LenaMatota/MechatronicsProject478/LaTex docs and packages/stellenbosch-2/stellenbosch-2/doc/templates/template-stb-report-eng/chaps-front/chap-symbols.tex

\chapter{List of symbols}
% Use stb-nomenclature + siunitx

\begin{Nomencl}[1cm]
\NomGroup{Abreviations}%-----------------------------------------------
    \item[3D] Three-dimensional
    \item[AI] Artificial Intelligence
    \item[AWG] American wire gauge
    \item[Back-EMF] Back electromotive force
    \item[CAD] Computer-Aided Design
    \item[D-H] Denavit-Hartenberg
    \item[DIP] Design Independent Parameter
    \item[DOF] Degrees-of-freedom
    \item[EC] Evaluation criteria
    \item[ECSA] Engineering Council of South Africa
    \item[EEPROM] Electrically erasable programmable read-only memory
    \item[EMF] Electromotive force
    \item[FBD] Freebody diagram
    \item[FEA] Finite element analysis
    \item[FR] Functional requirement
    \item[GPIO] General pin input/output
    \item[GPS] Global positioning system
    \item[HMI] Human machine interface
    \item[ISR] Interrupt service routine
    \item[MMF] Magnetomotive force
    \item[MOSFET] Metal-oxide-semiconductor field-effect transistor
    \item[NSoI] Narrower system of interest
    \item[PCMA] Portable coordinate measuring arm
    \item[PPR] Pulse per revolution
    \item[PSD] Position sensitive detector
    \item[SCADA] Supervisory control and data acquisition
    \item[SPAT] Single-point articulation test
    \item[SWG] Standard wire gauge
    \item[RHR] Right-hand rule
    \item[TPM] Technical performance measure
    \item[WSoI] Wider system of interest
\end{Nomencl}
