LenaMatota/MechatronicsProject478/LaTex docs and packages/stellenbosch-2/stellenbosch-2/doc/templates/template-stb-report-eng/chaps-front/chap-summary.tex

\chapter{Executive summary}
\noindent
\begin{longtable}{|p{\dimexpr \linewidth-1\tabcolsep-1\arrayrulewidth}|}
	
\hline%------------------------------------------------------------
\sumheading  Title of Project \\
\hline%------------------------------------------------------------
 Joint Design for a Portable Coordinate Measuring Arm (PCMA) \\[1ex]

\hline%------------------------------------------------------------
\sumheading  Objectives \\
\hline%------------------------------------------------------------
 To derive technical performance measures (TPMs) from an error-propagation model, and use them to design, build, and test a position-holding joint that produces a constant, reliable holding torque.\\[1ex]

\hline%------------------------------------------------------------
\sumheading  What is current practice and what are its limitations? \\
\hline%------------------------------------------------------------
 Current joints rely on counterbalancing and lack holding torque, meaning the operator must physically support the arm's weight during operation.\\[1ex]

\hline%------------------------------------------------------------
\sumheading  What is new in this project? \\
\hline%------------------------------------------------------------
 The introduction of a position-holding mechanism specifically engineered using mathematically derived TPMs.\\[1ex]

\hline%------------------------------------------------------------
\sumheading  If the project is successful, how will it make a difference? \\
\hline%------------------------------------------------------------
 It will directly maintain or improve the physical measurement accuracy of the arm. Additionally, it will yield a modified kinematic model to serve as a generalized framework for future accuracy analysis.\\[1ex]

\hline%------------------------------------------------------------
\sumheading  What are the risks to the project being a success? Why is it expected to be successful? \\
\hline%------------------------------------------------------------
 Risks: University workshop manufacturing capabilities may fall short of required tolerances, and the holding mechanism could introduce unwanted friction.
 Expectation of Success: The design requirements are heavily grounded in an established, proven error model.\\[1ex]

\hline%------------------------------------------------------------
\sumheading  What contributions have/will other students made/make? \\
\hline%------------------------------------------------------------
 The project builds directly upon an initial error-propagation model developed by Stellenbosch alumna Leon Hall.\\[1ex]

\hline%------------------------------------------------------------
\sumheading  Which aspects of the project will carry on after completion and why? \\
\hline%------------------------------------------------------------
 The modified error-propagation model. It will be able to accept custom arm dimensions and compute the uncertainty distribution within a given work volume, forming the mathematical foundation for future PCMA development.\\[1ex]

\hline%------------------------------------------------------------
\sumheading  What arrangements have been/will be made to expedite continuation? \\
\hline%------------------------------------------------------------
 Extensive, standardized documentation will be left behind to ensure future researchers can build directly onto this work without repeating groundwork.\\[1ex]

\hline%------------------------------------------------------------
\end{longtable}
