LenaMatota/MechatronicsProject478/Concept design report/Week 9 - Progress Meeting.pptx

Term 4 Week 3 – Progress Meeting

General Update
- Solenoid Yoke redesign
- Experimental setup should be ready be by tomorrow
  - Will confirm for safety verification via email
- Continuing with documentation
