LenaMatota/MechatronicsProject478/General Safety Induction/safety signs.docx

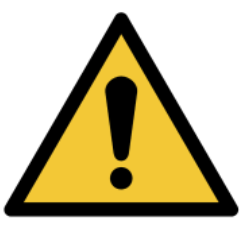
[picture p23: figure]

GENERAL WARNING

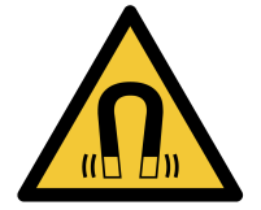
[picture p24: figure]

STRONG MAGNETIC FIELD

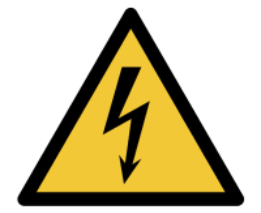
[picture p25: figure]

ELECTRICAL HAZARD

PLEASE DO NOT TOUCH AND KEEP YOUR DISTANCE

IN CASE OF AN EMERGENCY PLEASE CONTACT LENA MATOTA

CELL. NO: 071 569 2349

EMAIL: 24989142@sun.ac.za
