LenaMatota/MechatronicsProject478/SAIMechE Final Year Exhibition _ Poster Template.pdf

# Design, Build, and Test a PCMA Joint

Lena Matota, Kristiaan Schreve, Prof. Department of Mechanical and Mechatronics Engineering, Stellenbosch University

Lena Matota
Department of Mechanical and Mechatronics Engineering, Stellenbosch University
Email: 24989142@sun.ac.za
Website: https://www.linkedin.com/in/lena-matota Phone: +27 71 569 2349

## Contact Information

1. L. Engineering, “The advantages of using a portable cmm arm in metrology,” Leussink Engineering, 2024.
2. S. Ibaraki and R. Saito, “Novel kinematic model of articulated arm coordinate measuringmachinewithangularpositionmeasuremnterrors ofrotaryaxes,”CIRP Annals, vol. 72, no. 1, pp. 449–452, 2023.
3. B. Alvarez, E. Cuesta, P. Luque, D. Mantaras, and D. Muina, “Dynamic deformations in coordinate measuring arms using virtual simulation,” Internation Journal of Simulation Modelling, vol. 14, no. 4, pp. 609–620, 2015.
4. E. Cuesta, D. A. Mantaras, P. Luque, B. J. Alvarez, and D. Muina, “A calibration method of portable coordinate measuring arms by using artifacts,”MAPAN‑Journal of Metrology Society of India, vol. 34, no. 1, pp. 1–11, 2019.
5. L. Hall and K. Schreve, “Error distribution of an articulated arm measurement system,” (Stellenbosch, South Africa), July 2010.
6. H. Meagher, “Measurement tool spotlight‑ portable measuring arms.” OASIS Alignment Service, LLC, February 2016.
7. “Articulated arm coordinate measuring machine calibration by laser tracker multilateration,” The Scienti ic World Journal, vol. 2014, no. 1, p. 681853, 2014.
8. W. Callister and D. Rethwisch, Material Science and Engineering. Hoboken, NJ: Wiley, 8th ed., 2011.
9. FaroArmQuantumXSeries Series User Manual, March 2024.

## References

Portable Coordinate Measuring Arms (PCMAs) are a handheld, metrology instrument used to provide adaptable 3D measurement capabilities for in-line and on-site metrology. However, current joints lack position-holding abilities, due to manual operation. This introduces dynamic positional instability and dynamic structural deformation during measurement.

This project derives technical performance measures (TPMs) from a generalised error-propagation model to design, build, and test an electromagnetic brake integrated with a PCMA joint that maintains measurement accuracy.

## Abstract

## Introduction

- Kinematic Modelling: Generated a six-DOF D-H model based on the Faro QuantumX arm to map spatial coordinate transformations (see Figure 1).
- Error Analysis: Modified and generalised an error-propagation model, first modelled by Stellenbosch Alumnus, Leon Hall, in MATLAB to create uncertainty distributions across a sampled workspace (ranging from 56 to 74 microns).
- Concept Selection: Generated the concepts shown in Figure 3 below. Through evaluation, the PCMA joint with an electromagnetic brake (Figure 3c) was chosen for its superior load capacity and positional stability.

Design Refinement: The electromagnetic brake design was refined into an assembly utilising an optical encoder (GTS06-OC-RA1000B-2M), RS PRO 2-row ball bearings, an IRF640N MOSFET low-side switch controlled by an STM32 Nucleo microcontroller, and an XL7015 step-down buck converter.

## Methods and System Design

- Prototype Implementation Scope: Due to project timelines, material availability and workshop capability, manufacturing and testing focused on constructing key components of the joint design, namely, the electromagnet.
- Fabrication Constraints: Working within workshop capabilities required balancing theoretically requirements against practical manufacturing tolerances, successfully validating core mechanical and electrical operation while highlighting areas for future scale-up.

## Discussion and Prototype Evaluation

Background
- PCMAs operate via multi-axis arm segments equipped with high-resolution angular encoders to capture 3D coordinates.
- Manual operation of the PCMAs causes positional instability and structural deformations because the joints cannot fix their positions independently.

Aim
Design, build and test and PCMA joint with position-holding capabilities without jeopardising its accuracy and ease of movement.

Objectives
Generalise the Denavit-Hartenberg (D-H) model, design and test key joint components, and integrate test results into the model to assess feasibility.

Figure 1. D-H model of Faro QuantumX arm.

REPLACE THIS BOX WITH THE
MAIN SPONSOR’S
ORGANIZATION’S
HIGH RESOLUTION LOGO

I would like to express my gratitude to my supervisor, Prof. K. Schreve, for his guidance, expert insight, and continuous support throughout this project. Special thanks is extended to the technical staff of the Department of Mechanical and Mechatronics Engineering, as well as the Department of Electrical and Electronics Engineering for their assistance with prototype fabrication and component sourcing. Lastly, I grateful to my family and peers for their constant encouragement and support throughout my studies at Stellenbosch University.

## Acknowledgements

- Ongoing Performance Verification: Conclude full experimental validation of the prototype’s holding force capacity under operational cycles as seen in the setup depicted by Figure 5.

## Future Directions

REPLACE THIS BOX WITH
YOUR ORGANIZATION’S
HIGH RESOLUTION LOGO

Figure 2. Error-Propagation Model

Figure 3. Generated Concepts

Figure 3a. PCMA Joint with Locking Dial

Figure 3b. PCMA Joint with Counterbalance Spring

Figure 3c. PCMA Joint with Electromagnetic Brake

Figure 4a. PCMA Joint with Electromagnetic Brake Assembly

Figure 4b. Wiring Diagram of electronics implementation
Figure 4. Refined PCMA design

Figure 5. Testing Setup
