LenaMatota/MechatronicsProject478/LaTex docs and packages/stellenbosch-2/stellenbosch-2/doc/templates/template-stb-report-eng/template-stb-report-eng.tex

% !TeX encoding = UTF-8
% !TeX program  = xelatex

\documentclass[12pt,a4paper,openany]{book} 
\usepackage[typeblock=golden]{stb-titlepage}        

%==== Math setup =====================================================
\usepackage{amsmath}%............................. Advanced math (before fonts)
%\usepackage{amssymb}%............................ AMS Symbol fonts

%==== Font setup =====================================================
\usepackage{iftex}
\ifxetex
    \usepackage[math-style=TeX,
                bold-style=TeX,
               ]{unicode-math}
    \setmainfont{Cambria}%........................ Unicode fonts  (Win)                
    \setsansfont[Scale=MatchLowercase]{Calibri}
    \setmonofont[Scale=MatchLowercase]{Consolas}
    \setmathfont{Cambria Math}
    \defaultfontfeatures{Ligatures=TeX}
    \let\bm\symbfit
\else
    \usepackage[utf8]{inputenc}%.................. Unicode file format
    \usepackage{textcomp}%........................ Additional text symbols
    \usepackage[T1]{fontenc}%..................... Type 1 outline fonts
    \usepackage{bm}%.............................. Bold math fonts
\fi
\normalfont
\usepackage[expansion=false, protrusion=true]{microtype}
\usepackage{float}
\usepackage{enumitem}
\usepackage[table]{xcolor}

%==== Units and numbers ==============================================
\usepackage{siunitx}%............................. Unit, number and angle output
    \sisetup{detect-all = true, detect-family = true}
    \sisetup{output-decimal-marker = {.} ,
             group-separator = {\,},
             number-unit-product = {\,},
             inter-unit-product = \mathord{\cdot},
             exponent-product = \mathord{\times},
             separate-uncertainty = true}
         
%==== Ref's, Bib's and Nomencl =======================================
\usepackage{stb-nomencl}%......................... List of symbols 
\renewcommand*{\UnitLabel}[1]{~[\,\unit{#1}\,]}
\usepackage{stb-bib}%............................. Bibliography (natbib internally)
\usepackage{pdfpages}
\usepackage{multirow}
\setcitestyle{numbers} % <--- THIS IS THE MISSING LINE
\bibliographystyle{ieeetr}
\renewcommand\bibfont{\small}
\renewcommand\bibsection{\chapter{\bibname}}

%==== Tables + Graphics + Color =====================================
\usepackage{array}%............................... Extended table defs 
    \setlength{\extrarowheight}{2pt}
\usepackage{longtable}%........................... Tables can break over pages
\usepackage{tabularx}
\usepackage{xltabular}
\usepackage{graphicx}%............................ Included graphics
\graphicspath{{chaps-main/}{chaps-append/}} % <--- ADD THIS LINE
\usepackage[font=small]{caption}%................. Customize captions  
\usepackage[table]{xcolor}%....................... Color setup + colortbl 
\usepackage{subcaption}
\usepackage{booktabs}
\usepackage{threeparttable}
\usepackage[bottom]{footmisc}
\usepackage{pdflscape}
    
%==== Extra defs for template ========================================
\makeatletter
%---- TOC entries and case
    \renewcommand\contentsname{Table of contents}
    \renewcommand\listfigurename{List of figures}
    \renewcommand\listtablename{List of tables}
    \renewcommand\bibname{List of references}
    
    \renewcommand\tableofcontents{\chapter*{\contentsname}\@starttoc{toc}}
    \renewcommand\listoffigures{\chapter{\listfigurename}\@starttoc{lof}}
    \renewcommand\listoftables{\chapter{\listtablename}\@starttoc{lot}}

%---- Plagiarism signatures
    \newcommand\tstrut[1][4ex]{\rule{0pt}{#1}}
    \newcommand\tdots[1][5cm]{\makebox[#1]{\dotfill}}

%---- Summary head line
    \newcommand\sumheading{%
        \rowcolor[gray]{.9}%
        \centering\arraybackslash%
        \bfseries\normalsize}

%==== User Defs ======================================================
%
% Please insert user defined commands here
% and NOT in the document itself!
%
%
\makeatother

%==== Title Page =====================================================
\title{\textbf{Joint Design for a Portable Coordinate Measuring Arm (PCMA)}\\[2ex]
       \large Mechatronic Project 478\\Final Report\\[2ex]}                   
\author{\Large Author: Lena Matota\\ 
        \large 24989142 \\[5ex]
        \Large Supervisor: Prof. K Schreve}                
\address{Department of Mechanical and Mechatronic Engineering\\
        Stellenbosch University \\
        Private Bag X1, Matieland 7602, South Africa.}
\date{2026/10/23}                             
\Copyright{2023}{Stellenbosch University.\\ All rights reserved.}

%==== Main Document ==================================================
\setcounter{secnumdepth}{3}
\setcounter{tocdepth}{2}
\raggedbottom
\begin{document}   

\frontmatter%---------------------------------------------------------                    
\maketitle 

\include{chaps-front/chap-plagiarism}
\include{chaps-front/chap-AI-use-2024}
\include{chaps-front/chap-summary}
\include{chaps-front/chap-ECSA}
\include{chaps-front/chap-acknowledge}

% Use \chapter*{} before TOC
\tableofcontents
% Use \chapter{} after TOC

\listoffigures
\listoftables
\include{chaps-front/chap-symbols}

\let\cleardoublepage\clearpage
\mainmatter%----------------------------------------------------------
\numberwithin{figure}{chapter}
\numberwithin{table}{chapter}

\include{chaps-main/chap-intro}
\include{chaps-main/chap-literature}
\include{chaps-main/chap-requirement_analysis}
\include{chaps-main/chap-concept_development}
\include{chaps-main/chap-design_analysis}
\include{chaps-main/chap-design_evaluation_and_testing}
\include{chaps-main/chap-eol}
\include{chaps-main/chap-conclusion}

\appendix%------------------------------------------------------------
\include{chaps-append/chap-bom}              
\include{chaps-append/chap-design_calc}     
\include{chaps-append/chap-drawing_pack}     
\include{chaps-append/chap-project_schedule} 

\backmatter%----------------------------------------------------------
\bibliography{bib/bib-sample}
 
\end{document}
