LenaMatota/MechatronicsProject478/LaTex docs and packages/stellenbosch-2/stellenbosch-2/doc/templates/template-stb-report-eng/chaps-front/chap-plagiarism.tex

\chapter*{Plagiarism Declaration}
%\section*{Plagiarism Declaration}

\begin{enumerate}
	\item Plagiarism is the use of ideas, material and other intellectual property of another's work and to present it as my own.
	
	\item I agree that plagiarism is a punishable offence because it constitutes theft.
	
	\item I also understand that direct translations are plagiarism.
	
	\item Accordingly all quotations and contributions from any source whatsoever (including the internet) have been cited fully. I understand that the reproduction of text without quotation marks (even when the source is cited) is plagiarism.
	
	\item I declare that the work contained in this assignment, except where otherwise stated, is my original work and that I have not previously (in its entirety or in part) submitted it for grading in this module/assignment or another module/assignment.
\end{enumerate}
\noindent
\begin{tabularx}{\textwidth}{|X|p{4cm}|}
	\hline
	&                       \\[4ex]
	Student number          & Signature \\
	\hline
	&                       \\[4ex]
	Initials and surname    & Date      \\
	\hline
\end{tabularx}
