LenaMatota/MechatronicsProject478/LaTex docs and packages/stellenbosch-2/stellenbosch-2/doc/templates/template-stb-report-eng/chaps-front/chap-AI-use-2024.tex

\chapter*{AI Use Declaration}

{\setlength\labelwidth{1em}%
 \setlength\labelsep{5pt}%
 \setlength\itemindent{0pt}%
 \setlength\leftmargini{\labelwidth}%
 \setlength\topsep{0pt}%
 \setlength\partopsep{0pt}%
\begin{enumerate}
    \setlength\itemsep{\smallskipamount}%
    \setlength\parskip{0pt}%
    \small
    
    \item I am convinced and can support my claim that my assessment product is an indication of my own learning, knowledge, skills, and understanding.
    
    \item Where I have used AI tools for enhancing my own creation of ideas and words, I acknowledge that I have to declare it.
    
    \item Where I have used AI tools for generating new ideas, words, code, image-prompts for other AI Image-generating tools, or structure and even presentations (or other AI tools that can be used as assistants to the knowledge building and representing process), I have declared and documented the use of such tools and I am prepared to talk about the process I used and what it contributed to my learning and insights.
    
    \item I am aware that the lecturer can ask me to demonstrate my learning, for example through explaining the choices I made in terms of approach, content used, literature selected, conclusions drawn, etc. through an additional assessment like an oral (for example).
    
    \item I understand that if I am not able to agree to the above points, there is a chance that my academic behaviour will be deemed unethical and might lead to a disciplinary case being brought against me on the grounds of cheating or plagiarism and that the standard procedures for such behaviour will be followed.
    
    \item As per the Disciplinary Code of SU (par. 10.2.1 and 10.2.2), I understand that I take responsibility for the integrity of my work, which includes the obligation to ask for clarification from an academic member of staff if I am unsure of anything, and that I strictly adhered to all instructions received in the course of the academic assessment by relevant and authorized staff (whether the instruction is in oral or written format).
    
    \item I understand that when I am not able to document and declare my use of AI tools, this behaviour will be deemed as cheating in examinations and assessments (Disciplinary Code 1.1 c.) as I referred to “unauthorized notes, books, electronic devices or other reference material”.
\end{enumerate}}
\vspace{10mm}

\noindent
\begin{tabular}{@{}lllll@{}}
\tstrut Signature: &\tdots&	           &            \\
\tstrut Name:      &\tdots& Student no:&\tdots[3cm] \\
\tstrut Date:      &\tdots&            &            \\
\end{tabular}
