LenaMatota/MechatronicsProject478/Executive Summary.docx

# Executive Summary

Title of Project

Objectives

What is current practice and what are its limitations?

What is new in this project?

If the project is successful, how will it make a difference?

What are the risks to the project being a success? Why is it expected to be successful?

What contributions have/will other students made/make?

Which aspects of the project will carry on after completion and why?

What arrangements have been/will be made to expedite continuation?
