LenaMatota/MechatronicsProject478/Week 3/Week 3 - Progress Review.pptx

Week 3 Progress Meeting – L Matota, 24989142

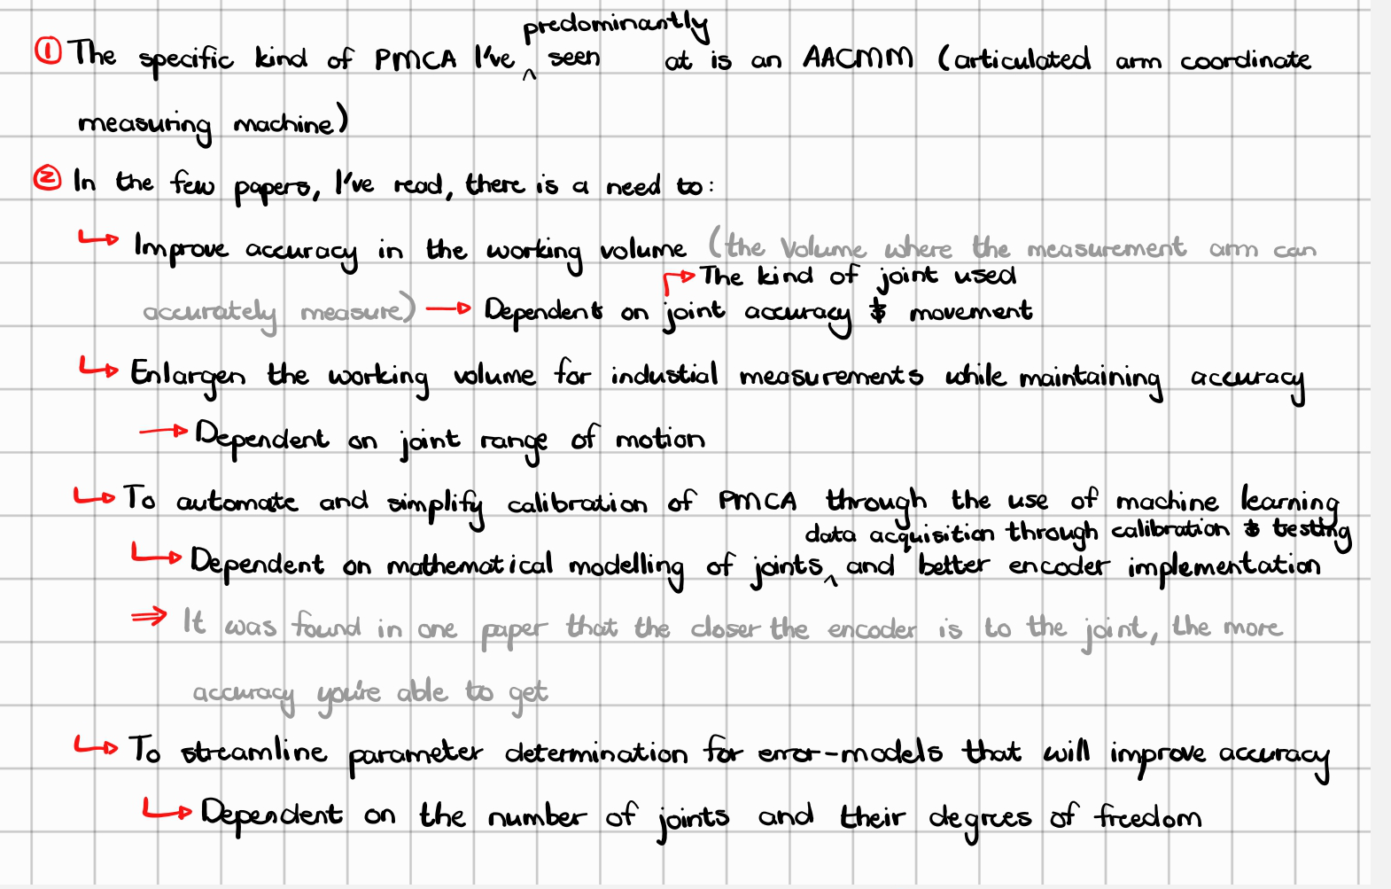
[picture p43: figure]
