LenaMatota/MechatronicsProject478/Concept design report/AI -generated concept designs w-o heading.png

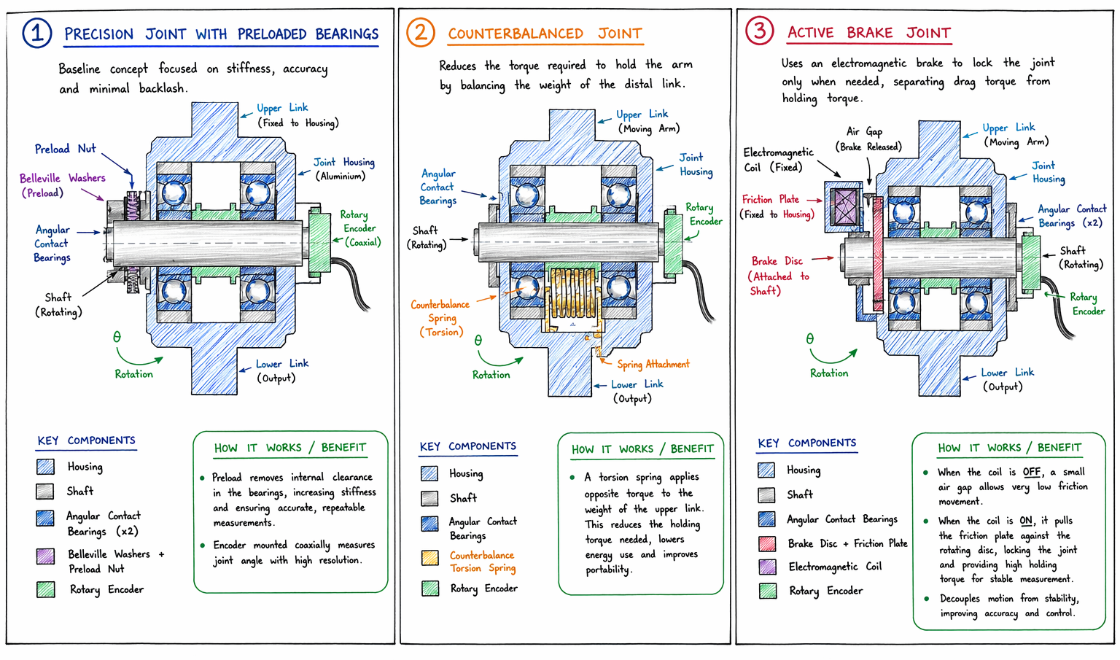
Concept design report/AI -generated concept designs w-o heading.png
