LenaMatota/MechatronicsProject478/Concept design report/AI -generated concept designs.png

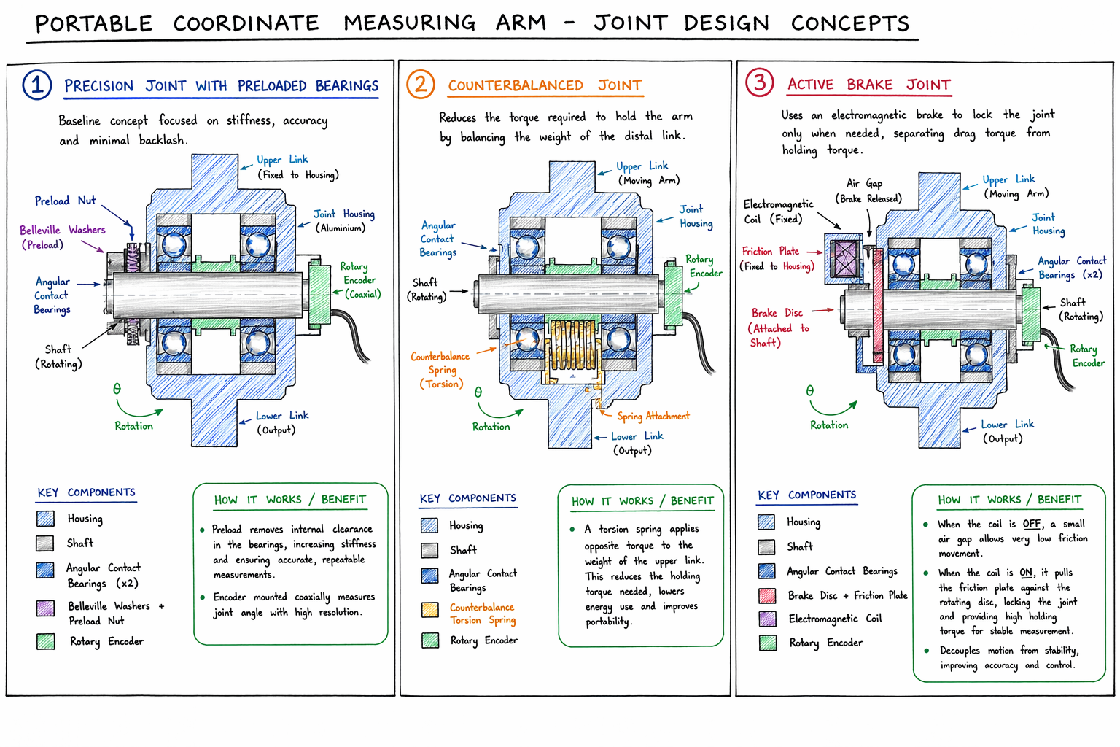
Concept design report/AI -generated concept designs.png
