LenaMatota/MechatronicsProject478/Concept design report/Concept 1.png

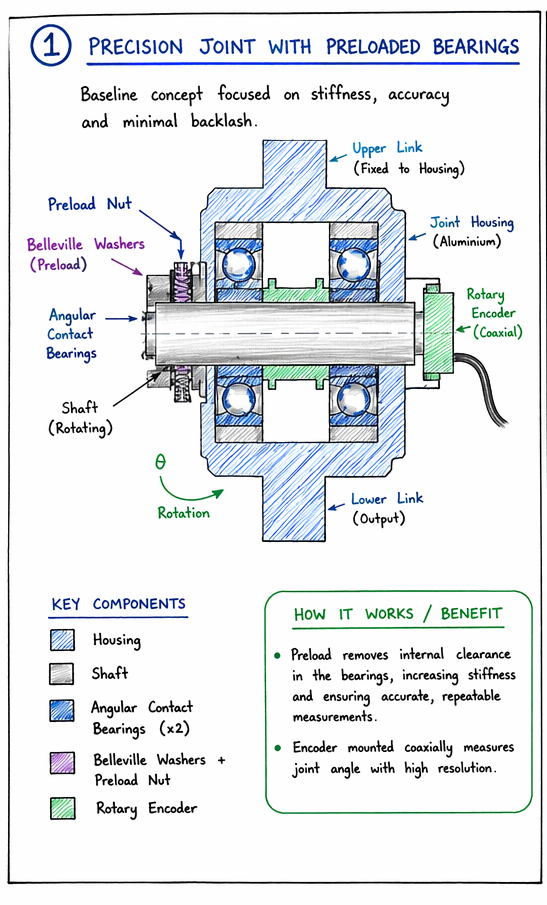
Concept design report/Concept 1.png
