LenaMatota/MechatronicsProject478/Concept design report/Concept 2.png

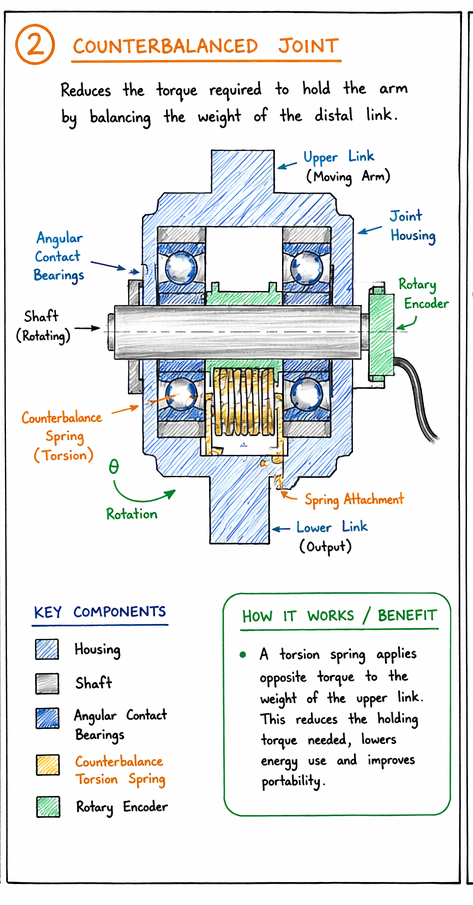
Concept design report/Concept 2.png
