LenaMatota/MechatronicsProject478/Concept design report/Concept 3.png

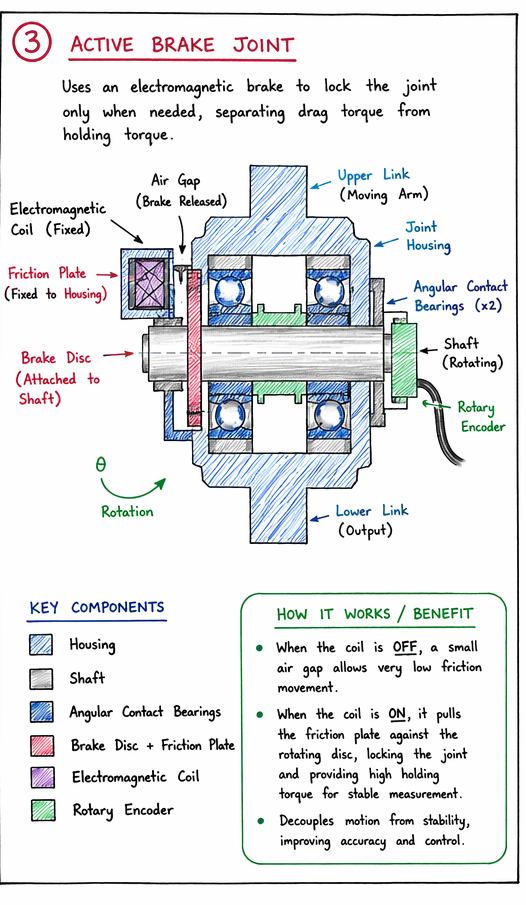
Concept design report/Concept 3.png
