LenaMatota/MechatronicsProject478/Concept design report/DH model of Faro arm.png

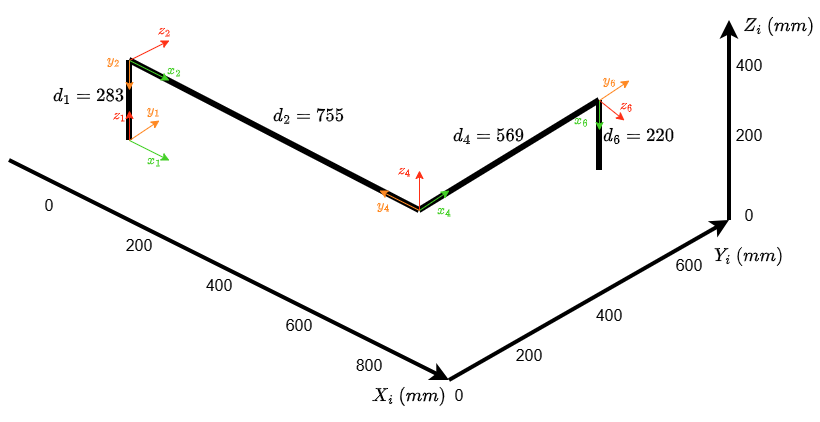
Concept design report/DH model of Faro arm.png
