LenaMatota/MechatronicsProject478/Concept design report/Final concept with labels.jpg

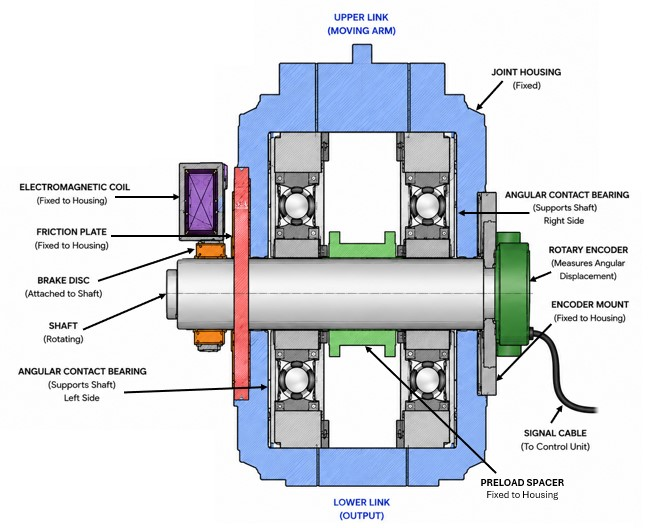
Concept design report/Final concept with labels.jpg
