LenaMatota/MechatronicsProject478/Concept design report/Powerpoint slides background.jpg

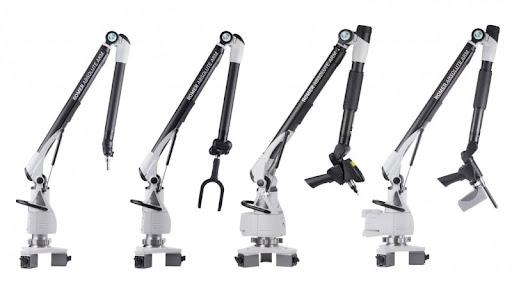
Concept design report/Powerpoint slides background.jpg
