LenaMatota/MechatronicsProject478/General Safety Induction/Screenshot_20260914_224840_Samsung Notes.jpg

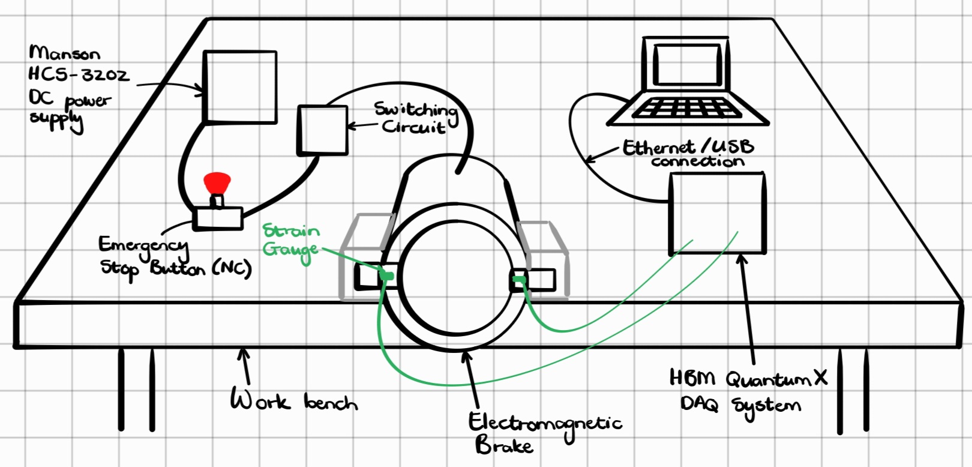
General Safety Induction/Screenshot_20260914_224840_Samsung Notes.jpg
