LenaMatota/MechatronicsProject478/General Safety Induction/Wear eye protection.png

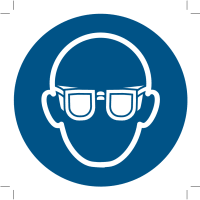
General Safety Induction/Wear eye protection.png
