LenaMatota/MechatronicsProject478/Lena's skripsie vlog/20260921_082056.jpg

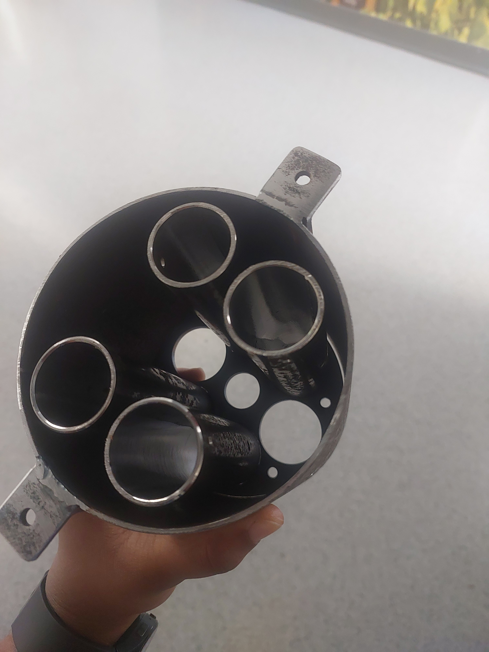
Lena's skripsie vlog/20260921_082056.jpg
