LenaMatota/MechatronicsProject478/Lena's skripsie vlog/IMG-20260922-WA0012.jpeg

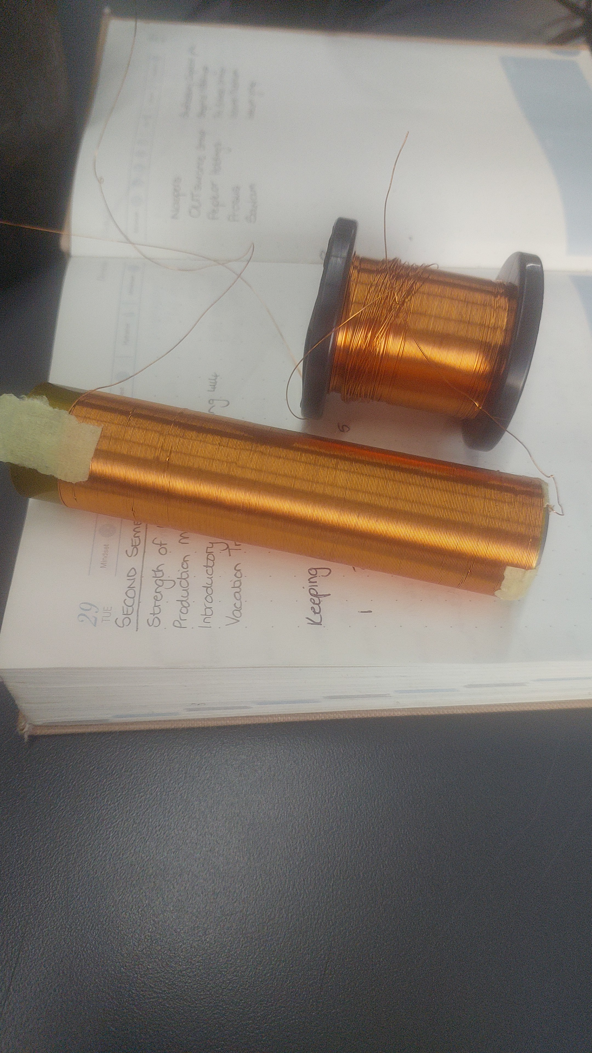
Lena's skripsie vlog/IMG-20260922-WA0012.jpeg
