LenaMatota/MechatronicsProject478/Week 3/Screenshot_20260224_151306_Samsung Notes.jpg

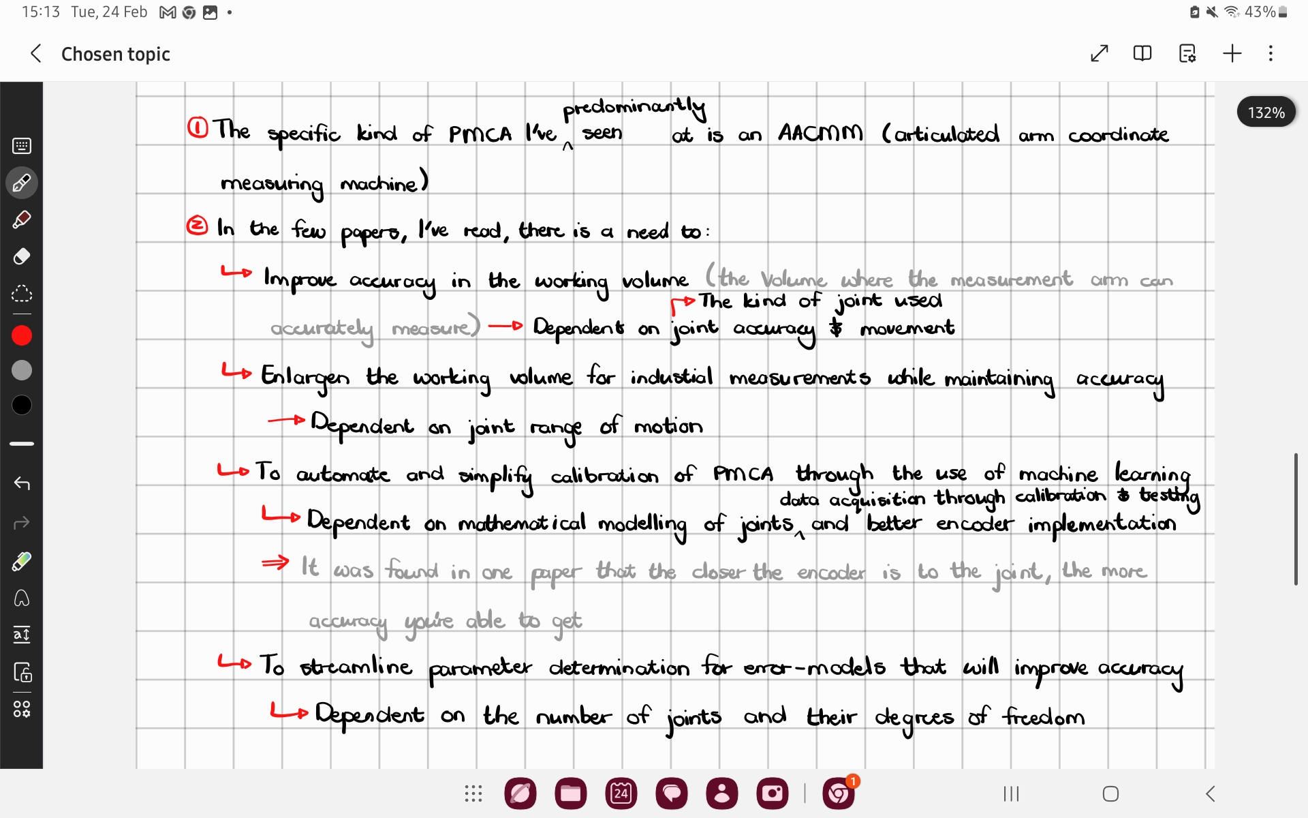
Week 3/Screenshot_20260224_151306_Samsung Notes.jpg
