LenaMatota/MechatronicsProject478/LaTex docs and packages/stellenbosch-2/stellenbosch-2/doc/templates/template-stb-report-eng/chaps-append/chap-bom.tex

\chapter{Bill of Materials}
\label{ch:bill_of_materials}

This appendix provides the itemized Bill of Materials (BOM) for the electromagnetic brake joint assembly. All prices reflect verified vendor quotations, retail receipts, and university workshop billing records inclusive of 15\% VAT.

\begin{table}[H]
	\centering
	\caption{Detailed Bill of Materials (BOM) for Joint Prototype}
	\label{tab:detailed_bom}
	\resizebox{\linewidth}{!}{%
		\begin{tabular}{lllccrr}
			\toprule
			\textbf{Category} & \textbf{Part Description} & \textbf{Supplier / Part No.} & \textbf{Qty} & \textbf{Unit Price} & \textbf{Total (ZAR)} \\
			\midrule
			\textbf{Mechanical}  & Laser-cut Electromagnetic Cover & Fabrinox / 24989142-01-01 & 5 & R 25.81 & R 129.05 \\
			& Laser-cut Pressure Platform     & Fabrinox / 24989142-01-02 & 5 & R 2.38  & R 11.90 \\
			& Laser-cut Friction Plate        & Fabrinox / 24989142-01-03 & 5 & R 9.18  & R 45.90 \\
			& 20mm ID 2-Row Ball Bearings     & RS / 2204-2RSTN           & 2 & R 345.29 & R 690.58 \\
			& Ruland Rigid Shaft Coupling     & RS / MCLX-20-20-F         & 1 & R 869.67 & R 869.67 \\
			& 32mm OD Steel Shaft Collars     & RS / 8236976              & 2 & R 62.42  & R 124.84 \\
			& Raw Material Steel / Aluminium  & SU Workshop Stock         & 1 & R 3 084.81 & R 3 084.81 \\
			\midrule
			\textbf{Electrical}  & Enamelled Copper Wire (0.28mm)  & RS / CUL 100/0,28         & 4 & R 187.66 & R 750.64 \\
			& Infrared IRF640NPBF MOSFETs     & RS / IRF640NPBF           & 6 & R 24.05  & R 144.30 \\
			& Schottky Diodes STPS20H100CT    & RS / STPS20H100CT         & 6 & R 9.12   & R 54.72 \\
			& Red Hook-Up Wire (4m Reel)      & RS / 50747-4              & 2 & R 226.17 & R 452.34 \\
			& High-Temp Kapton Insulation Tape & Takealot Retail           & 1 & R 299.99 & R 299.99 \\
			& TIP41C / 2N3904 BJTs \& Board    & Lab Stock                 & 1 set & R 120.00 & R 120.00 \\
			\midrule
			\textbf{Sensors \&}  & Optical Encoder (1000 PPR)      & Micro Robotics / GTS06    & 1 & R 668.00 & R 668.00 \\
			\textbf{Power}       & Step-Down Buck Regulator        & Micro Robotics / XL7015   & 1 & R 30.00  & R 30.00 \\
			& Shipping \& Delivery Fees       & RS / Micro Robotics       & 1 set & R 567.77 & R 567.77 \\
			\midrule
			\textbf{Labor}       & Workshop Machining (18.5 hrs)   & SU Workshop / Paulse      & 18.5 & R 650.00 & R 12 025.00 \\
			\midrule
			\textbf{Grand Total} & & & & & \textbf{R 19 977.55} \\
			\bottomrule
		\end{tabular}%
	}
\end{table}
