LenaMatota/MechatronicsProject478/Skripsie resources/List of Equipment Available in Mechanical & Mechatronic Engineering Store 2026.xlsx

Sheet: List of HBM Equipment
LOADCELLS |  |  |  |  |  | Booked Out
Type | Asset Number | Serial Number | Range | Cost-Point used with Purchase | Remarks | Name | Student Number | Date Taken
Round Type-U2A | '400064'!A1 | B73498 | 10kN - 1000kg | 0280 |  | E Stockhalm | 23648341 | 18/08/2025 | RETURNED
Round Type-U2A | '400065'!A1 | C16754 | 10kN - 1000kg | 0280 |  | A. Turner | 25928333 | 2025-10-08 | RETURNED
Round Type-U2A | '400067'!A1 | F23715 | 10kN - 1000kg | 0280 |  | M. Nimb | 24776661 | 2025-10-08 | RETURNED
Round Type-U2A | '400066'!A1 | E99828 | 2kN - 200kg | 0280 | Broken | M. Nimb | 24776661 | 26/08/2025 | RETURNED
Round Type | '408763'!A1 | 088671 | 500N - 50kg | 0280N |  | James Ralph | 19904150 | 2023-06-03 | RETURNED
Round Type | '408764'!A1 | 083931 | 1kN - 100kg | 0280N |  | Name | Student Number | Date Taken | Date Returned
U2AD1/2T - Round Type | '485376'!A1 | 026925 | 20kN - 2000kg |  |  | JW Van Santen | 18326498 | 20/07/2020 | RETURNED
U2AD1/2T - Round Type | '485377'!A1 | 028563 | 20kN - 2000kg |  |  | JW Van Santen | 18326498 | 20/07/2020 | RETURNED
Z-Type SM2 | '443733'!A1 | 02718726 | 50N - 5kg | 0280N |  | AV Covoy | 19774869 | 2021-12-10 | RETURNED
Z-Type SM2 | '443734'!A1 | 02718733 | 50N - 5kg | 0280N |  | Steenkamp | 19777701 | 2021-09-04 | 18/05/2021
Z-Type SM2 | '443735'!A1 | 02718686 | 50N - 5kg | 0280N |  | L De Wet | 23743468 | 2022-09-08 | RETURNED
Z-Type SM2 | '443736'!A1 | 02918009 | 50N - 5kg | 0280N |  | L De Wet | 23743468 | 21/08/2023 | RETURNED
Z-Type SM2 | '443610'!A1 | 02918017 | 50N - 5kg | 0284N |  | G Stephan | 20150679 | 15/09/2020 | 29/01/2021
Z-Type SM2 | '443737'!A1 | 02549146 | 100N - 10kg | 0280N | Broken | Name | Student Number | Date Taken | Date Returned
Z-Type SM2 | '443738'!A1 | 02718704 | 100N - 10kg | 0280N |  | Name | Student Number | Date Taken | Date Returned
Z-Type SM2 | '443739'!A1 | 02718813 | 100N - 10kg | 0280N |  | E Stockhalm | 23648341 | 20/08/2025 | OUTSTANDING
Z-Type SM2 | '443740'!A1 | 02718808 | 100N - 10kg | 0280N |  | J Van Zyl | 20858795 | 18/08/2022 | 26/04/2023
Z-Type SM2 | '443741'!A1 | 02917885 | 200N - 20kg | 0280N | Broken | Name | Student Number | Date Taken | Date Returned
Z-Type SM2 | '443742'!A1 | 02917886 | 200N - 20kg | 0280N | Broken | CR Sauls | 20778465 | 14/10/2021 | RETURNED
Z-Type SM2 | '443743'!A1 | 02917896 | 200N - 20kg | 0280N | Broken | Name | Student Number | Date Taken | Date Returned
Z-Type SM2 | '443744'!A1 | 02917906 | 200N - 20kg | 0280N |  | Josua Van Tonder | 21059721 | 16/09/2022 | 2023-05-09
 |  |  |  |  |  | Petrus Haasbroek | 19855400 | 2022-02-11 | 2023-05-09
Z-Type SM2 | '443745'!A1 | 31050691 | 1kN - 100kg | 0280N |  | Nadeem Davids | 21160503 | 2023-08-11 | 14/08/2023
Z-Type SM2 | '443748'!A1 | 31137976 | 1kN - 100kg | 0280N | Broken | Name | Student Number | Date Taken | Date Returned
Z-Type SM2 | '443746'!A1 | 31127524 | 5kN - 500kg | 0280N |  | PC Swanepoel | 16622766 | 2025-04-11 | RETURNED
Z-Type SM2 | '443747'!A1 | 31127531 | 5kN - 500kg | 0280N | Broken | PC SWanepoel | 16622766 | 2025-04-09 | RETURNED
U2B 200kN | '459962'!A1 | N79647 | 200kN | 0280N |  | JW van Santen | 18326498 | 2019-11-18 | RETURNED
U2B 100kN | '459961'!A1 | N87983 | 100kN | 0280N |  | JW van Santen | 18326498 | 2019-11-18 | RETURNED
U2B 50kN | '459960'!A1 | N99085 | 50kN | 0280N |  | Daniel Raats | 21645655 | 2024-05-03 | RETURNED
U2B 20kN | '459959'!A1 | N93342 | 20kN | 0280N |  | R Louw | 22550798 | 14/09/2022 | RETURNED
S9M/10kN | '487810'!A1 | 31733148 | 10kN - 1000kg |  |  | C vd Westhuizen | 24194379 | 2025-04-30 | RETURNED
U9C/2kN | '468620'!A1 | 211010672 | 2kN - 200kg |  |  | Josua Van Tonder | 1902243 | 2020-12-10 | RETURNED
SP4C3 |  | 00495870 | 20kg
SP4C3 |  | 01373560 | 20kg
SP4C3 |  | 29306036 | 20kg
SP4C3 |  | 29330086 | 20kg
SP4C3 |  | 11602081 | 30kg
SPM4C3MR |  | 02184452 | 30kg
SP4C3
PRESSURE TRANSDUCERS |  |  |  |  |  | Booked Out
Type | Asset Number | Serial Number | Range | Cost-Point used with Purchase | Remarks | Name | Student Number | Date Taken | Date Returned
Absolute Pressure | '466932'!A1 | 801247177 | 0-10 BAR | 0280N |  | Jaco Laas | 24483451 | 03 Junie 2021 | RETURNED
Absolute Pressure | '466933'!A1 | 801222951 | 0-10 BAR | 0280N |  | Chaz Fenner | Student Number | 15/02/2021 | RETURNED
Absolute Pressure | '466934'!A1 | 801247177 | 0-10 BAR | 0280N |  | S De WIT | 21586144 | 2021-01-10 | Returned
Absolute Pressure | '466935'!A1 | 801247177 | 0-10 BAR | 0280N |  | Name | Student Number | Date Taken | Date Returned
Absolute Pressure | '466936'!A1 | 801245349 | 0-10 BAR | 0280N |  | D Sheni | 22594671 | 2022-03-10 | RETURNED
Absolute Pressure | '466937'!A1 | 801245349 | 0-10 BAR | 0280N |  | 22594671 | Sheni | 2022-03-10 | RETURNED
Absolute Pressure | '466938'!A1 | 801245349 | 0-10 BAR | 0280N |  | D Sheni | 22594671 | 2022-03-10 | RETURNED
Absolute Pressure | '466939'!A1 | 801245349 | 0-10 BAR | 0280N |  | Jaco Laas | 24483451 | 2022-11-04 | RETURNED
CLIP AMPLIFIERS |  |  |  |  |  | Booked Out
Type | Asset Number | Serial Number |  | Cost-Point used with Purchase | Remarks | Name | Student Number | Date Taken | Date Returned
AE301 | '459967'!A1 | 824761013 | - | 0280N |  | Name | Student Number | Date Taken | Date Returned
AE301 | '459968'!A1 | 824761014 | - | 0280N |  | Name | Student Number | Date Taken | Date Returned
AE301 | '459969'!A1 | 824761015 | - | 0280N |  | Name | Student Number | Date Taken | Date Returned
AE301 | '459970'!A1 | 824761032 | - | 0280N |  | Name | Student Number | Date Taken | Date Returned
AE301 | '443753'!A1 | 819402718 | - | 0280N |  | Name | Student Number | Date Taken | Date Returned
AE301 | '253339'!A1 |  | - | 0280 |  | Name | Student Number | Date Taken | Date Returned
AE301 | '443752'!A1 | 819402717 | - | 0280N |  | Name | Student Number | Date Taken | Date Returned
AE301 | '485261'!A1 |  | - | 0290N |  | Name | Student Number | Date Taken | Date Returned
AE301 | '485262'!A1 |  | - | 0290N |  | Name | Student Number | Date Taken | Date Returned
AE301 | '485263'!A1 |  | - | 0290N |  | Ruan Louw | 22558798 | 14/09/2022 | 2022-12-10
AE301 | '485264'!A1 |  | - | 0290N |  | Name | Student Number | Date Taken | Date Returned
AE301 | '485265'!A1 |  | - | 0290N |  | Name | Student Number | Date Taken | Date Returned
AE501 | '253343'!A1 |  | - | 0280 |  | Name | Student Number | Date Taken | Date Returned
AE501 | '253340'!A1 |  | - | 0280 |  | Name | Student Number | Date Taken | Date Returned
AE501 | '459971'!A1 | 824734801 | - | 0280N |  | B Ndika | Student Number | Date Taken | RETURNED
AE501 | '459972'!A1 | 824734823 | - | 0280N |  | Name | Student Number | Date Taken | Date Returned
AE501 | '459973'!A1 | 824734824 | - | 0280N |  | Llewellyn | Student Number | Date Taken | Date Returned
AE501 | '459974'!A1 | 824734825 | - | 0280N |  | Name | Student Number | Date Taken | Date Returned
AE501 | '253341'!A1 |  | - | 0280 |  | Name | Student Number | Date Taken | Date Returned
AE501 | '253342'!A1 |  | - | 0280 |  | Name | Student Number | Date Taken | Date Returned
AE501 | '253344'!A1 |  | - | 0280 |  | Name | Student Number | Date Taken | Date Returned
AE501 | '253345'!A1 |  | - | 0280 |  | Name | Student Number | Date Taken | Date Returned
AE501 | '443750'!A1 |  | - | 0280N |  | Name | Student Number | Date Taken | Date Returned
AE501 | '443751'!A1 | 819334204 | - | 0280N |  | MC Nimb | 24776661 | 28/08/2025 | OUTSTANDING
QUANTUMX |  |  |  |  |  | Booked Out
Type | Asset Number | Serial Number | Description | Cost-Point used with Purchase | Remarks | Name | Student Number | Date Taken | Date Returned
MX410 | '443758'!A1 | 0009E5004CE6 | 4-Channel | 0280N |  | SJ NOland | 3581662 | 2025-09-17 | RETURNED
MX410 | 441960'!A1 | 0009E5004B96 | 4-Channel | 0280N | Channel 1 Faulty | PC Swanepoel | 16622766 | 2025-04-14 | OUTSTANDING
MX840B | '459956'!A1 | 0009E5007DD | 8-Channel | 0280N | Channel 5 Faulty | James Ralph | 23233737 | 2025-04-14 | RETURNED
MX440B | '466921'!A1 | 0009E5007DDB | 4-Channel | 0280N | Was al herstel | EM LOUW | 24817236 | 2021-08-02 | RETURNED
MX440B | '485408'!A1 | 0009E500E684 | 4-Channel | 0284N | New - Dr Els? | Name | Student Number | Date Taken | Date Returned
MX1601B | '450521'!A1 | 801218167 | 16-Channel | 0280N | Used on SA Agulhas | DR Adams | 20299028 | 30/08/2022 | 2021-03-08
MX1609 | '443757'!A1 | 0009E50044F1 | 6-Channel Thermocouple | 0280N |  | Tamara Allen | 19944306 | 2021-08-06 | RETURNED
MX440B | '459957'!A1 | 0009E5007AOA | 4-Channel | 0280N |  | JM Wahl | 25939114 | 2025-09-08 | RETURNED
MX460B | 536093'!A1 | 0009E5024A7A | 4-Channel |  |  | Llewellyn | 22793429 | 2025-03-28 | RETURNED
MX840B | 437406'!A1 | 0009E5026584 | 8-Channel |  |  | Mr. J Bredell | 22793429 | 2025-08-05 | RETURNED
MX1615 |  |  | 8-Channel
QUANTUMX |  | 801433534 | 15-Channel
QUANTUMX |  | 801433534 | Strain gauge quarter-bridge
QUANTUMX |  | 801433534 | Strain gauge quarter-bridge
QUANTUMX |  | 801433534 | Strain gauge quarter-bridge
QUANTUMX |  | 801433534 | Strain gauge quarter-bridge
QUANTUMX |  | 801433534 | Strain gauge quarter-bridge
QUANTUMX |  | 801433534 | Strain gauge quarter-bridge
QUANTUMX |  | 801433534 | Strain gauge quarter-bridge
DISPLACEMENT METERS |  |  |  |  |  | Booked Out
Type | Asset Number | Serial Number | Range | Cost-Point used with Purchase | Remarks | Name | Student Number | Date Taken | Date Returned
1- WA/20MM-L | '459963'!A1 | 194710158 | WA-20mm-L | 0280N |  | JM WAHL | 25939114 | 2025-09-08 | OUTSTANDING
1-WA/50MM-L | '459964'!A1 | 195110133 | WA-50mm-L | 0280N |  | CR Sauls | 20778465 | 14/10/2021 | Returned
1-WA/50MM-L | '443611'!A1 | 173410237 | WA-50mm-L | 0284N |  | MC Nimb | 24776661 | 28/08/2025 | OUTSTANDING
1-WA/100MM-L | '459965'!A1 | 195010394 | WA-100mm-L | 0280N |  | J Martin | 23575387 | 2025-04-10 | RETURNED
1-WA/100MM-L | '443754'!A1 | 173410050 | WA-100mm-L | 0280N |  | R Aduke | Student Number | Date Taken | RETURNED
1-WA/100MM-L | '443755'!A1 | 173410051 | WA-100mm-L | 0280N |  | J Bredell | 13163094 | 2024-02-07 | RETURNED
1-WA/300MM-L | '408765'!A1 | 123410528 | WA-300mm-L | 0280N |  | J JBredell | 13163094 | 26/06/2024 | RETURNED
 | '443612'!A1 | 164910016 | WA-300mm-L | 0284N |  | C vd Westhuizen | 24194379 | 2025-04-30 | RETURNED
 | '408766'!A1 | 123210170 | WA-500mm-L | 0280N |  | Name | Student Number | Date Taken | Date Returned
TORQUE TRANSDUCERS |  |  |  |  |  | Booked Out
Type | Asset Number | Serial Number | Range | Cost-Point used with Purchase | Remarks | Name | Student Number | Date Taken | Date Returned
1-T22/20NM | '459953'!A1 | 215123578 | T22-20Nm | 0280N |  | Flood | 23589086 | 22/09/2023 | 22/09/2023
1-T22/50NM | '459954'!A1 | 115123453 | T22-50Nm | 0280N |  | HC Janse Van Vuuren | 21642478 | 17/07/2024 | RETURNED
1-T22/100NM | '459955'!A1 | 215123560 | T22-100Nm | 0280N |  | N. Ammann | 26623404 | 2025-09-11 | RETURNED
1-T5/100NM | '443756'!A1 | 163730073 | T5-100Nm | 0280N |  | Name | Student Number | Date Taken | Date Returned
CATMAN SOFTWARE |  |  |  |  |  | Booked Out
Type | Version | License Number |  | Cost-Point used with Purchase | Remarks | Name | Student Number | Date Taken | Date Returned
CATMAN AP | 3.4.2 | 0EAFU09133420002262330 |  |  |  | P Haasbroek | Student Number | 2020-11-09 | 2020-11-10
CATMAN AP | Unknown | 0EAFU09133420002300892 |  |  | CD Missing | Name | Student Number | Date Taken | Date Returned
CATMAN Easy | 5.2.2 | 0CAEZ11185220005698682 |  |  |  | Dale Corder | 22572775 |  | RETURNED
CATMAN Easy | 4.1.2 | 0CAEZ01164120005020545 |  |  |  | Name | Student Number | Date Taken | Date Returned
CATMAN Easy | 4.1.2 | 0CAEZ01164120004992237 |  |  |  | Name | Student Number | Date Taken | Date Returned
CATMAN Easy | 4.1.2 | 0CAEZ01164120004865552 |  |  |  | Name | Student Number | Date Taken | Date Returned
CATMAN AP/Easy Demo Software | 4.1 | No.1
CATMAN AP/Easy Demo Software | 4.1 | No.2
CATMAN AP/Easy Demo Software | 4.1 | No.3
CATMAN AP Demo Software | 3.4 | None
CATMAN AP Demo Software | 3.5 | None
QuantumX SOMAT XR System CD | 4.11 | None
QuantumX SOMAT XR System CD | 4.31 | No.1
QuantumX SOMAT XR System CD | 4.31 | No.2
QuantumX System CD | 2.71 | No.1
QuantumX System CD | 2.71 | No.2
DATA LOGGERS |  |  |  |  |  | Booked Out
Type | Asset Number | Serial Number |  | Cost-Point used with Purchase | Remarks | Name | Student Number | Date Taken | Date Returned
S220 - T8 | 459354 | S/N HT20102329 |  |  |  | Name | Student Number | Date Taken | Date Returned
S220 - T8 | 459355 | S/N 8Channel |  |  |  | Name | Student Number | Date Taken | Date Returned
S220 - T8 | 451253 | S/N HT20102303 |  |  |  | Name | Student Number | Date Taken | Date Returned
S220 - T8 | 459353 | S/N 8Channel |  |  |  | Name | Student Number | Date Taken | Date Returned
S220 - T8 | 459356 | S/N 8Channel |  |  |  | Name | Student Number | Date Taken | Date Returned
S220 - T8 | 451255 | S/N HT20102268 |  |  |  | Name | Student Number | Date Taken | Date Returned
S220 - T8 | 451252 | S/N 8Channel |  |  |  | J Ondiko | 25683543 | 26/08/2022 | Returned
S220 - T8 |  |  |  |  |  | Chaz Fenner | 25683543 | 26/08/2022 | Returned
NI 9219 | 450478 | S/N 19C6AB6 |  |  |  | Name | Student Number | Date Taken | Date Returned
OSCILLOSCOPES |  |  |  |  |  | Booked Out
Type | Model | Serial Number |  | Cost-Point used with Purchase | Remarks | Name | Student Number | Date Taken | Date Returned
TEKTRONIX | TDS2014 | C039333 |  |  |  | Tamara Allen | 19944306 | 25 /05/2021 | OUTSTANDING
TEKTRONIX | TDS2014C | C011326 |  |  |  | Name | Student Number | Date Taken | 2021-10-08
TEKTRONIX | 2213 | 164219 |  |  |  | M Randeree | Student Number | 21 Junie 2021 | RETURNED
Hitachi Denshi | V-209 | 5093628 |  |  |  | Name | Student Number | Date Taken | Date Returned
GW Instek | GDS-1072-U | EL-170352 |  |  |  | Name | Student Number | Date Taken | Date Returned
SIGNAL GENERATORS |  |  |  |  |  | Booked Out
Type | Model | Serial Number |  | Cost-Point used with Purchase | Remarks | Name | Student Number | Date Taken | Date Returned
Topward | 8120 | 723963 |  |  |  | L Hanstein | 25059483 | 2025-04-08 | OUTSTANDING
Topward | 8120 | 723970 |  |  |  | Name | Student Number | Date Taken | Date Returned
Tektronix | CFG250 | TW11141 |  |  |  | Name | Student Number | Date Taken | Date Returned
Wavetek | 21 | D6350139 |  |  |  | Name | Student Number | Date Taken | Date Returned
CLAMP METERS |  |  |  |  |  | Booked Out
Type | Model | Serial Number |  | Cost-Point used with Purchase | Remarks | Name | Student Number | Date Taken | Date Returned
UNI-T | UT 233 | S/N Digital Clamp Meter |  |  |  | Name | Student Number | Date Taken | Date Returned
AIRFLOW METERS |  |  |  |  |  | Booked Out
Type | Model | Serial Number |  | Cost-Point used with Purchase | Remarks | Name | Student Number | Date Taken | Date Returned
Hot Wire Anemometer | RS 327-0640 | 842567 |  |  |  | Name | Student Number | Date Taken | Date Returned
MULTIMETERS |  |  |  |  |  | Booked Out
Type | Model | Serial Number |  | Cost-Point used with Purchase | Remarks | Name | Student Number | Date Taken | Date Returned
Keysight | U3402A | MY 54330020 |  |  |  | Name | Student Number | Date Taken | Date Returned
Hewlett Packard | 3457A | 2703A10565 |  |  |  | Name | Student Number | Date Taken | Date Returned
Hewlett Packard | 3478A | 149289 |  |  |  | Name | Student Number | Date Taken | Date Returned
Topward | 1320 | 723642 |  |  |  | Name | Student Number | Date Taken | Date Returned
Topward | 1320 | 723616 |  |  |  | Name | Student Number | Date Taken | Date Returned
Topward | 1320 | 723652 |  |  |  | Name | Student Number | Date Taken | Date Returned
Topward | 1320 | 723657 |  |  |  | Name | Student Number | Date Taken | Date Returned
Hewlett Packard | 3478A | 2911A60173 |  |  |  | Name | Student Number | Date Taken | Date Returned
Metex | M-3850D | 189089 |  |  |  | Name | Student Number | Date Taken | Date Returned
Metex | M-3650 | CJ187818 |  |  |  | Name | Student Number | Date Taken | Date Returned
Fluke | 111 |  |  |  |  | Name | Student Number | Date Taken | Date Returned
GW Instek | GDM-396 | UM 180997 |  |  |  | Name | Student Number | Date Taken | Date Returned
GW Instek | GDM-396 | UM 180791 |  |  |  | Name | Student Number | Date Taken | Date Returned
UNI-T | UT61E | R150028740 |  |  |  | Name | Student Number | Date Taken | Date Returned
UNI-T | UT61E | R150028739 |  |  |  | Name | Student Number | Date Taken | Date Returned
UNI-T | UT61E | R150037479 |  |  |  | Name | Student Number | Date Taken | Date Returned
FORCE GAUGES |  |  |  |  |  | Booked Out
Type | Model | Serial Number | Range | Cost-Point used with Purchase | Remarks | Name | Student Number | Date Taken | Date Returned
Lutron | FG-6020SD | L1608047 | 20.00 kg |  |  | Name | Student Number | Date Taken | Date Returned
POWER SUPPLIES |  |  |  |  |  | Booked Out
Type | Model | Serial Number | Range | Cost-Point used with Purchase | Remarks | Name | Student Number | Date Taken | Date Returned
Manson DC power supply | HCS-3202 | S/N 6271507452 | 1-36 VDC 10A |  |  | Name | Student Number | Date Taken | Date Returned
Manson DC power supply | HCS-3202 | S/N 6271507451 | 1-36 VDC 10A |  |  | Name | Student Number | Date Taken | Date Returned
GW Instek | SPD-3606 | S/N EN850209 | 30V/6A - 60V/3A |  |  | A J.V Rensburg | 24726265 | 2025-04-09 | Date Returned
ISO-TECH | IPS-2303 | S/N 801D200G2 | 0-30V/3A |  | Faulty | Name | Student Number | Date Taken | Date Returned
Xytron DC power supply | GPC-3030E | A376659 | 5V 3A |  |  | H Janse Van Vuuren | 21642478 | 2025-03-25 | Date Returned
GW Instek | GPS-3030 | GES871338 | 0-30 VDC 3A |  |  | R Lekloloane | 21192057 | 2025-04-09 | RETURNED
GW Instek | GPS-3030 | GES871343 | 0-30 VDC 3A |  |  | Herman Roux | 22536612 | 20/09/2022 | Date Returned
GW Instek | GPS-3030 | GER863120 | 0-30 VDC 3A |  |  | T Machtelinck | 23661194 | 22/05/2025 | OUTSTANDING
GW Instek | GPS-3030 | GES871330 | 0-30 VDC 3A |  |  | S Singh | 22980644 | 20/09/2022 | Date Returned
UNI-T | UTP3305 | 486013 | 0-32V,5A |  |  | N Moyo | Student Number | 2021-10-08 | Date Returned
UNI-T | UTP3305 | 486012 | 0-32V,5A |  |  | Name | Student Number | Date Taken | Date Returned
HYGROMETERS |  |  |  |  |  | Booked Out
Type | Model | Serial Number |  | Cost-Point used with Purchase | Remarks | Name | Student Number | Date Taken | Date Returned
Lenton Thermo-hygrometer | 8711 | S/N 8804028 |  |  |  | Name | Student Number | Date Taken | Date Returned
DRUK POMP |  |  |  |  |  | Booked Out
Type | Model | Serial Number |  | Cost-Point used with Purchase | Remarks | Name | Student Number | Date Taken | Date Returned
DRUK POMP | 2000-07-13 | 302638 |  |  |  | Name | Student Number | Date Taken | Date Returned
PRESSURE METERS |  |  |  |  |  | Booked Out
Type | Model | Serial Number | Range | Cost-Point used with Purchase | Remarks | Name | Student Number | Date Taken | Date Returned
VAKUUM METER | WIKA | 302636 | -100 kPa |  |  | Name | Student Number | Date Taken | Date Returned
DRUK METER | WIKA | 302637 | 2500 kPa |  |  | A Mentz | 25848306 | 30/06/2025 | OUTSTANDING
DRUK METER | WIKA | 302635 | 1000 kPa |  |  | Name | Student Number | Date Taken | Date Returned
ANEMOMETER |  |  |  |  |  | Booked Out
Type | Model | Serial Number |  | Cost-Point used with Purchase | Remarks | Name | Student Number | Date Taken | Date Returned
Major Tech | MT948 | 08090004 |  |  |  | Name | Student Number | Date Taken | Date Returned
STROBOSCOPE |  |  |  |  |  | Booked Out
Type | Model | Serial Number |  | Cost-Point used with Purchase | Remarks | Name | Student Number | Date Taken | Date Returned
Nova-strobe | DB plus kit 230 | 378350 |  |  |  | Name | Student Number | Date Taken | Date Returned
MEASUREMENT - MICROMETER |  |  |  |  |  | Booked Out
Type | Model | Serial Number | Range | Cost-Point used with Purchase | Remarks | Name | Student Number | Date Taken | Date Returned
Blade micrometer |  |  | 0-25mm
Sheet thickness micrometer |  |  | 0-25mm
Outside micrometer |  |  | 0-25mm
Blade micrometer |  |  | 25-50mm
Outside micrometer |  |  | 25-50mm
Blade micrometer |  |  | 25-75mm
 |  |  | 50-75mm
 |  |  | 75-100mm
Outside micrometer |  |  | 150-300mm
Outside micrometer |  |  | 300-400mm
Outside micrometer |  |  | 1000mm
Inside micrometer |  |  | 40-100mm
Inside micrometer |  |  | 25-400mm
Depth micrometer |  |  | 25-60-150
Depth micrometer |  |  | 0-300mm
MEASUREMENT - VERNIER AND DIGITAL CALIPERS |  |  |  |  |  | Booked Out
Type | Model | Serial Number | Range | Cost-Point used with Purchase | Remarks | Name | Student Number | Date Taken | Date Returned
Digital vernier
Vernier |  |  | 1000mm
Vernier |  |  | 300mm
MEASUREMENT - DIAL INDICATORS |  |  |  |  |  | Booked Out
Type | Model | Serial Number | Range | Cost-Point used with Purchase | Remarks | Name | Student Number | Date Taken | Date Returned
Dial indicators
MEASUREMENT - OTHER |  |  |  |  |  | Booked Out
Type | Model | Serial Number | Range | Cost-Point used with Purchase | Remarks | Name | Student Number | Date Taken | Date Returned
Protractor | BERELL
Combination square
Edge finder
Machinist square
Laser distance meter | C3U
Digital height gauge |  |  | 300mm
Straight edge |  |  | 300mm
Straight edge |  |  | 1000mm
Straight edge |  |  | 2000mm
Equipment in Room M3001 - note that this is not actively updated so some items may not be available (Kevin Neaves, kneaves@sun.ac.za)
POWER/VOLT/CURRENT METERS |  |  |  |  |  | Booked Out
Type | Model | Serial Number |  | Cost-Point used with Purchase | Remarks | Name | Student Number | Date Taken | Date Returned
PicoTech | 4444 | FU824/0115 |  |  |  | Name | Student Number | Date Taken | Date Returned
PITE Tech Inc | PITE3561 power quality analyzer | 3561153019
MULTIFUNCTION I/O DEVICE |  |  |  |  |  | Booked Out
Type | Model | Serial Number |  | Cost-Point used with Purchase | Remarks | Name | Student Number | Date Taken | Date Returned
National Instruments | NI USB-6009 | SN: HB8462936 |  |  |  | Name | Student Number | Date Taken | Date Returned
National Instruments | NI USB-6009 | SN: PA1069944 |  |  |  | Name | Student Number | Date Taken | Date Returned
National Instruments | NI USB-6212 | SN: HC3654124 |  |  |  | Name | Student Number | Date Taken | Date Returned
DISPLACEMENT MEASUREMENT SENSORS |  |  |  |  |  | Booked Out
Type | Model | Serial Number |  | Cost-Point used with Purchase | Remarks | Name | Student Number | Date Taken | Date Returned
SICK | OD1-B035C15I25 | S/N 1313704020F |  |  |  | Name | Student Number | Date Taken | Date Returned
SICK | OD1-B035C15I25 | S/N 1313704018F |  |  |  | Name | Student Number | Date Taken | Date Returned
VOLTAGE INPUT MODULES |  |  |  |  |  | Booked Out
Type | Model | Serial Number |  | Cost-Point used with Purchase | Remarks | Name | Student Number | Date Taken | Date Returned
National Instruments | NI 9215 | SN: HC7742072 |  |  |  | Name | Student Number | Date Taken | Date Returned
USB CHASSIS |  |  |  |  |  | Booked Out
Type | Model | Serial Number |  | Cost-Point used with Purchase | Remarks | Name | Student Number | Date Taken | Date Returned
National Instruments | cDAQ-9171 | SN: HB7127916 |  |  |  | Name | Student Number | Date Taken | Date Returned
National Instruments | cDAQ-9171 | SN: HB7198628 |  |  |  | Name | Student Number | Date Taken | Date Returned
RECONFIGURABLE I/O |  |  |  |  |  | Booked Out
Type | Model | Serial Number |  | Cost-Point used with Purchase | Remarks | Name | Student Number | Date Taken | Date Returned
National Instruments | NI myRIO | 801182A-01 |  |  |  | Name | Student Number | Date Taken | Date Returned
Equipment in Room 142 (Juliun Stanfliet, jstanfliet@sun.ac.za)
POWER SUPPLIES |  |  |  |  |  | Booked Out
Type | Model | Serial Number |  | Cost-Point used with Purchase | Remarks | Name | Student Number | Date Taken | Date Returned
Topward | 6306D | 362886 |  |  |  | Name | Student Number | Date Taken | Date Returned
Topward | 6306D | 409513 |  |  |  | Name | Student Number | Date Taken | Date Returned
Topward | 6306D | 395480 |  |  |  | Name | Student Number | Date Taken | Date Returned
Topward | 6306D | 362884 |  |  |  | Name | Student Number | Date Taken | Date Returned
Topward | 6306D | 362883 |  |  |  | Name | Student Number | Date Taken | Date Returned
Topward | 6306D | 396333 |  |  |  | Name | Student Number | Date Taken | Date Returned
Topward | 6306D | 409517 |  |  |  | Name | Student Number | Date Taken | Date Returned
Topward | 6306D | MT 395480 |  |  |  | Name | Student Number | Date Taken | Date Returned
Topward | 6306D | 376791 |  |  |  | Name | Student Number | Date Taken | Date Returned
Topward | 6306D | 362882 |  |  |  | Name | Student Number | Date Taken | Date Returned
Topward | 6306D | 362885 |  |  |  | Name | Student Number | Date Taken | Date Returned
Topward | 6306D | 742531 |  |  |  | Name | Student Number | Date Taken | Date Returned
DIFFERENTIAL PRESSURE TRANSDUCER |  |  |  |  |  | Booked Out
Type | Model | F.Nr. |  | Cost-Point used with Purchase | Remarks | Name | Student Number | Date Taken | Date Returned
HBM | PD1 | 6954 |  |  |  | Name | Student Number | Date Taken | Date Returned
HBM | PD1 | 50070 |  |  |  | Name | Student Number | Date Taken | Date Returned
HBM | PD1/001 | 2931 |  |  |  | Name | Student Number | Date Taken | Date Returned
HBM | PD1 | 12056 |  |  |  | Name | Student Number | Date Taken | Date Returned
HBM | PD1 | 48840 |  |  |  | Name | Student Number | Date Taken | Date Returned
HBM | PD1 | 44609 |  |  |  | Name | Student Number | Date Taken | Date Returned
HBM | PD1 | 29444 |  |  |  | Name | Student Number | Date Taken | Date Returned
HBM | PD1 | 25022 |  |  |  | Name | Student Number | Date Taken | Date Returned
HBM | PD1 | 25023 |  |  |  | Name | Student Number | Date Taken | Date Returned
HBM | PD1 | 25021 |  |  |  | Name | Student Number | Date Taken | Date Returned
DIFFERENTIAL PRESSURE TRANSMITTER |  |  |  |  |  | Booked Out
Type | Model | S/N or Asset number | Range | Cost-Point used with Purchase | Remarks | Name | Student Number | Date Taken | Date Returned
Endress+Hauser | Deltabar S PMD75 | 435601 | 3-30 mbar |  |  | Name | Student Number | Date Taken | Date Returned
Endress+Hauser | Deltabar S PMD75 | 408472 | 0.1-10 kPa |  |  | Name | Student Number | Date Taken | Date Returned
Endress+Hauser | Deltabar S PMD75 | 408471 | 0.1-10 kPa |  |  | Name | Student Number | Date Taken | Date Returned
Endress+Hauser | Deltabar S PMD75 | 435600 |  |  |  | Name | Student Number | Date Taken | Date Returned
Endress+Hauser | Deltabar S PMD230 | 315728 | 0-2.5 kPa |  |  | Name | Student Number | Date Taken | Date Returned
Endress+Hauser | Deltabar S PMD230 | 315727 | 0-2.5 kPa |  |  | Name | Student Number | Date Taken | Date Returned
Endress+Hauser | Deltabar S PMD130 | 247294 | 0-25 mbar |  |  | Name | Student Number | Date Taken | Date Returned
Endress+Hauser | Deltabar PMD55 | KC00A321121 | 25-500 mbar |  |  | Name | Student Number | Date Taken | Date Returned
Foxboro | 823DP | 156274 |  |  |  | Name | Student Number | Date Taken | Date Returned
Endress+Hauser | Deltabar PMD55 | 457161 | 5-100 mbar |  |  | Name | Student Number | Date Taken | Date Returned
Endress+Hauser | Deltabar PMD55 | KC009F21121 | 0.15 - 3 bar |  |  | Name | Student Number | Date Taken | Date Returned
Endress+Hauser | Deltabar PMD55 | 457160 | 1.5-30 mbar |  |  | Name | Student Number | Date Taken | Date Returned
Endress+Hauser | Deltabar PMD55 | 457158 | 5-100 mbar |  |  | Name | Student Number | Date Taken | Date Returned
Endress+Hauser | Deltabar PMD55 | 457157 | 1.5 - 30 mbar |  |  | Name | Student Number | Date Taken | Date Returned
Endress+Hauser | Deltabar PMD55 | 457163 | 0.05-1 bar |  |  | Name | Student Number | Date Taken | Date Returned
Endress+Hauser | Deltabar PMD55 | KC00A221121 | 25-500 mbar |  |  | Name | Student Number | Date Taken | Date Returned
Endress+Hauser | Deltabar PMD55 | 457162 | 1.5-30 mbar |  |  | Name | Student Number | Date Taken | Date Returned
Endress+Hauser | Deltabar PMD55 | KC00A421121 | 25-500 mbar |  |  | Name | Student Number | Date Taken | Date Returned
Endress+Hauser | Deltabar S PMD130 | 216485 | 0-3 bar |  |  | Name | Student Number | Date Taken | Date Returned
Endress+Hauser | Deltabar S PMD130 | 247293 | 0-25 mbar |  |  | Name | Student Number | Date Taken | Date Returned
DATA ACQUISITION/SWITCH UNITS |  |  |  |  |  | Booked Out
Type | Model | S/N or Asset number |  | Cost-Point used with Purchase | Remarks | Name | Student Number | Date Taken | Date Returned
Agilent | 34970A | 414110 |  |  |  | Name | Student Number | Date Taken | Date Returned
Agilent | 34970A | 286392 |  |  |  | Name | Student Number | Date Taken | Date Returned
Agilent | 34970A | 410434 |  |  |  | Name | Student Number | Date Taken | Date Returned
Agilent | 34972A | 435461 |  |  |  | Name | Student Number | Date Taken | Date Returned
Agilent | 34972A | 435495 |  |  |  | Name | Student Number | Date Taken | Date Returned
HP | 34970A | 347346 |  |  | Handle broken | Name | Student Number | Date Taken | Date Returned
Agilent | 34970A | 398470 |  |  |  | Name | Student Number | Date Taken | Date Returned
Agilent | 34970A | 404058 |  |  |  | Name | Student Number | Date Taken | Date Returned
Agilent | 34970A | 380114 |  |  |  | Name | Student Number | Date Taken | Date Returned
Keysight | 34972A | MY49024748 |  |  |  | Name | Student Number | Date Taken | Date Returned
Keysight | 34972A | 459327 |  |  |  | Name | Student Number | Date Taken | Date Returned
Keysight | 34972A | 456548 |  |  |  | Name | Student Number | Date Taken | Date Returned
MULTIMETERS |  |  |  |  |  | Booked Out
Type | Model | Asset number |  | Cost-Point used with Purchase | Remarks | Name | Student Number | Date Taken | Date Returned
HP | 34401A | 247446 |  |  |  | Name | Student Number | Date Taken | Date Returned
HP | 3478A | 166045 |  |  |  | Name | Student Number | Date Taken | Date Returned
MOBILE CARRIER-FREQUENCY AMPLIFIER |  |  |  |  |  | Booked Out
Type | Model | Asset number |  | Cost-Point used with Purchase | Remarks | Name | Student Number | Date Taken | Date Returned
HBM | Scout 55 | 272977 |  |  |  | Name | Student Number | Date Taken | Date Returned
AUTORANGING MICROVOLT DMM |  |  |  |  |  | Booked Out
Type | Model | Asset number |  | Cost-Point used with Purchase | Remarks | Name | Student Number | Date Taken | Date Returned
Keithley | 197 | 189762 |  |  |  | Name | Student Number | Date Taken | Date Returned
Keithley | 197 | 189761 |  |  |  | Name | Student Number | Date Taken | Date Returned
THERMOCOUPLE THERMOMETER DATA LOGGERS |  |  |  |  |  | Booked Out
Type | Model | B/N |  | Cost-Point used with Purchase | Remarks | Name | Student Number | Date Taken | Date Returned
Huato | S220-T8 | 469453 |  |  |  | Name | Student Number | Date Taken | Date Returned
Huato | S220-T8 | 469448 |  |  |  | Name | Student Number | Date Taken | Date Returned
Huato | S220-T8 | 469446 |  |  |  | Name | Student Number | Date Taken | Date Returned
Huato | S220-T8 | 469451 |  |  |  | Name | Student Number | Date Taken | Date Returned
Huato | S220-T8 | 469449 |  |  |  | Name | Student Number | Date Taken | Date Returned
Huato | S220-T8 | 469450 |  |  |  | Name | Student Number | Date Taken | Date Returned
Equipment in Room 162
DATA ACQUISITION/SWITCH UNITS |  |  |  |  |  | Booked Out
Type | Model | Asset number |  | Cost-Point used with Purchase | Remarks | Name | Student Number | Date Taken | Date Returned
Agilent | 34972A | 435460 |  |  |  | Name | Student Number | Date Taken | Date Returned
DIFFERENTIAL PRESSURE TRANSMITTER |  |  |  |  |  | Booked Out
Type | Model | Asset number | Range | Cost-Point used with Purchase | Remarks | Name | Student Number | Date Taken | Date Returned
Endress+Hauser | Deltabar S PMD75 | 450519 | 0.25-10 mbar |  |  | Name | Student Number | Date Taken | Date Returned
Endress+Hauser | Deltabar S PMD75 | 450518 |  |  |  | Name | Student Number | Date Taken | Date Returned
Endress+Hauser | Deltabar S PMD75 | 450520 |  |  |  | Name | Student Number | Date Taken | Date Returned
Endress+Hauser | Deltabar S PMD75 | 450517 |  |  |  | Name | Student Number | Date Taken | Date Returned
Equipment in Wind tunnel lab
DIFFERENTIAL PRESSURE TRANSMITTER |  |  |  |  |  | Booked Out
Type | Model | Asset number | Range | Cost-Point used with Purchase | Remarks | Name | Student Number | Date Taken | Date Returned
Endress+Hauser | Deltabar S PMD230 | 312994 | 0-2.5 kPa |  |  | Name | Student Number | Date Taken | Date Returned
Endress+Hauser | Deltabar S PMD75 | 435606 | 5-500 mbar |  |  | Name | Student Number | Date Taken | Date Returned
Endress+Hauser | Deltabar S PMD230 | 312992 | 0-2.5 kPa |  |  | Name | Student Number | Date Taken | Date Returned
Equipment in room 185
DATA ACQUISITION/SWITCH UNITS |  |  |  |  |  | Booked Out
Type | Model | Asset number |  | Cost-Point used with Purchase | Remarks | Name | Student Number | Date Taken | Date Returned
Agilent | 34972A | 435496 |  |  |  | Name | Student Number | Date Taken | Date Returned
DIFFERENTIAL PRESSURE TRANSMITTER |  |  |  |  |  | Booked Out
Type | Model | Asset number | Range | Cost-Point used with Purchase | Remarks | Name | Student Number | Date Taken | Date Returned
Endress+Hauser | Deltabar S PMD70 | 347205 |  |  |  | Name | Student Number | Date Taken | Date Returned
Endress+Hauser | Deltabar S PMD75 | 400194 | 0.25-10 mbar |  |  | Name | Student Number | Date Taken | Date Returned
Endress+Hauser | Deltabar S PMD70 |  | 0.1-10 kPa
Endress+Hauser | Deltabar S PMD75 | 435604 | 1-100 mbar |  |  | Name | Student Number | Date Taken | Date Returned
Endress+Hauser | Deltabar S PMD75 | 435605 | 1-100 mbar |  |  | Name | Student Number | Date Taken | Date Returned
Endress+Hauser | Deltabar S PMD75 | 435602 | 0.3-30 mbar |  |  | Name | Student Number | Date Taken | Date Returned
Endress+Hauser | Deltabar S PMD75 | 435608 | 0.03-3 bar |  |  | Name | Student Number | Date Taken | Date Returned
Equipment in Room M3014 - note that this is not actively updated so some items may not be available (Kevin Neaves, kneaves@sun.ac.za)
DC POWER SUPPLIES
Type | Model | Asset number | Output | Cost-Point used with Purchase | Remarks
Mean Well | S-150-24 |  | 24 V 6.25 A
Mean Well | S-240-12 |  | 12 V 20 A
MOTORS
Type | Model |  | Quantity | Cost-Point used with Purchase | Remarks
Wantai | 42BYGHM809 |  | 3
Wantai | 42BYGHW609 |  | 1
Wantai | 57BYGH420 |  | 2
MAE | HY 200-2220-210 A 8 |  | 3
Sigma Instruments | 20-2215D-28134 |  | 1
OMC Stepperonline | 17HS15-1504S-X1 |  | 2
Wantai | 35BYG312P1 |  | 1
OMC Stepperonline | 17HS19-1684S1 |  | 2
Epson | SM-E040 |  | 6
RS Pro | 5350524 |  | 2
Micro Robotics Motor | 35BYG312P1 |  | 1
Servo RH7-1048 | KP56QM2-001 |  | 2
Mitsumi | M42SP-6TE |  | 1
Mercury motor | ST-PM35 |  | 1
NMB | PM55L-048-XRD4 |  | 2
Robot-Electronics | EMG49 - Gear motor with encoder |  | 2
Faulhaber | 2342S012CR DC-Micromotor with IE2-512 encoder |  | 5
Faulhaber | 2342S006CR DC-Micromotor with IE2-512 encoder |  | 3
Faulhaber | 1724T012SR Coreless DC motor |  | 3
Faulhaber | 3257G012CR DC-Minimotor with IE2-16 encoder |  | 53
Other |  |  | 4
CIRCUIT BOARDS
Manufacturer | Type |  | Quantity | Cost-Point used with Purchase | Remarks
Sparkfun | MAX31855K |  | 2
DFROBOT | DRFduino UNO |  | 1
Protoneer | Arduino CNC Shield |  | 1
RobotDyn | Ramps 1.4 |  | 1
Raspberry Pi | B |  | 1
MKS Sbase | V1.2 Mother Controller Board |  | 1
Raspberry Pi | 3 model B |  | 2
Maxim Integrated | MAX6675 |  | 1
SMAKN | 4-Channel 5v Solid State Relay Module Board |  | 1
Cylewet | CJMCU-711 |  | 1
 | Arduino Nano Board |  | 2
Digilent | MAX31855 |  | 1
 | RAMPS 1.4 Control Panel 3D Printer Control Board
SENSORS
Manufacturer | Type |  | Quantity | Cost-Point used with Purchase | Remarks
Adafruit Industries | HC-SR04 Ultrasonic Sonar Distance Sensors |  | 3
73JohnPol | MAX6675 K-type Thermocouple Temperature Sensor
MODULES
Manufacturer | Type |  | Quantity | Cost-Point used with Purchase | Remarks
 | HC-05 (ZS-040) Bluetooth Module |  | 1
DFRobot | MicroSD Module V1.0 |  | 1
NXP | RC522 RFID Module |  | 1
Keyes | Hall/Holzer Effect Sensor Module |  | 2
 | ISD1820 Voice record module |  | 1
CAMERA
Manufacturer | Type |  | Quantity | Cost-Point used with Purchase | Remarks
Raspberry Pi | V2.1
USB TOUCH SCREEN
Manufacturer | Type |  | Quantity | Cost-Point used with Purchase | Remarks
Waveshare | 5 Inch Touch LCD with HDMI interface
PINHEADERS
Manufacturer | Type |  | Quantity | Cost-Point used with Purchase | Remarks
Micro Robotics | Female 20 pin headers |  | 1
Micro Robotics | Female 18 double row pin headers |  | 1
Micro Robotics | Female 10 pin headers |  | 1
Micro Robotics | Female 8 pin headers |  | 5
Micro Robotics | Female 9 pin headers |  | 1
MOTOR DRIVERS
Manufacturer | Type |  | Quantity | Cost-Point used with Purchase | Remarks
 | A4988 Stepper Motor Driver |  | 1
Pololu | DRV8825 Stepper Motor Driver |  | 1
MKS | TB6600 Stepper Driver |  | 1
Robot-Electronics | MD49 - 24V 5A dual H-bridge motor driver |  | 1
GEARBOX
Manufacturer | Type |  | Quantity | Cost-Point used with Purchase | Remarks
Maxon | 84:1 Planetary Gearbox |  | 1

Sheet: 437406
Type | Model | Asset number | Booked Out
MX840B | 437406'!A1 | 437406 | Name | Student Number | Date Taken | Date Returned
 |  |  | Llewellyn | 22793429 | 2025-03-28 | Back
 |  |  | Mr. J Bredell |  | 2025-08-05 | RETURNED
 | Click to return to HOME

Sheet: 536093
Type | Model | Asset number | Booked Out
MX460B | 536093'!A1 | 536093 | Name | Student Number | Date Taken | Date Returned
 |  |  | Llewellyn | 22793429 | 2025-03-28 | Back
 | Click to return to HOME

Sheet: 435608
Type | Model | Asset number | Booked Out
Endress+Hauser | Deltabar S PMD75 | 435608 | Name | Student Number | Date Taken | Date Returned
 | Click to return to HOME

Sheet: 435602
Type | Model | Asset number | Booked Out
Endress+Hauser | Deltabar S PMD75 | 435602 | Name | Student Number | Date Taken | Date Returned
 | Click to return to HOME

Sheet: 435605
Type | Model | Asset number | Booked Out
Endress+Hauser | Deltabar S PMD75 | 435605 | Name | Student Number | Date Taken | Date Returned
 | Click to return to HOME

Sheet: 435604
Type | Model | Asset number | Booked Out
Endress+Hauser | Deltabar S PMD75 | 435604 | Name | Student Number | Date Taken | Date Returned
 | Click to return to HOME

Sheet: 400194
Type | Model | Asset number | Booked Out
Endress+Hauser | Deltabar S PMD70 | 347205 | Name | Student Number | Date Taken | Date Returned
 | Click to return to HOME

Sheet: 347205
Type | Model | Asset number | Booked Out
Endress+Hauser | Deltabar S PMD70 | 347205 | Name | Student Number | Date Taken | Date Returned
 | Click to return to HOME

Sheet: 435496
Type | Model | Asset number | Booked Out
Agilent | 34972A | 435496 | Name | Student Number | Date Taken | Date Returned
 | Click to return to HOME

Sheet: 312992
Type | Model | Asset number | Booked Out
Endress+Hauser | Deltabar S PMD230 | 312992 | Name | Student Number | Date Taken | Date Returned
 | Click to return to HOME

Sheet: 435606
Type | Model | Asset number | Booked Out
Endress+Hauser | Deltabar S PMD75 | 435606 | Name | Student Number | Date Taken | Date Returned
 | Click to return to HOME

Sheet: 312994
Type | Model | Asset number | Booked Out
Endress+Hauser | Deltabar S PMD230 | 312994 | Name | Student Number | Date Taken | Date Returned
 | Click to return to HOME

Sheet: 450517
Type | Model | Asset number | Booked Out
Endress+Hauser | Deltabar S PMD75 | 450517 | Name | Student Number | Date Taken | Date Returned
 | Click to return to HOME

Sheet: 450520
Type | Model | Asset number | Booked Out
Endress+Hauser | Deltabar S PMD75 | 450520 | Name | Student Number | Date Taken | Date Returned
 | Click to return to HOME

Sheet: 450518
Type | Model | Asset number | Booked Out
Endress+Hauser | Deltabar S PMD75 | 450518 | Name | Student Number | Date Taken | Date Returned
 | Click to return to HOME

Sheet: 450519
Type | Model | Asset number | Booked Out
Endress+Hauser | Deltabar S PMD75 | 450519 | Name | Student Number | Date Taken | Date Returned
 | Click to return to HOME

Sheet: 435460
Type | Model | Asset number | Booked Out
Agilent | 34972A | 435460 | Name | Student Number | Date Taken | Date Returned
 | Click to return to HOME

Sheet: 469450
Type | Model | B/N | Booked Out
Huato | S220-T8 | 469450 | Name | Student Number | Date Taken | Date Returned
 | Click to return to HOME

Sheet: 469449
Type | Model | B/N | Booked Out
Huato | S220-T8 | 469449 | Name | Student Number | Date Taken | Date Returned
 | Click to return to HOME

Sheet: 469451
Type | Model | B/N | Booked Out
Huato | S220-T8 | 469451 | Name | Student Number | Date Taken | Date Returned
 | Click to return to HOME

Sheet: 469446
Type | Model | B/N | Booked Out
Huato | S220-T8 | 469446 | Name | Student Number | Date Taken | Date Returned
 | Click to return to HOME

Sheet: 469448
Type | Model | B/N | Booked Out
Huato | S220-T8 | 469448 | Name | Student Number | Date Taken | Date Returned
 | Click to return to HOME

Sheet: 469453
Type | Model | B/N | Booked Out
Huato | S220-T8 | 469453 | Name | Student Number | Date Taken | Date Returned
 | Click to return to HOME
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
