LenaMatota/MechatronicsProject478/Skripsie resources/List of material in store-2026.xlsx

20680058
 | All Prices Excluding vat
 | Aluminium Angle Iron | Price Per Metre | Combined lengths availbale | LENGTHS AND PIECES AVAILABLE IN STORE
 | 25 x 25 x 1.6 | R23.00 | 59.965 | 6 | 6 | 6 | 6 | 6 | 6 | 6 | 6 | 6 | 5.965
 | 25 x 25 x 3 | R126.00 | 24 | 6 | 6 | 6 | 6
 | 32 x 32 x 3 | R68.80 | 10.878 | 6 | 4.878
 | 38 x 38 x 2 |  | 15.759 | 6.01 | 5.805 | 3.944
 | 38 x 38 x 3 | R56.00 | 6.59 | 5.2 | 1.39
 | 38 x 38 x 6 | R105.00 | 6 | 6
 | 50 x 50 x 2 | R48.00 | 14.377 | 6 | 6 | 1.05 | 0.915 | 0.412
 | 50 x 50 x 3 | R75.00 | 8.707 | 6 | 2.707
 | 76 x 76 x 6 |  | 3.034 | 3.034
 | Aluminium Flatbar
 | 20 x 3 | R11.16 | 14.92 | 6 | 6 | 2.92
 | 25 x 2 | R25.00 | 5.968 | 5.968
 | 25 x 3 |  | 6 | 6
 | 25 x 5 | R35.00 | 19.765 | 6 | 6 | 3.42 | 4.345
 | 32 X 3 |  | 6 | 6
 | 38 x 3 | R 44.17 | 10.398 | 6 | 4.398
 | 38 x 6 | R79.33 | 8.16 | 6 | 2.16
 | 50 X 3 | R21.00 | 8.563 | 6 | 1.87 | 0.693
 | 50 x 5 |  | 17.398 | 6 | 6 | 5.398
 | 50 x 6 | R58.96 | 14.397 | 6 | 6 | 2.397
 | Aluminium Square Tubing
 | 12 x 12 x 1 | R7.87 | 4.133 | 4.133
 | 19 x 19 x 1.6 | R 30.83 | 18 | 6 | 6 | 6
 | 25 x 25 x 2 | R 64.17 | 0
 | 25 x 25 x 3 | R68.16 | 16.534 | 6 | 6 | 4.534
 | 32 x 32 x 2 |  | 2.767 | 2 | 0.767
 | 32 x 32 x 3 |  | 24 | 6 | 6 | 6 | 6
 | 38 x 38 x 2 | R88.66 | 13.155 | 6 | 6 | 1.155
 | 38 x 38 x 3 | R124.66 | 10.808 | 6 | 4.808
 | 50 x 50 x 2 | R115.50 | 8.676 | 4.995 | 2.266 | 1.415
 | 50 x 50 x 3 | R163.00 | 15.235 | 6 | 6 | 2.778 | 0.457
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
 | 35mm | R 1790.70 | 1.6 | 1 | 0.6
 | 40mm | R 2345.42 | 1.763 | 1 | 0.763
 | 50mm | R 3779.76 | 1.125 | 1 | 0.125
 | 90mm |  | 0
 |  |  | 0
 |  |  | 0
 | Silver Steel |  | 0
 | 8mm |  | 2.015 | 2.015
 | 10mm |  | 1.97 | 1.555 | 0.415
 | 8mm |  | 2.015 | 2.015
 | 10mm |  | 1.97 | 1.555 | 0.415
