LenaMatota/MechatronicsProject478/Datasheets for components/Spice component models/Electromagnetic Inductance.jpg

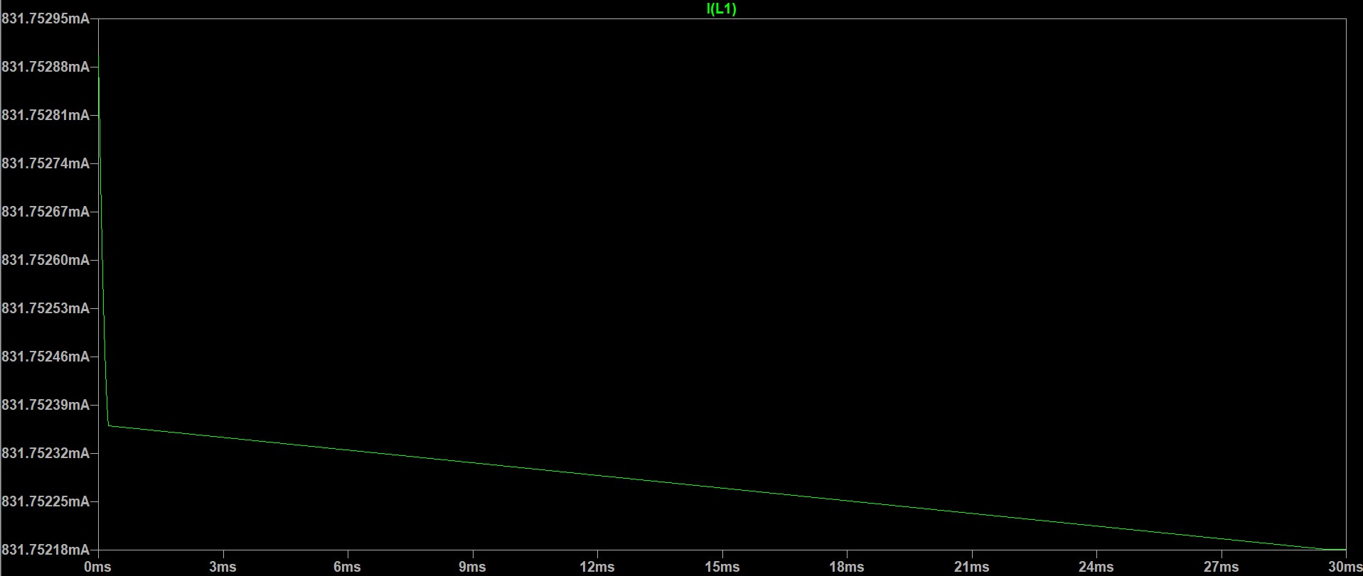
Datasheets for components/Spice component models/Electromagnetic Inductance.jpg
