LenaMatota/MechatronicsProject478/Datasheets for components/Spice component models/Power dissipation in TIP41C.jpg

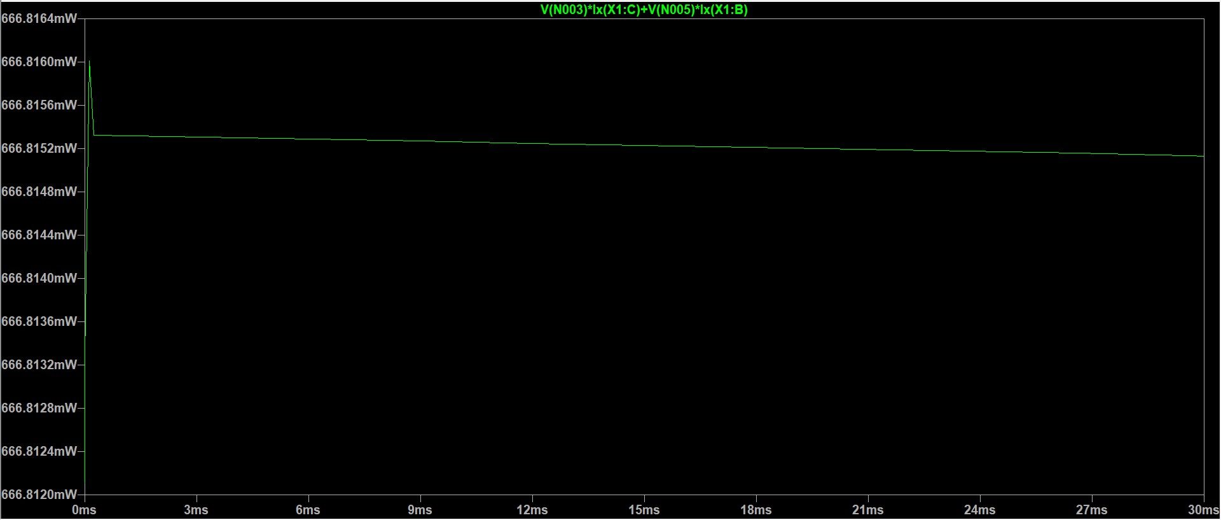
Datasheets for components/Spice component models/Power dissipation in TIP41C.jpg
