LenaMatota/MechatronicsProject478/Datasheets for components/Spice component models/Signal amplification from input to electromagnet.jpg

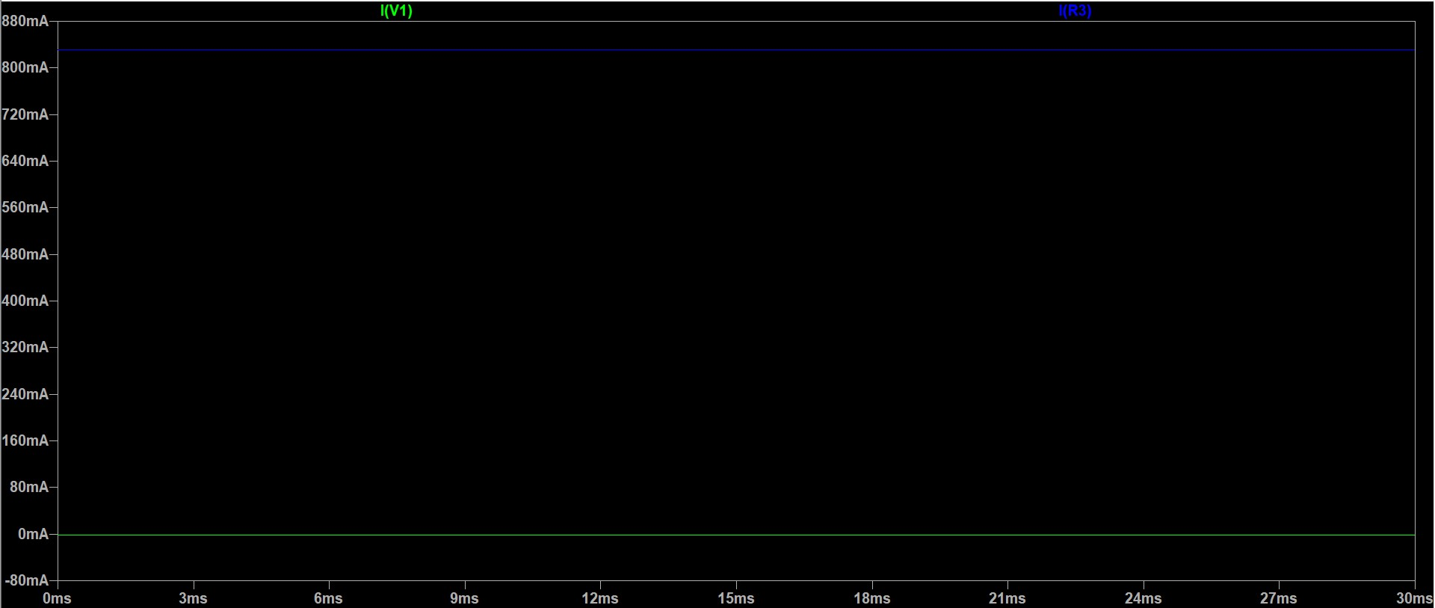
Datasheets for components/Spice component models/Signal amplification from input to electromagnet.jpg
