LenaMatota/MechatronicsProject478/Datasheets for components/Spice component models/Vce across TIP41C transistor and IC from electromagnet.png

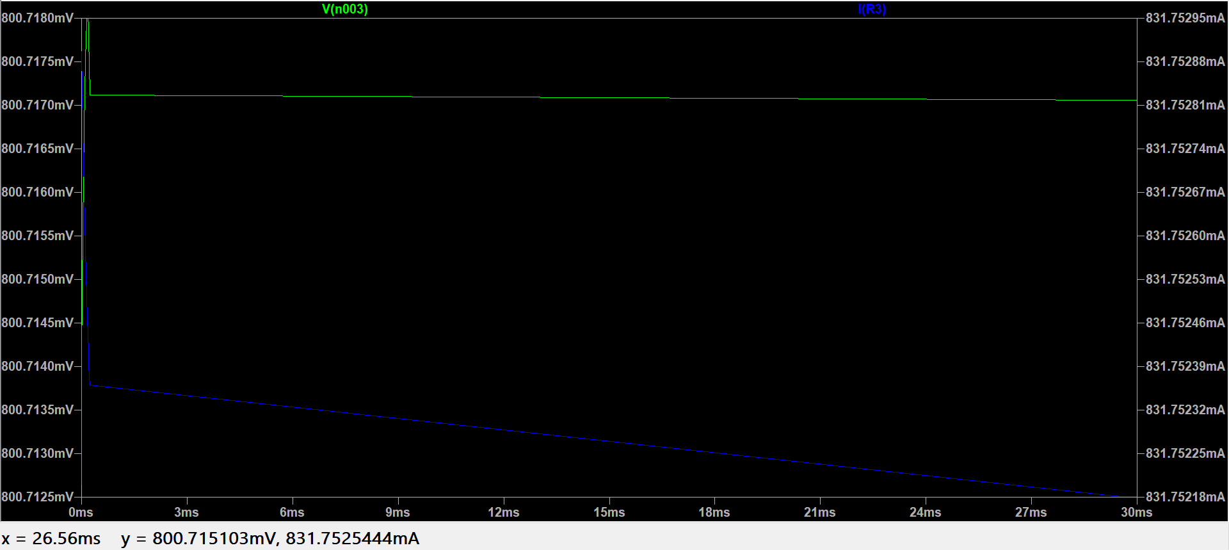
Datasheets for components/Spice component models/Vce across TIP41C transistor and IC from electromagnet.png
