LenaMatota/MechatronicsProject478/Building the joint/Joint Assembly/Drawings/Laser cut drawings/24989142-01-03-00-00 Friction Plate.dxf

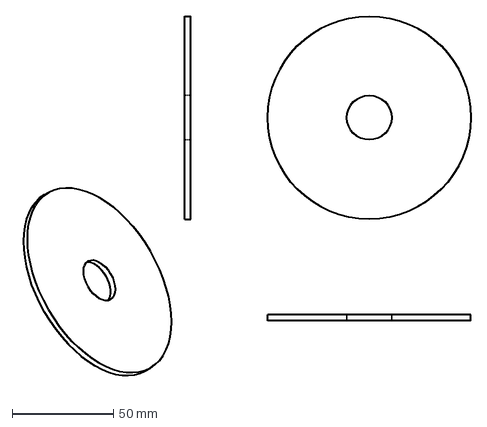
[picture p70: CAD file, 2026-09-08]
Building the joint/Joint Assembly/Drawings/Laser cut drawings/24989142-01-03-00-00 Friction Plate.dxf
223.9 x 182.6 mm
