LenaMatota/MechatronicsProject478/Building the joint/Joint Assembly/Drawings/Laser cut drawings/24989142-01-02-00-00 Pressure platform.dxf

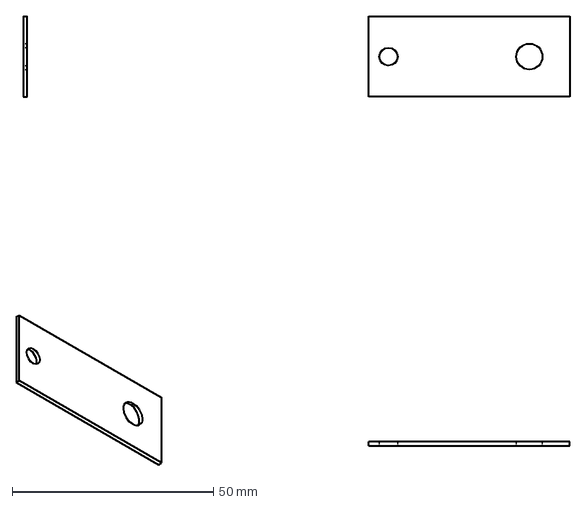
[picture p71: CAD file, 2026-09-08]
Building the joint/Joint Assembly/Drawings/Laser cut drawings/24989142-01-02-00-00 Pressure platform.dxf
137.6 x 111.5 mm
