LenaMatota/MechatronicsProject478/Building the joint/Joint Assembly/Drawings/Laser cut drawings/24989142-01-01-01-02 Electromagnetic cover bottom.dxf

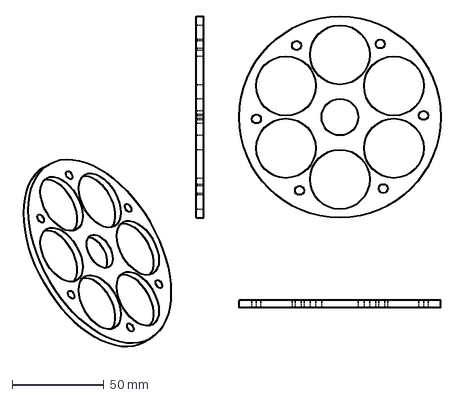
[picture p72: CAD file, 2026-09-08]
Building the joint/Joint Assembly/Drawings/Laser cut drawings/24989142-01-01-01-02 Electromagnetic cover bottom.dxf
231.6 x 186.3 mm
