LenaMatota/MechatronicsProject478/Building the joint/Joint Assembly/Drawings/Laser cut drawings/OldVersions/Pressure platform.xxxx.dxf

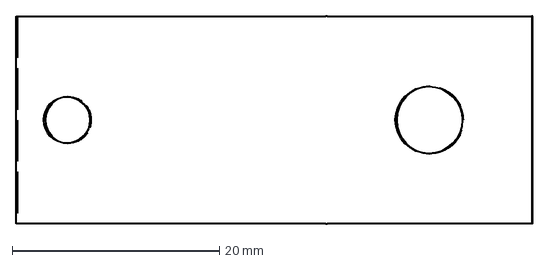
[picture p73: CAD file, 2026-09-08, an earlier design]
Building the joint/Joint Assembly/Drawings/Laser cut drawings/OldVersions/Pressure platform.xxxx.dxf
49.9 x 20.0 mm
