LenaMatota/MechatronicsProject478/(list of files, cad)

Other CAD files:
Building the joint/Joint Assembly/2058786.iam
Building the joint/Joint Assembly/2058786_01.ipt
Building the joint/Joint Assembly/2058786_02.ipt
Building the joint/Joint Assembly/2058786_03.ipt
Building the joint/Joint Assembly/2058786_04.ipt
Building the joint/Joint Assembly/2058786_05.ipt
Building the joint/Joint Assembly/2058786_06.ipt
Building the joint/Joint Assembly/8236967.ipt
Building the joint/Joint Assembly/Base link.iam
Building the joint/Joint Assembly/Bearing housing bottom.ipt
Building the joint/Joint Assembly/Bearing housing top.ipt
Building the joint/Joint Assembly/Bottom joint housing 2R.ipt
Building the joint/Joint Assembly/Bottom joint housing R.ipt
Building the joint/Joint Assembly/Bottom joint housing cover top back_ final.ipt
Building the joint/Joint Assembly/Bottom joint housing cover_ final.ipt
Building the joint/Joint Assembly/Bottom link body.ipt
Building the joint/Joint Assembly/Bottom link plate.ipt
Building the joint/Joint Assembly/Brake disc.ipt
Building the joint/Joint Assembly/Complete back top housing.iam
Building the joint/Joint Assembly/Complete front top housing.iam
Building the joint/Joint Assembly/Drawings/24989142-01-00-00-00 joint shaft.idw
Building the joint/Joint Assembly/Drawings/24989142-02-00-00-00 bearing housing top.idw
Building the joint/Joint Assembly/Drawings/24989142-03-00-00-00 bearing housing bottom.idw
Building the joint/Joint Assembly/Drawings/24989142-04-00-00-00 joint housing bottom.idw
Building the joint/Joint Assembly/Drawings/24989142-04-01-00-00 joint housing bottom left.idw
Building the joint/Joint Assembly/Drawings/24989142-04-02-00-00 joint housing bottom back.idw
Building the joint/Joint Assembly/Drawings/24989142-04-03-00-00 joint housing bottom right.idw
Building the joint/Joint Assembly/Drawings/24989142-05-00-00-00 joint housing top front.idw
Building the joint/Joint Assembly/Drawings/24989142-05-01-00-00 joint housing top front half.idw
Building the joint/Joint Assembly/Drawings/24989142-06-00-00-00 joint housing top back.idw
Building the joint/Joint Assembly/Drawings/24989142-07-00-00-00 base link.idw
Building the joint/Joint Assembly/Drawings/24989142-07-01-00-00 base link plate.idw
Building the joint/Joint Assembly/Drawings/24989142-07-02-00-00 base link pipe.idw
Building the joint/Joint Assembly/Drawings/24989142-08-00-00-00 articuating link.idw
Building the joint/Joint Assembly/Drawings/24989142-08-01-00-00 articuating link pipe.idw
Building the joint/Joint Assembly/Drawings/24989142-08-02-00-00 articuating link probe hub.idw
Building the joint/Joint Assembly/Drawings/24989142-08-03-00-00 articuating link probe.idw
Building the joint/Joint Assembly/Drawings/24989142-09-00-00-00 brake disc key.idw
Building the joint/Joint Assembly/Drawings/24989142-10-00-00-00 electromagnet.idw
Building the joint/Joint Assembly/Drawings/24989142-10-01-00-00 solenoid yoke.idw
Building the joint/Joint Assembly/Drawings/24989142-10-02-00-00 solenoid core.idw
Building the joint/Joint Assembly/Drawings/24989142-10-03-00-00 pressure tab platform.idw
Building the joint/Joint Assembly/Drawings/24989142-10-04-00-00 electromagnet cover.idw
Building the joint/Joint Assembly/Drawings/24989142-10-04-01-00 electromagnet cover body.idw
Building the joint/Joint Assembly/Drawings/24989142-10-04-02-00 electromagnet cover bottom.idw
Building the joint/Joint Assembly/Drawings/24989142-11-00-00-00 pressure tab.idw
Building the joint/Joint Assembly/Drawings/24989142-12-00-00-00 brake disc.idw
Building the joint/Joint Assembly/Drawings/Electromagnet.ipn
Building the joint/Joint Assembly/Drawings/Joint Assembly.idw
Building the joint/Joint Assembly/Drawings/Joint Assembly.ipn
Building the joint/Joint Assembly/Drawings/OldVersions/24989142-01-00-00-00 joint shaft.0002.idw
Building the joint/Joint Assembly/Drawings/OldVersions/24989142-02-00-00-00 bearing housing top.0003.idw
Building the joint/Joint Assembly/Drawings/OldVersions/24989142-03-00-00-00 bearing housing bottom.0002.idw
Building the joint/Joint Assembly/Drawings/OldVersions/24989142-04-00-00-00 joint housing bottom.0003.idw
Building the joint/Joint Assembly/Drawings/OldVersions/24989142-04-01-00-00 joint housing bottom left.0003.idw
Building the joint/Joint Assembly/Drawings/OldVersions/24989142-04-02-00-00 joint housing bottom back.0001.idw
Building the joint/Joint Assembly/Drawings/OldVersions/24989142-04-03-00-00 joint housing bottom right.0001.idw
Building the joint/Joint Assembly/Drawings/OldVersions/24989142-05-00-00-00 joint housing top front.0002.idw
Building the joint/Joint Assembly/Drawings/OldVersions/24989142-05-01-00-00 joint housing top front half.0002.idw
Building the joint/Joint Assembly/Drawings/OldVersions/24989142-06-00-00-00 joint housing top back.0002.idw
Building the joint/Joint Assembly/Drawings/OldVersions/24989142-07-00-00-00 base link.0001.idw
Building the joint/Joint Assembly/Drawings/OldVersions/24989142-07-01-00-00 base link plate.0001.idw
Building the joint/Joint Assembly/Drawings/OldVersions/24989142-07-02-00-00 base link pipe.0002.idw
Building the joint/Joint Assembly/Drawings/OldVersions/24989142-08-00-00-00 articuating link.0002.idw
Building the joint/Joint Assembly/Drawings/OldVersions/24989142-08-01-00-00 articuating link pipe.0001.idw
Building the joint/Joint Assembly/Drawings/OldVersions/24989142-08-02-00-00 articuating link probe hub.0001.idw
Building the joint/Joint Assembly/Drawings/OldVersions/24989142-08-03-00-00 articuating link probe.0001.idw
Building the joint/Joint Assembly/Drawings/OldVersions/24989142-09-00-00-00 brake disc key.0001.idw
Building the joint/Joint Assembly/Drawings/OldVersions/24989142-10-00-00-00 electromagnet.0004.idw
Building the joint/Joint Assembly/Drawings/OldVersions/24989142-10-00-00-00 electromagnet.0005.idw
Building the joint/Joint Assembly/Drawings/OldVersions/24989142-10-00-00-00 electromagnet.0006.idw
Building the joint/Joint Assembly/Drawings/OldVersions/24989142-10-01-00-00 solenoid yoke.0002.idw
Building the joint/Joint Assembly/Drawings/OldVersions/24989142-10-02-00-00 solenoid core.0001.idw
Building the joint/Joint Assembly/Drawings/OldVersions/24989142-12-00-00-00 brake disc.0001.idw
Building the joint/Joint Assembly/Drawings/OldVersions/Brake disc-1.0003.idw
Building the joint/Joint Assembly/Drawings/OldVersions/Electromagnet cover_po.0007.idw
Building the joint/Joint Assembly/Drawings/OldVersions/Electromagnet final_key.0002.idw
Building the joint/Joint Assembly/Drawings/OldVersions/Electromagnet final_key.0009.idw
Building the joint/Joint Assembly/Drawings/OldVersions/Electromagnet.0002.ipn
Building the joint/Joint Assembly/Drawings/OldVersions/Electromagnetic cover body.0004.idw
Building the joint/Joint Assembly/Drawings/OldVersions/Electromagnetic cover bottom.0004.idw
Building the joint/Joint Assembly/Drawings/OldVersions/Electromanetic brake.0002.iam
Building the joint/Joint Assembly/Drawings/OldVersions/Electromanetic brake.0007.idw
Building the joint/Joint Assembly/Drawings/OldVersions/Final joint shaft.0002.idw
Building the joint/Joint Assembly/Drawings/OldVersions/Friction Plate.0002.idw
Building the joint/Joint Assembly/Drawings/OldVersions/Joint Assembly.0004.ipn
Building the joint/Joint Assembly/Drawings/OldVersions/Joint Assembly.0010.idw
Building the joint/Joint Assembly/Drawings/OldVersions/Joint Assembly.0012.idw
Building the joint/Joint Assembly/Drawings/OldVersions/Joint Assembly.0014.idw
Building the joint/Joint Assembly/Drawings/OldVersions/Key.0002.idw
Building the joint/Joint Assembly/Drawings/OldVersions/Pressure plate tab_L.0002.idw
Building the joint/Joint Assembly/Drawings/OldVersions/Pressure platform.0005.idw
Building the joint/Joint Assembly/Drawings/OldVersions/Solenoid Yoke.0006.idw
Building the joint/Joint Assembly/Drawings/OldVersions/Solenoid core.0006.idw
Building the joint/Joint Assembly/E60063.ipt
Building the joint/Joint Assembly/Electromagnet cover.iam
Building the joint/Joint Assembly/Electromagnet cover.ipt
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
