LenaMatota/MechatronicsProject478/Building the joint/Joint Assembly/Drawings/DRAWING PACK.docx

# Drawing Pack – LN Matota – 24989142

24989142-01-00-00 ELECTROMAGNETIC BRAKE | 24989142-01-00-00 JOINT SHAFT
| 24989142-02-00-00 BEARING HOUSING TOP
| 24989142-03-00-00 BEARING HOUSE BOTTOM
| 24989142-04-00-00 JOINT HOUSING BOTTOM | 24989142-04-01-00 JOINT HOUSING BOTTOM LEFT
| | 24989142-04-02-00 JOINT HOUSING BOTTOM BACK
| | 24989142-04-03-00 JOINT HOUSING BOTTOM RIGHT
| 24989142-05-00-00 JOINT HOUSING TOP-FRONT | 24989142-05-01-00 JOINT HOUSING TOP BACK
| 24989142-06-00-00 JOINT HOUSING TOP-BACK
| 24989142-07-00-00 BASE LINK | 24989142-07-01-00 BASE LINK PLATE
| | 24989142-07-02-00 BASE LINK PIPE
| 24989142-08-00-00 ARTICULATING LINK | 24989142-08-01-00 ARTICULATING LINK PIPE
| | 24989142-08-02-00
| | ARTICULATING LINK PROBE HUB
| | 24989142-08-03-00 ARTICULATING LINK PROBE
| 24989142-09-00-00 BRAKE DISC KEY
| 24989142-10-00-00 ELECTROMAGNET | 24989142-10-01-00 SOLENOID YOKE
| | 24989142-10-02-00 SOLENOID CORE
| | 24989142-10-03-00 PRESSURE TAB PLATFORM
| | 24989142-10-04-00 ELECTROMAGNET COVER | 24989142-10-04-01 ELECTROMAGNET COVER BODY
| | | 24989142-10-04-02 ELECTROMAGNET COVER BOTTOM
| 24989142-11-00-00 PRESSURE TAB
| 24989142-12-00-00 BRAKE DISC

Student contact number: +27 71 569 2349

Student email: 24989142@sun.ac.za

Supervisor: K. Schreve
