LenaMatota/MechatronicsProject478/Building the joint/1-s2.0-S1567173919302536-main.pdf

Contents lists available at ScienceDirect (http://www.sciencedirect.com/science/journal/15671739)

# Current Applied Physics

journal homepage: www.elsevier.com/locate/cap

# Improvement of saturation magnetic flux density in Fe–Si–B–Nb–Cu nanocomposite alloys by magnetic field annealing

## Seoyeon Kwon, Sumin Kim, Haein Yim∗

Department of Physics, Sookmyung Women's University, Seoul, 04310, Republic of Korea

ARTICLE INFO

Keywords:
Annealing
Amorphous
Soft magnetic
Ferromagnetic

ABSTRACT

In the present study, we investigated the effect of heat treatment on the magnetic properties of the Fe87-xSixB9Nb3Cu1 (x = 1, 3, 5, 7, 9, and 13.5) alloy system. Ribbon samples with the width of 2 mm and thickness of 20–30 μm were synthesized by melt spinning. Among the samples, only amorphous samples were nanocrystallized by annealing between 360 and 600 °C. The annealed alloys tended to have improved soft magnetic characteristics, including higher saturation magnetic flux density (Bs), while maintaining high relative permeability (μ )r , and low core loss (Pcv). A high saturation magnetic flux density of 1.51 T was obtained for the Fe78Si9B9Nb3Cu1 core sample after longitudinal magnetic field annealing at 520 °C. The sample had excellent soft magnetic properties as compared to the conventional value of FINEMET core (Bs = 1.23 T), which is a significant improvement as compared to the as-spun ribbons (Bs = 1.10-1.26 T).

1. Introduction

Over the past several decades, nanocrystalline materials have attracted a considerable scientific and technological attention due to remarkable soft magnetic properties of these materials. These materials are widely used in electric power applications, such as transformer cores and other inductive devices. In recent years, an important concern has been energy saving. Electrical power supplies require a low iron loss and a high saturation magnetic flux density (Bs) in soft magnetic materials. From this viewpoint, the Fe–Cu–Nb–Si–B nanocrystalline alloy ribbons with a low coercivity (Hc) and core loss (Pcv) have been developed as novel soft magnetic materials, which are neither Si steels nor Fe-based amorphous alloys.
From then on, three typical nanocrystalline alloy systems have been developed under the trade name of FINEMET (Hitachi Matels Ltd., Japan) (Yoshizawa et al., 1988), Nanoperm (MH&W International Corp., USA) (Suzuki et al., 1991a, 1991b) and Hitperm (Carnegie Mellon University, USA) (Willard et al., 1998). Among these alloys, Nanoperm exhibits high Bs of 1.5–1.7 T but contains expensive and easily oxidized elements (e.g. Zr of Hf). Hitperm possesses high Curie temperature but the Hc is up to 200 A/m and the large amount of additive element Co increases material cost [1]. Compared to the above alloys, FINEMET exhibits excellent soft magnetic properties, as well as convenient production process with economical cost. The nanocrystalline FINEMET™ alloy was first produced by Yoshizawa in 1988 [2–4].

This alloy has a particular microstructure characterized by randomly oriented, ultrafine α-FeSi grains with a bcc structure [5]. These characteristics constitute the basis for the outstanding soft magnetic properties of the alloy, with a high level of initial permeability (~10⁵
) and a
low saturation magnetostriction (~2 X 10⁻⁶
) with a relatively good Bs, of about 1.23 T [6]. The premier soft magnetic characteristics are based on the two-phase microstructure consisting of nanocrystalline ferromagnetic grains surrounded by a ferromagnetic amorphous matrix. In order to obtain optimal microstructure and properties, amorphous ribbon precursors produced by melt spinning are generally annealed at a certain temperature above the primary crystallization temperature (Tx). On the other hand, the relative permeability (μ )r as well as Pcv and Bs depends on the presence of magnetic field in annealing. In particular, the annealing under longitudinal magnetic field results in squared hysteresis loops characterized by a significant reduction of Hc [7]. In actual applications such as saturable reactors or choke coils, the soft magnetic materials which show high remanence or flat B–H curves are preferably used. Therefore, the magnetic field annealing could be a useful method for improving the magnetic properties of amorphous alloys [8].
Therefore, in the present study, we successfully developed new Fe–Si–B–Nb–Cu nanocrystalline soft magnetic alloys by magnetic field annealing. In the present study, we obtained nanocomposite soft magnetic alloys with a high Bs, while maintaining their good magnetic properties with the replacement of Si by Fe.

https://doi.org/10.1016/j.cap.2019.10.003
Received 14 August 2019; Received in revised form 2 October 2019; Accepted 4 October 2019

∗ Corresponding author.
E-mail addresses: haein@sookmyung.ac.kr, haein@sm.ac.kr (H. Yim).

# Current Applied Physics 20 (2020) 37–42 (https://doi.org/10.1016/j.cap.2019.10.003)

# Available online 07 October 2019

1567-1739/ © 2019 Korean Physical Society. Published by Elsevier B.V. All rights reserved.

# T (http://crossmark.crossref.org/dialog/?doi=10.1016/j.cap.2019.10.003&domain=pdf)

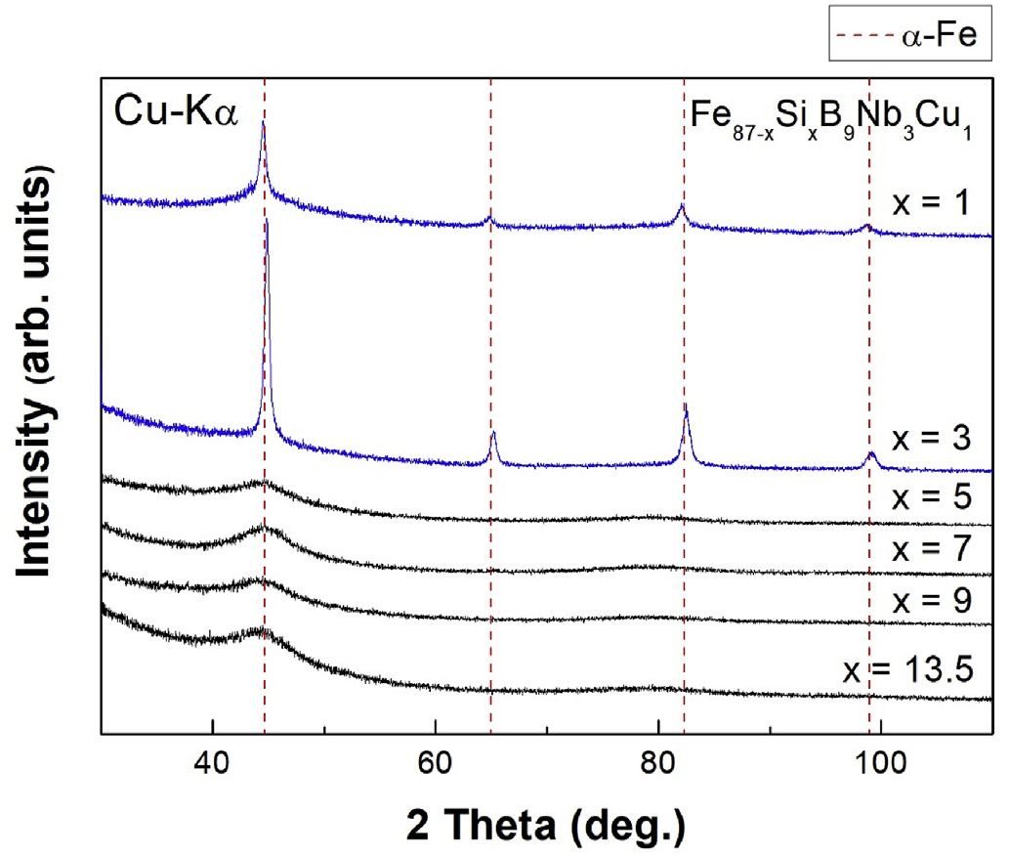
[picture p85: figure]
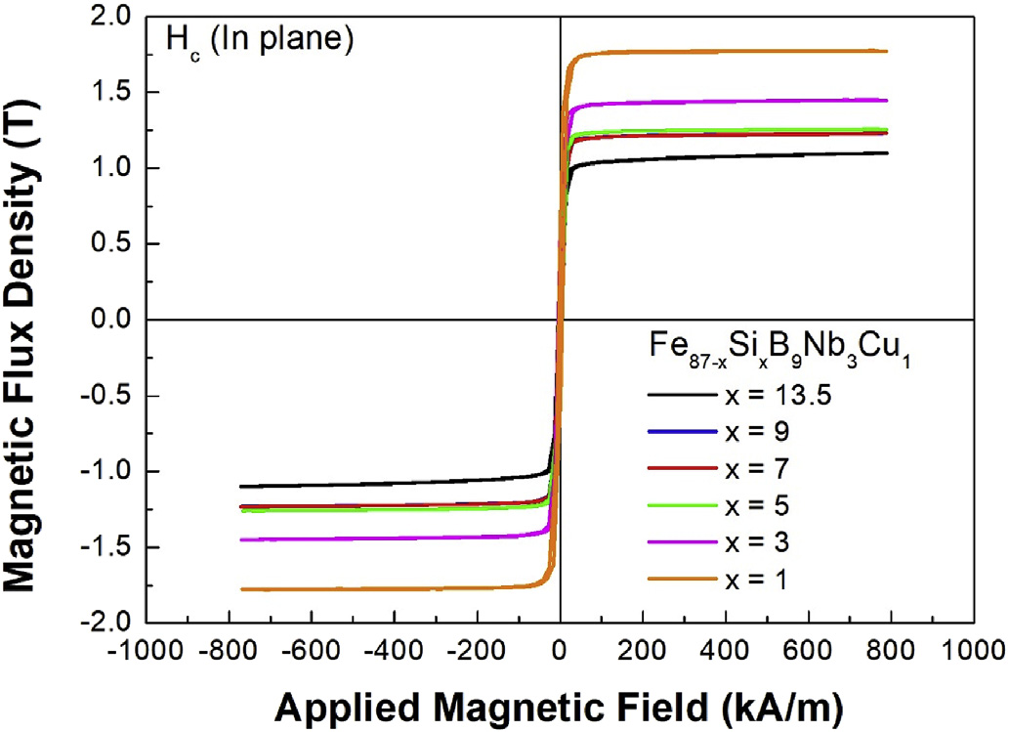
[picture p86: figure]

2. Experiments

Alloy ingots with a composition of Fe87-xSixB9Nb3Cu1 (x = 1, 3, 5, 7, 9, and 13.5) were prepared by arc-melting mixtures of high-purity Fe (99.95%), Si (99.999%), B (99.5%), Nb (99.95%), and Cu (99.99%) under the Ti-gettered argon atmosphere. All ingots were re-melted four times to properly mix the elements constituting the material.

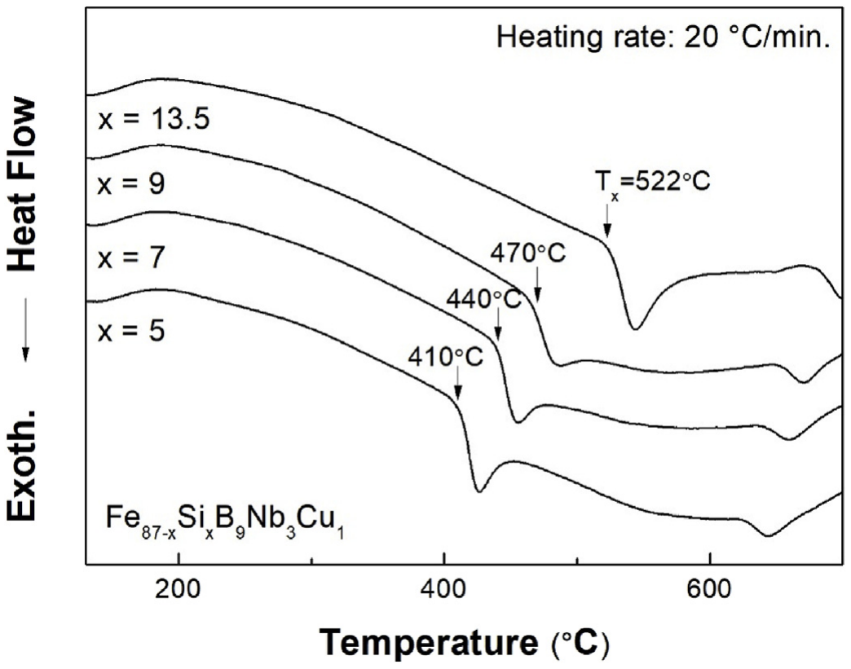
[picture p87: figure]
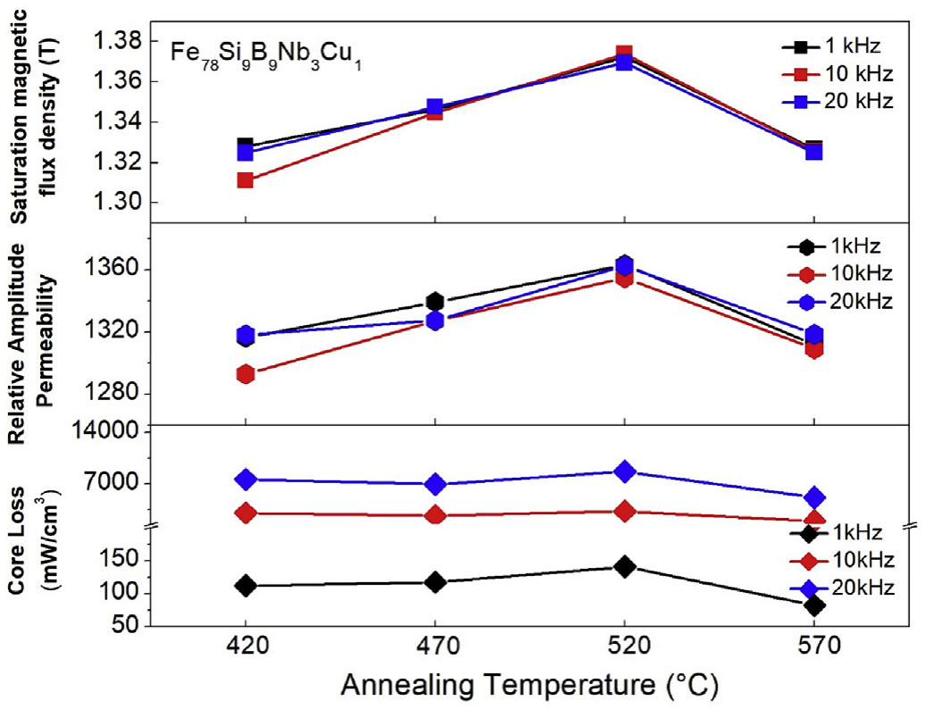
[picture p88: figure]

Amorphous alloys were produced in the form of ribbons with the thickness of 20–30 μm and width of 2 mm by using the melt spinning under argon atmosphere at the roll speed of 39.3 m s⁻¹
. The as-spun
samples were subjected to annealing treatments at various temperatures above Tx for 60 min under the argon atmosphere. The structures of as-spun and annealed samples were examined by X-ray diffraction (XRD) with Cu-Kα radiation and transmission electron microscopy (TEM). Thermal properties associated with the Tx were investigated by differential scanning calorimetry (DSC) under the flowing argon atmosphere and constant heating rate of 0.34 K s⁻¹
. The hysteresis loops

Fig. 1. The XRD patterns of the Fe87-xSixB9Nb3Cu1 (x = 1, 3, 5, 7, 9, and 13.5) as-spun ribbons.

Fig. 2. Hysteresis loops of the Fe87-xSixB9Nb3Cu1 (x = 1, 3, 5, 7, 9, and 13.5) as-spun ribbons.

Table 1
Saturation magnetic flux densities, structures, and compositions of the Fe87-xSixB9Nb3Cu1 (x = 1, 3, 5, 7, 9, and 13.5) as-spun ribbons.
Composition (at.%) | Structure | Bs (T)
Fe | Si | B | Nb | Cu
73.5 | 13.5 | 9 | 3 | 1 | Amorphous | 1.10 | FINEMET
78 | 9 | 9 | 3 | 1 | Amorphous | 1.23
80 | 7 | 9 | 3 | 1 | Amorphous | 1.23
82 | 5 | 9 | 3 | 1 | Amorphous | 1.26
84 | 3 | 9 | 3 | 1 | bcc-Fe | 1.45
86 | 1 | 9 | 3 | 1 | bcc-Fe | 1.77

Fig. 3. The DSC curves of the Fe87-xSixB9Nb3Cu1 (x = 5, 7, 9, and 13.5) as-spun ribbons.

Table 2
Annealing temperature, crystallization temperatures, and compositions of the Fe87-xSixB9Nb3Cu1 (x = 5, 7, 9, and 13.5) as-spun ribbons.
Composition (at.%) | Tx (°C) | Annealing temperature (°C), 1h
Fe | Si | B | Nb | Cu
73.5 | 13.5 | 9 | 3 | 1 | 522 | 450 | 500 | 550 | 600
78 | 9 | 9 | 3 | 1 | 470 | 420 | 470 | 520 | 570
80 | 7 | 9 | 3 | 1 | 440 | 390 | 440 | 490 | 540
82 | 5 | 9 | 3 | 1 | 410 | 360 | 410 | 460 | 510

Fig. 4. Variation of Bs, μr, and Pcv values in the annealed ribbons of Fe78Si9B9Nb3Cu1 at 1, 10, and 20 kHz for 60 min with increasing Ta.

S. Kwon, et al. | Current Applied Physics 20 (2020) 37–42

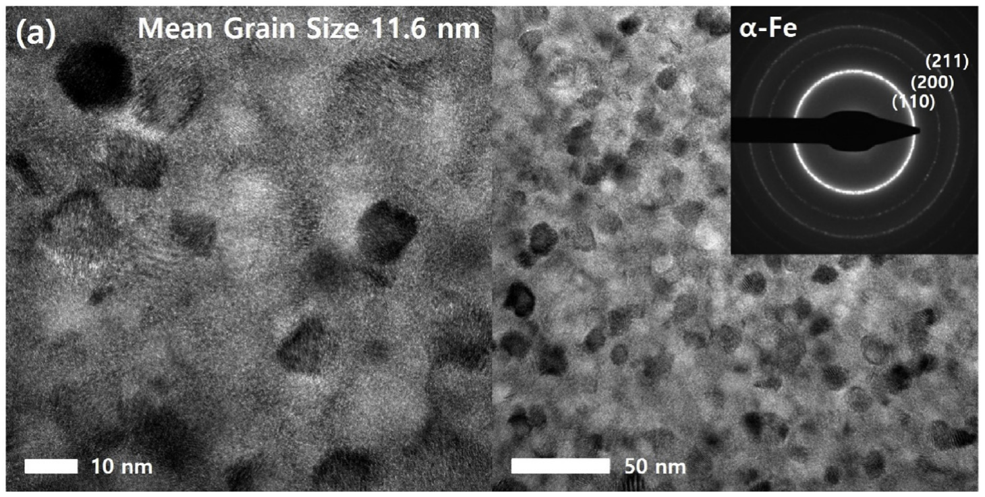
[picture p89: figure]

of as-spun and annealed samples were measured at room temperature with a vibrating sample magnetometer (VSM) under the in-plane applied magnetic field ranging from −10,000 to 10,000 Oe. In addition, the magnetic properties of Bs,Hc, μr and Pcv were examined using an AC B–H loop tracer. The Bs, μr and Hc were measured under the maximum applied filed (Hm) of 800 A/m, and the Pcv was measured under f of 100 kHz, and the Hm of 0.1 T.

3. Results and discussion

Fig. 1 shows the XRD patterns for the as-spun ribbons of Fe87-xSixB9Nb3Cu1 (x = 1, 3, 5, 7, 9, and 13.5). The patterns consisted of a broad halo hump, indicating the formation of the amorphous phase. No diffraction sharp peak corresponding to a crystalline phase was observed for x = 5, 7, 9, and 13.5. As can be seen in Fig. 1, when the Fe content exceeded 84 at.%, the as-quenched samples were heavily crystallized, and these sharp peaks corresponded to α-Fe nanocrystals. Fig. 2 depicts the hysteresis loops for the Fe87-xSixB9Nb3Cu1 (x = 1, 3, 5, 7, 9, and 13.5) as-spun ribbons. All loops exhibited typical soft magnetic behaviors. The high saturation magnetization (Ms) of the amorphous ribbons was measured using VSM; the values of Ms were summarized in Table 1. As can be seen in Fig. 2,Ms increased from 1.10 T to 1.26 T with the decrease of Si content from 13.5 to 5 at.%. The other two alloys (x = 1 and 3) show high Ms, because both contain bcc phases. It is assumed that the volume fraction of the bcc phase that have higher magnetization than that of the amorphous phase decreases with increase in Fe content for the ribbons with the mixed structure [9]. It is well known that the appropriate crystallization volume fraction leads to the compensation of magnetostriction of bcc-Fe phase and of the remaining amorphous one [10].
DSC under the flowing argon atmosphere is necessary to search the annealing temperature which should be higher than Tx. The DSC curves which indicate the crystallization behavior of as spun ribbons with x = 5, 7, 9, and 13.5 are shown in Fig. 3. The exothermic peaks observed in the two-stage crystallization process in the DSC curve are related to the crystallization sequence of the amorphous alloys. These peaks could be attributed either to the further crystallization of the residual amorphous phase, or to phase transformation of the existing metastable phases, such as bcc-Fe, occurring after the primary crystallization. Based on the DSC results, the annealing temperature values, Ta, were in the temperature range between the end of the first stage and the start of the second stage, so that only the α-Fe phase would precipitate during annealing.
In order to achieve the nanocrystalline state, the ribbons were submitted to annealing treatments under the argon atmosphere at various temperatures in the vicinity of Tx. The annealing temperatures are summarized in Table 2.
The annealing temperature dependence of Pcv, μr, and Bs for the amorphous and partially crystallized x = 9 sample are shown in Fig. 4. As can be seen in Fig. 4,Bs considerably increased with an increase of Ta. Furthermore, Bs reached the maximum value of 1.37 T, then decreased at Ta = 570 °C. The μr showed a variation tendency similar that

Fig. 5. Bright-field TEM image (left), selected area diffraction pattern (top-right) of the α-Fe phase, and the low magnification TEM image (right) of Fe73.5Si13.5B9Nb3Cu1 ribbons annealed at (a) 500, (b) 550, and (c) 600 °C.

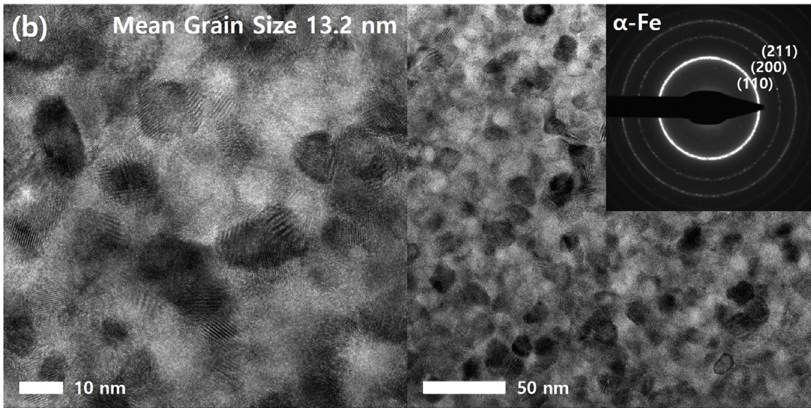
[picture p90: figure]

Fig. 5. (continued)

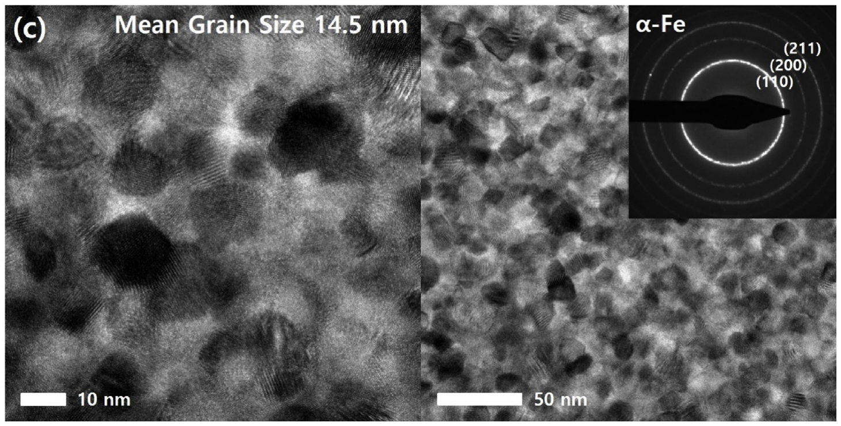
[picture p91: figure]
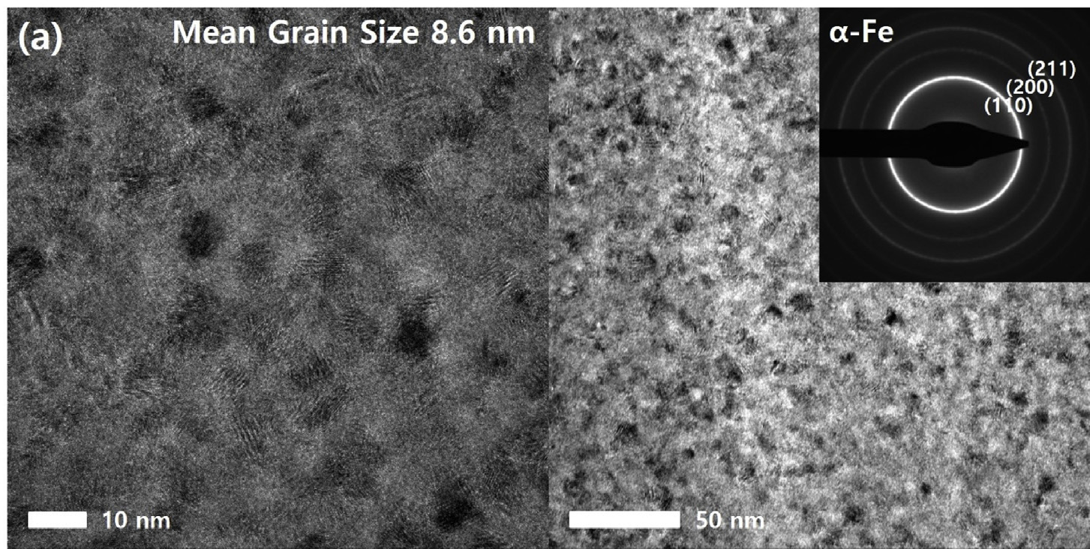
[picture p92: figure]
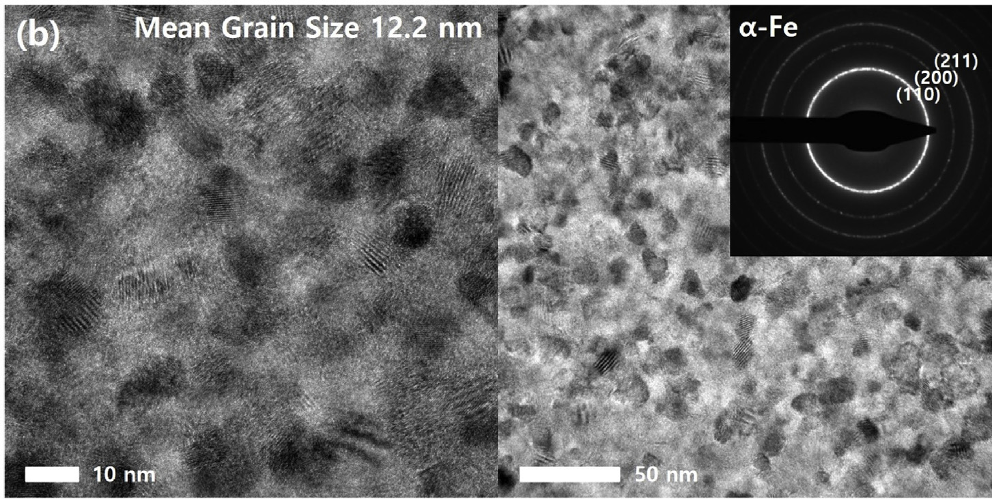
[picture p93: figure]

observed in Bs; however, Pcv remained remarkably stable with the increase of Ta. The values of Pcv measured at 1 kHz retained a relatively low value as compared to those measured at 10 and 20 kHz; the minimum value of Pcv was 82 mW/cm³ at Ta = 570 °C.
The changes in microstructure upon annealing were examined by TEM. Fig. 5(a)–(c) shows the TEM micrographs of differently heat treated FINEMET samples (x = 13.5). The sample annealed for 1h at 500 °C is an example of thermally relaxed residual stress. The ribbon annealed at 550 °C for 1h corresponds to the alloy with a low fraction of nanocrystallines. The presence of a higher amount of crystalline phase is clearly visible for the ribbon annealed at 600 °C. According to the SAED pattern, the structure of nanocrystals confirmed to be bcc. Typical

Fig. 5. (continued)

Fig. 6. Bright-field TEM image (left), selected area diffraction pattern (top-right) of the α-Fe phase, and the low magnification TEM image (right) of Fe78Si9B9Nb3Cu1 ribbons annealed at (a) 470, (b) 520, and (c) 570 °C.

Fig. 6. (continued)

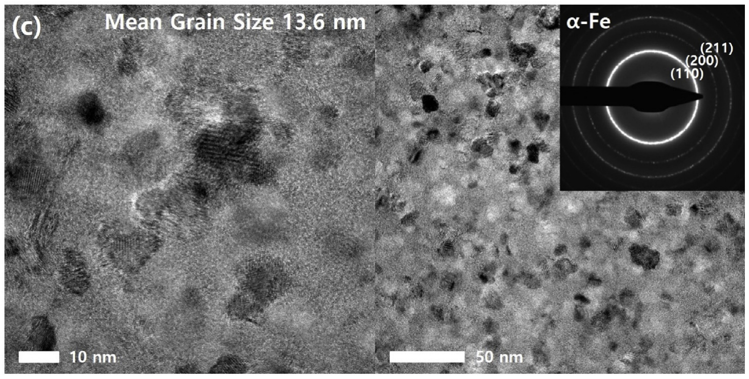
[picture p94: figure]
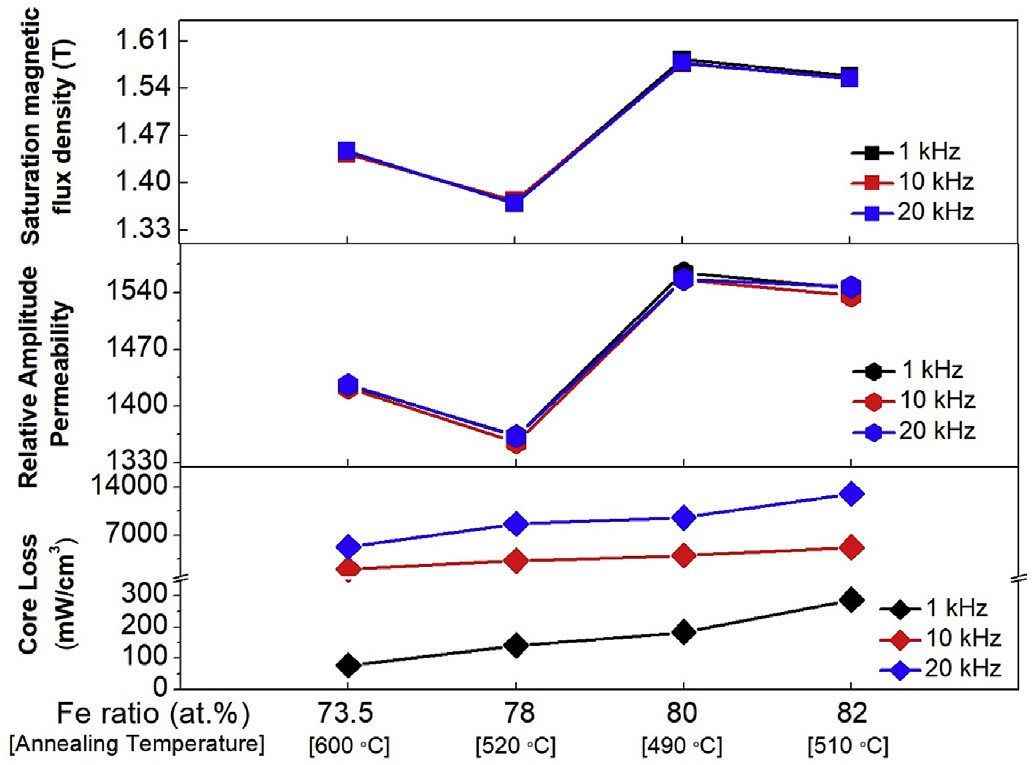
[picture p95: figure]

dimensions of ultrafine crystalline grains increased from 11.6 to 14.5 nm. This trend occurs because of the microstructure change from an amorphous to a crystalline structure caused by the precipitation of bcc-Fe phase and the changing volume fraction of the nanocrystalline phase. These increase in grain sizes resulted in improved of the value of μr and Bs, whereas the grain size is too large, the soft magnetic properties deteriorate due to the grain coarsening. Thus, the size of the Fe crystallites has been reported to be the most important feature [11–13]. As shown in Fig. 6(a)–(c), at the surface of the Fe78Si9B9Nb3Cu1 (x = 9) specimen, the Fe particles significantly grew by the increase in Ta from 470 to 570 °C. Typical dimensions of ultrafine crystallites increased from 8.6 to 13.6 nm. The distribution of the particles in the specimen annealed from 470 to 570 °C appeared uniform with no no-
ticeable | segregation, | resulting | in | improvement | of | Bs | of
Fe78Si9B9Nb3Cu1.
Fig. 7 shows the values of Pcv, μr, and Bs with Fe content of x at.%. The graph shows an interesting trend that the tendencies of Bs and μr are similar. The Fe80Si7B9Nb3Cu1 represented the excellent soft magnetic properties such as high Bs of 1.57 T. With an increasing Fe substitution for Si, the Bs and μr increased fairly linearly, but the Fe78Si9B9Nb3Cu1 (x = 9) deviated from that trend. Therefore, this temperature was selected to study the influence of magnetic field annealing on the soft magnetic properties. We additionally conducted heat treatment under magnetic field to improve the Bs and μr values. To this end, the Fe73.5Si13.5B9Nb3Cu1 (FINEMET for reference) and

Fe78Si9B9Nb3Cu1 (x = 9) ribbon samples were coiled into a toroidal core with the outer diameter of 13 mm and the inner diameter of 8 mm using a core winding machine, and the cores were annealed in a longitudinal magnetic field. The cores were annealed under the longitudinal applied magnetic field of 0.15 T at 520 and 570 °C for 60 min to improve the soft magnetic properties. Properties of these annealed cores are characterized by two basic parameters: (1) Presence or absence of magnetic field and (2) Ta. The results of the cores annealed at 520 °C are shown in Fig. 8(a)–(c). The cores annealed under the presence of longitudinal magnetic field results in squarish hysteresis loops characterized by a significant reduction of the coercive field. The cores annealed in the longitudinal magnetic field exhibit an advanced degree of Bs and Hc as compared to the ribbons annealed in the non-magnetic field. The magnetic properties of Fe78Si9B9Nb3Cu1 (x = 9) cores, including annealing conditions, are summarized in Table 3. The Hc values of the specimens annealed at Ta = 520 °C significantly decreased from 57.728 to 11.270 at 1 kHz, from 121.32 to 18.294 at 10 kHz, and from 152.74 to 22.910 at 20 kHz. Typical Bs for the thermally relaxed by non-magnetic field annealing at 520 °C samples were around 1.37 T, while those for the samples annealed in the longitudinal magnetic field had the average value of 1.51 T below 20 kHz. These soft magnetic properties (such as high Bs of 1.51 T) are excellent as compared to the conventional value of FINEMET core (Bs = 1.23 T) [6].

4. Conclusion

In the present study, a controllable longitudinal magnetic field annealing was conducted in a series of amorphous and nanocrystalline Fe87-xSixB9Nb3Cu1 (x = 1, 3, 5, 7, 9, and 13.5) samples under various conditions. The effects of Fe substitution in the Fe–Si–B–Nb–Cu amorphous alloys on the soft magnetic properties were investigated from the viewpoint of nanocrystallization. The main results can be summarized as follows.

(1) For Fe87-xSixB9Nb3Cu1 (x = 1, 3, 5, 7, 9, and 13.5) alloys, the amorphous phase remained almost unchanged with Fe content higher than 5 at.%, but clearly changed to a mostly single bcc phase at Fe contents lower than 3 at.%.
(2) The bcc-Fe particle size significantly increased by the annealing temperature, Ta. These decrease of volume fraction result in fairly
improve | the | value | of | Ms. | For | example, | the
Fe80Si7B9Nb3Cu1 represented the excellent soft magnetic properties such as high Bs of 1.57 T.
(3) The Bs, μr,Hc and Pcv values of the specimens annealed under longitudinal magnetic field considerably improved as compared to those of the non-magnetic field annealed specimens. In addition,

Fig. 6. (continued)

Fig. 7. Variation of Bs, μr, and Pcv values of the ribbons annealed at 1, 10, and 20 kHz for 60 min as Fe content of x at.%.

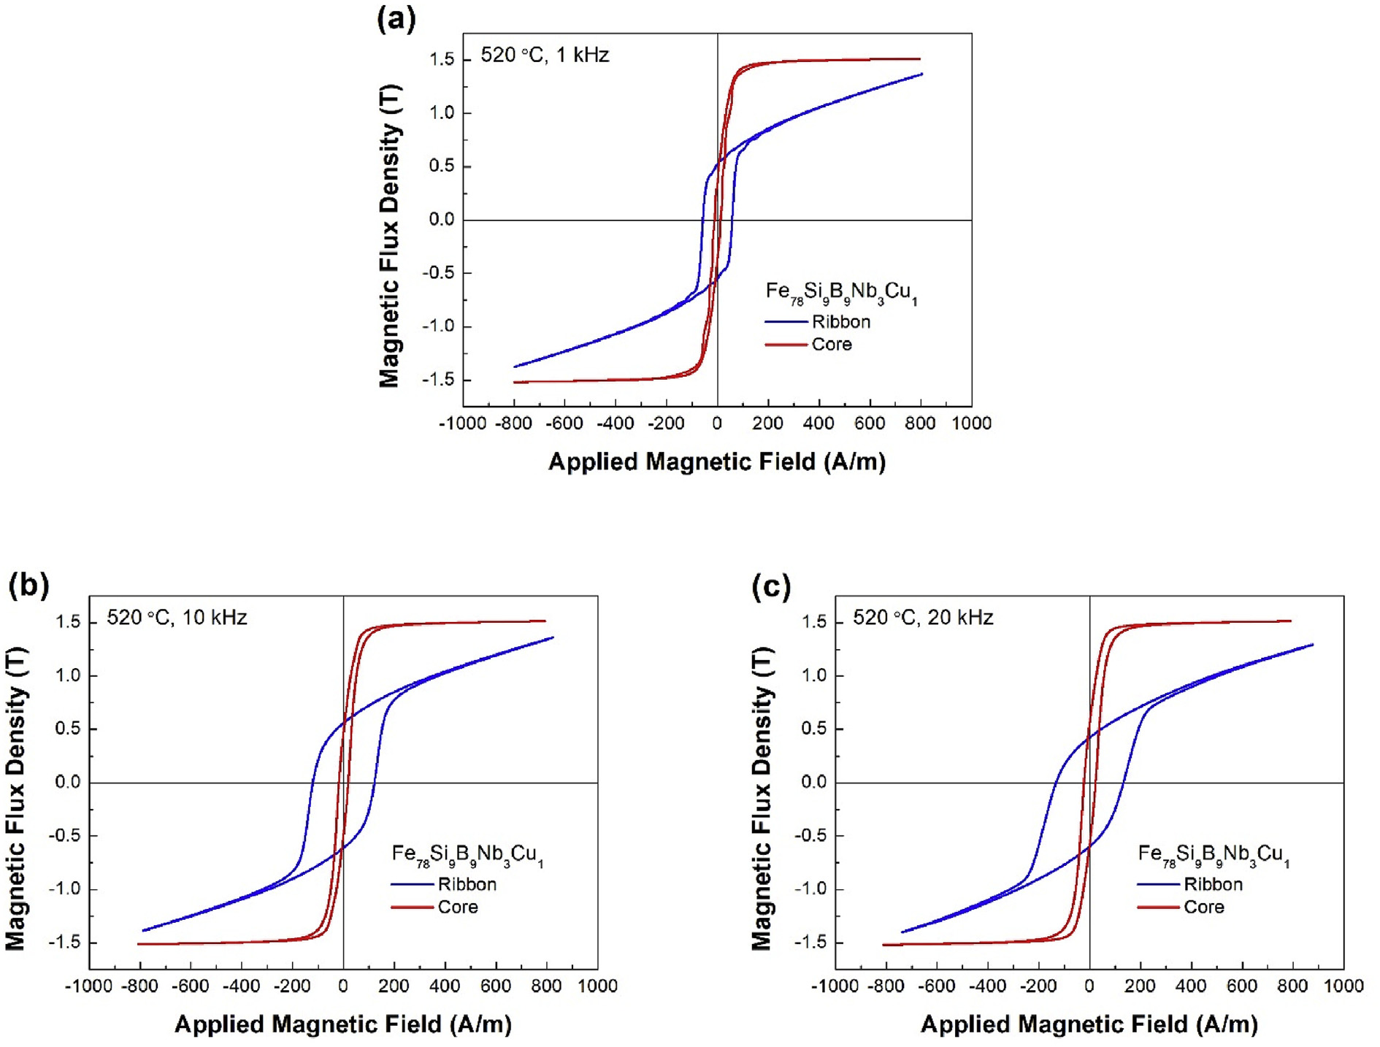
[picture p96: figure]

the results suggest that a good compromise of Bs,Hc, μr, and Pcv values was obtained in the core annealed at Ta = 520 °C. The proposed alloy system, Fe78Si9B9Nb3Cu1 produces excellent soft magnetic properties, such as high Bs of 1.51 T as compared to the conventional value of FINEMET core (Bs = 1.23 T).

The new level of Bs obtained in this particular composition is considerably different from previous results and opens a novel path to new technologies for common mode choke or inductance applications.

Acknowledgements

This research was supported by the National Research Foundation of Korea (NRF) grant funded by the Korea government(MSIT) (2018R1A2B2006784).

References

[1] X. Fan, F. Zhu, Q. Wang, M. Jiang, B. Shen, Appl. Microsc. 47 (2017) 29–35. (http://refhub.elsevier.com/S1567-1739(19)30253-6/sref1)
[2] Y. Yoshizawa, S. Oguma, K. Yamauchi, J. Appl. Phys. 64 (1988) 6044. (http://refhub.elsevier.com/S1567-1739(19)30253-6/sref2)
[3] Y. Yoshizawa, K. Yamauchi, Mater. Sci. Eng., A A133 (1991) 176–179. (http://refhub.elsevier.com/S1567-1739(19)30253-6/sref3)
[4] G. Pozo Lopez, L.M. Fabietti, A.M. Condo, S.E. Urreta, J. Magn. Magn. Mater. 322 (2010) 3088–3093. (http://refhub.elsevier.com/S1567-1739(19)30253-6/sref4)
[5] G. Herzer, Phys. Scr. T49 (1993) 307. (http://refhub.elsevier.com/S1567-1739(19)30253-6/sref5)
[6] FINEMET, http://www.hitachi.co.kr/products/material/emc/nano/index.html, (2015) (accessed 19.03.01).
[7] I. Skorvanek, J. Marcin, J. Turcanova, J. Kovac, P. Svec, J. Alloy. Comp. 504S (2010) S135–S138. (http://refhub.elsevier.com/S1567-1739(19)30253-6/sref7)
[8] R. Boll, H. Warlimont, IEEE Trans. Magn. 17 (1981) 3053–3058. (http://refhub.elsevier.com/S1567-1739(19)30253-6/sref8)
[9] A. Makino, Y. Hayakawa, IEEE Trans. Magn. 31 (1995) 3874–3876. (http://refhub.elsevier.com/S1567-1739(19)30253-6/sref9)
[10] N. Chau, N.Q. Hoa, N.H. Luong, J. Magn. Magn. Mater. 290–291 (2005) 1547–1550. (http://refhub.elsevier.com/S1567-1739(19)30253-6/sref10)
[11] G. Herzer, IEEE Trans. Magn. 26 (1990) 1397–1402. (http://refhub.elsevier.com/S1567-1739(19)30253-6/sref11)
[12] A. Makino, T. Bitoh, J. Appl. Phys. 87 (2000) 7100–7102. (http://refhub.elsevier.com/S1567-1739(19)30253-6/sref12)
[13] T. Bitoh, M. Nakazawa, A. Makino, J. Appl. Phys. 85 (1999) 5127–5129. (http://refhub.elsevier.com/S1567-1739(19)30253-6/sref13)

Fig. 8. Hysteresis B–H loops of Fe78Si9B9Nb3Cu1 (Ta = 520 °C) ribbons and cores acquired via an AC B–H loop tracer at 1, 10, and 20 kHz.

Table 3
Summary of saturation magnetic flux density (Bs), coercivity (Hc), relative
permeability (μr), and core loss (Pcv) for Fe78Si9B9Nb3Cu1 cores at 1, 10, 20, and 100 kHz with Ta = 520 and 570 °C.
Fe78Si9B9Nb3Cu1 | TA = 520 °C | TA = 570 °C
| @ Non- magnetic field

@
Magnetic
field
| | @ Non- magnetic field

@ Magnetic
field
Bs (T) | 1 kHz | 1.3722 | 1.5147 | 1.3268 | 1.3350
| 10 kHz | 1.3739 | 1.5147 | 1.3257 | 1.3345
| 20 kHz | 1.3693 | 1.5165 | 1.3249 | 1.3376
| 100 kHz | – | 1.3993 | – | 1.1885
μr | 1 kHz | 1363.3 | 1511.5 | 1311.7 | 1331.8
| 10 kHz | 1354.9 | 1506.7 | 1309.0 | 1326.8
| 20 kHz | 1362.6 | 1506.2 | 1318.5 | 1327.3
| 100 kHz | – | 1387.2 | – | 1113.6

Pcv (mW/cm³
) | 1 kHz | 140.95 | 50.860 | 82.239 | 50.994
| 10 kHz | 3258.3 | 856.50 | 1936.3 | 937.38
| 20 kHz | 8639.2 | 2354.3 | 5140.4 | 2698.4
| 100 kHz | – | 31740 | – | 33830
Hc (A/m) | 1 kHz | 57.728 | 11.270 | 40.049 | 41.544
| 10 kHz | 121.32 | 18.294 | 78.465 | 47.407
| 20 kHz | 152.74 | 22.910 | 96.125 | 51.191
| 100 kHz | – | 56.000 | – | 72.151
