LenaMatota/MechatronicsProject478/Building the joint/Bearing - shaft tolerance grades - mm values.jpg

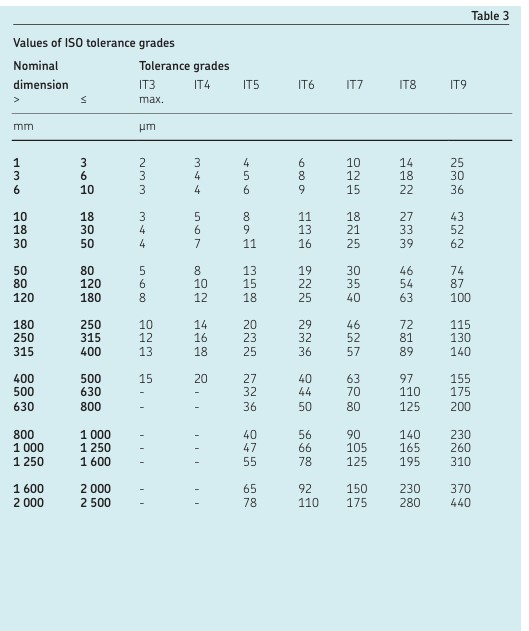
Building the joint/Bearing - shaft tolerance grades - mm values.jpg
