LenaMatota/MechatronicsProject478/Building the joint/Bearing - shaft tolerance grades.jpg

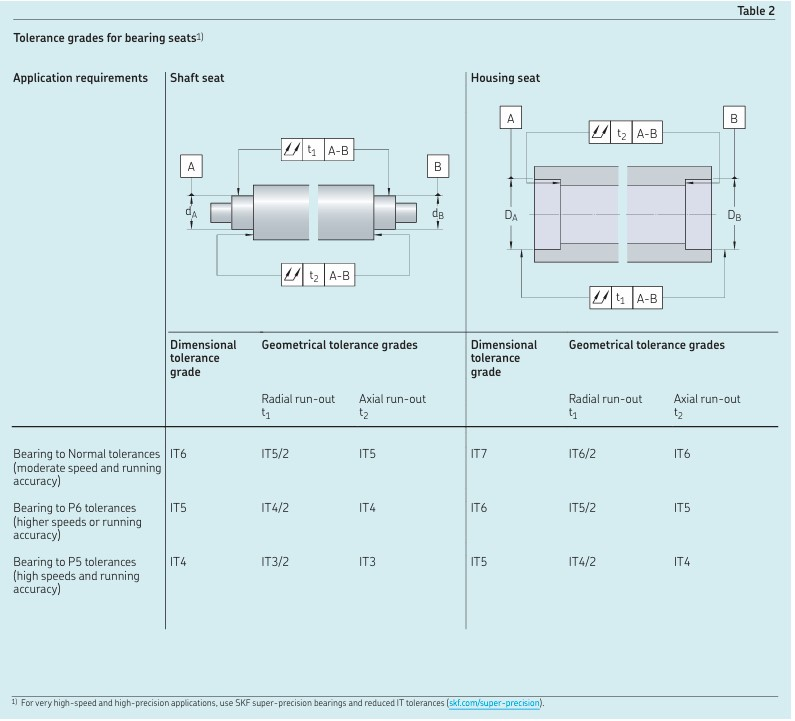
Building the joint/Bearing - shaft tolerance grades.jpg
