LenaMatota/MechatronicsProject478/Building the joint/electromagnetic clutch.jpg

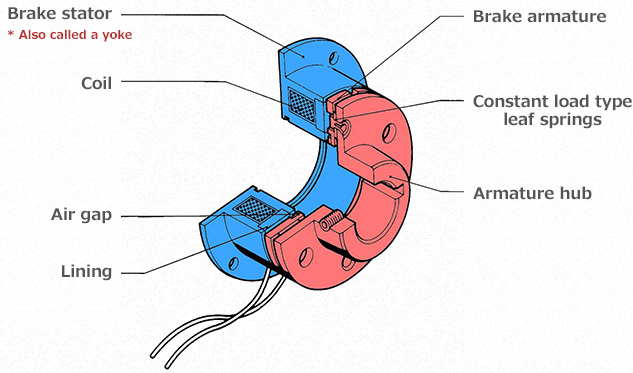
Building the joint/electromagnetic clutch.jpg
