LenaMatota/MechatronicsProject478/Building the joint/Encoder description.jpg

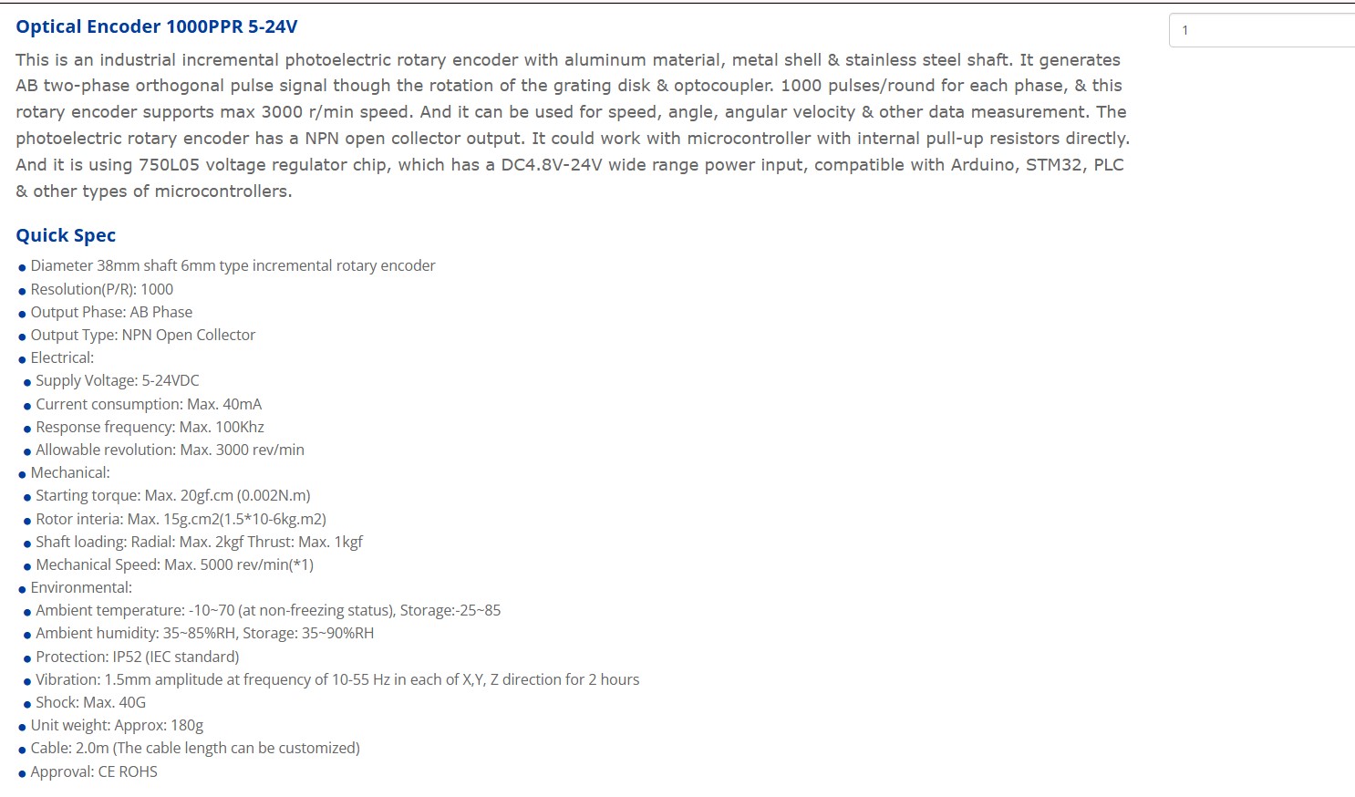
Building the joint/Encoder description.jpg
