LenaMatota/MechatronicsProject478/Building the joint/Joint pictures/Screenshot 2026-08-19 140827.jpg

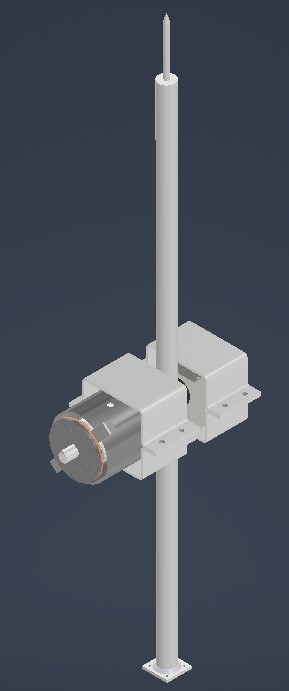
Building the joint/Joint pictures/Screenshot 2026-08-19 140827.jpg
