LenaMatota/MechatronicsProject478/Building the joint/Joint pictures/Screenshot 2026-08-19 140943.jpg

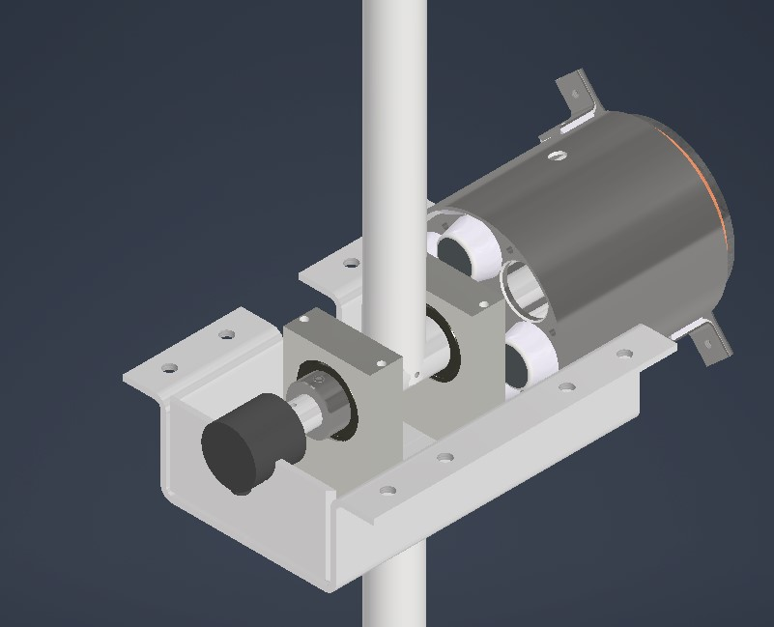
Building the joint/Joint pictures/Screenshot 2026-08-19 140943.jpg
