LenaMatota/MechatronicsProject478/Building the joint/Joint pictures/Screenshot 2026-10-20 203105.png

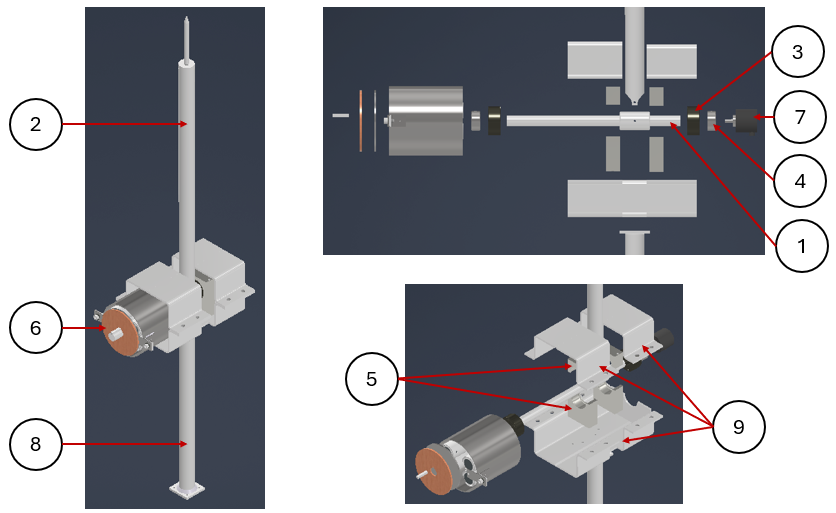
Building the joint/Joint pictures/Screenshot 2026-10-20 203105.png
