LenaMatota/MechatronicsProject478/Building the joint/Joint pictures/Screenshot 2026-10-21 103953.png

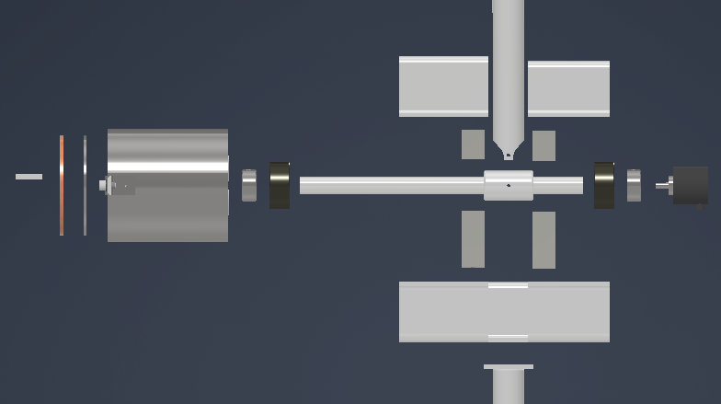
Building the joint/Joint pictures/Screenshot 2026-10-21 103953.png
