LenaMatota/MechatronicsProject478/Building the joint/Joint Assembly/Drawings/24989142-10-00-00-00 electromagnet.pdf

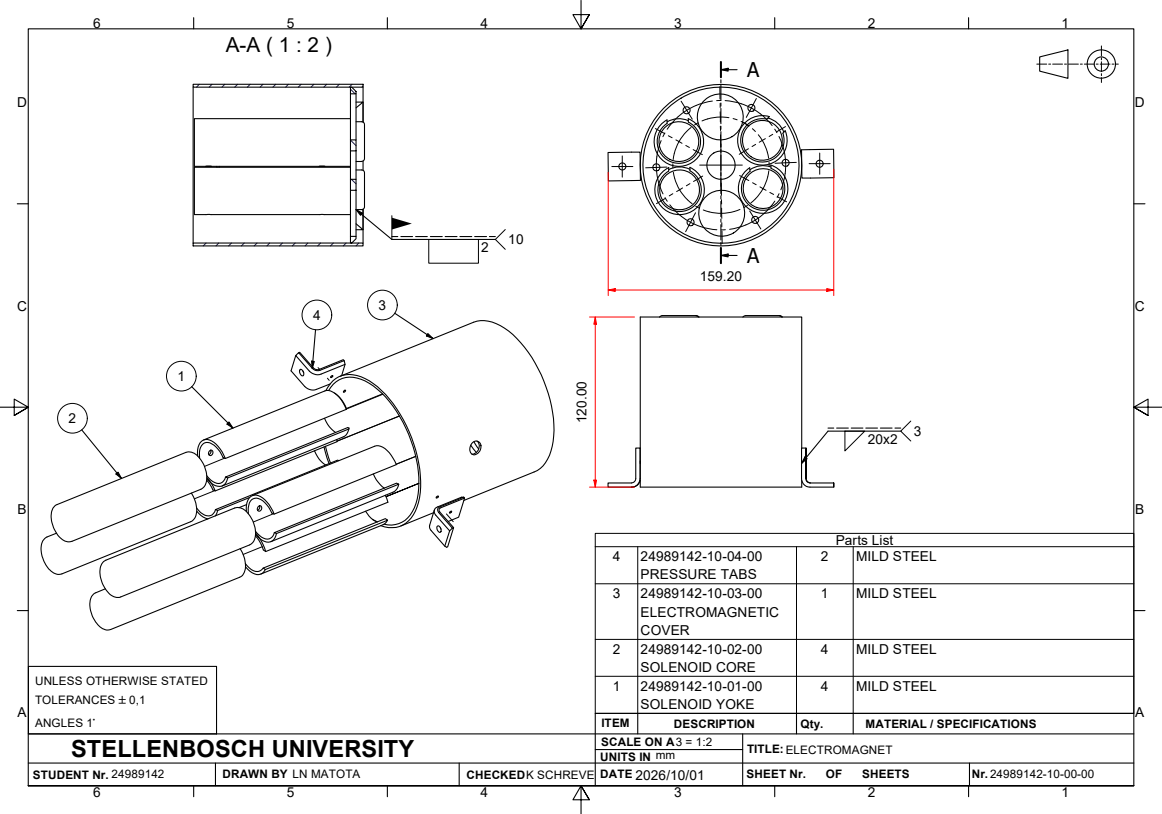
[picture p121: page 1]
Parts List; STUDENT Nr.; DRAWN BY; CHECKED; UNITS IN; SHEET Nr.; SHEETS; LN MATOTA; K SCHREVE

4 | 24989142-10-04-00 PRESSURE TABS | 2 | MILD STEEL

3 | 24989142-10-03-00 ELECTROMAGNETIC COVER | 1 | MILD STEEL

2 | 24989142-10-02-00 SOLENOID CORE | 4 | MILD STEEL

UNLESS OTHERWISE STATED
TOLERANCES `0,1
ANGLES 1~

1 | 24989142-10-01-00 SOLENOID YOKE | 4 | MILD STEEL

ITEM | DESCRIPTION | Qty. | MATERIAL / SPECIFICATIONS

STELLENBOSCH UNIVERSITY | SCALE ON A 3 = 1:2 | TITLE: ELECTROMAGNET
