LenaMatota/MechatronicsProject478/Building the joint/Joint Assembly/Drawings/24989142-11-00-00-00 pressure tab.pdf

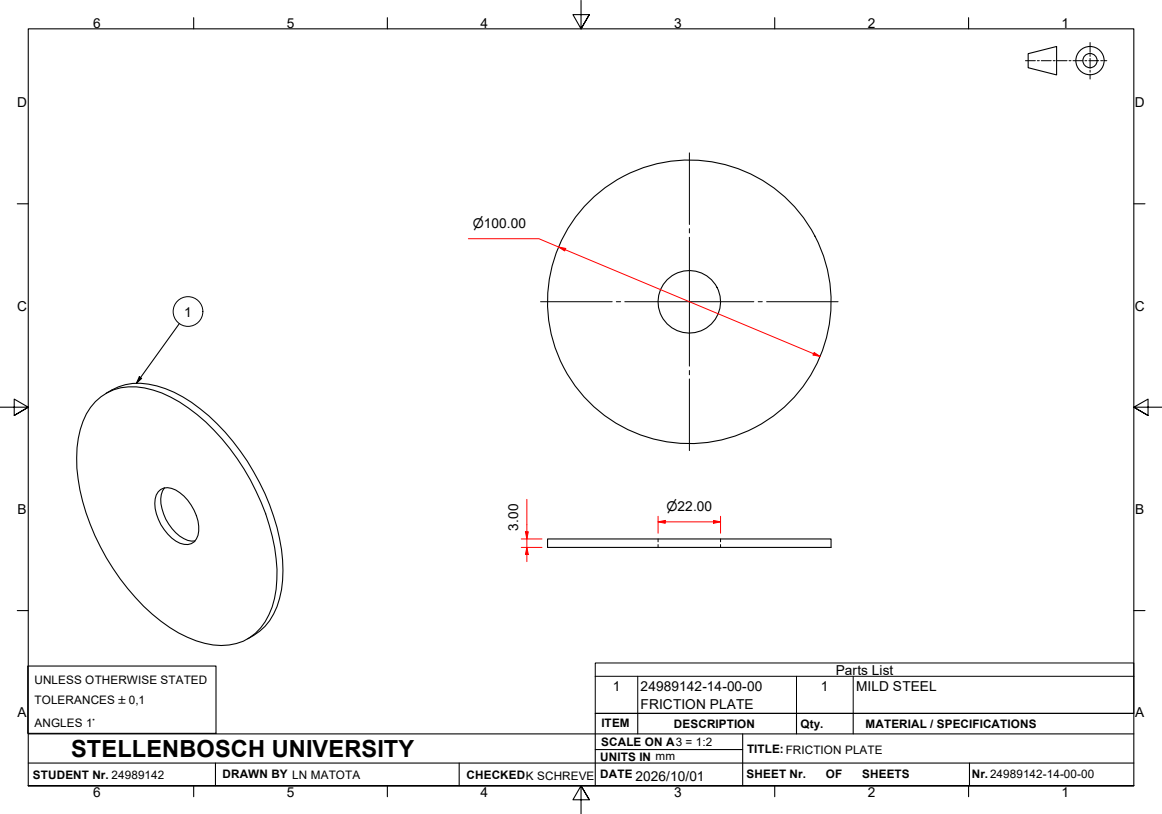
[picture p122: page 1]
Parts List; STUDENT Nr.; DRAWN BY; CHECKED; UNITS IN; SHEET Nr.; SHEETS; LN MATOTA; K SCHREVE

UNLESS OTHERWISE STATED
TOLERANCES `0,1
ANGLES 1~

1 | 24989142-14-00-00 FRICTION PLATE | 1 | MILD STEEL

ITEM | DESCRIPTION | Qty. | MATERIAL / SPECIFICATIONS

STELLENBOSCH UNIVERSITY | SCALE ON A 3 = 1:2 | TITLE: FRICTION PLATE
