LenaMatota/MechatronicsProject478/Building the joint/Joint Assembly/Drawings/Joint Assembly.pdf

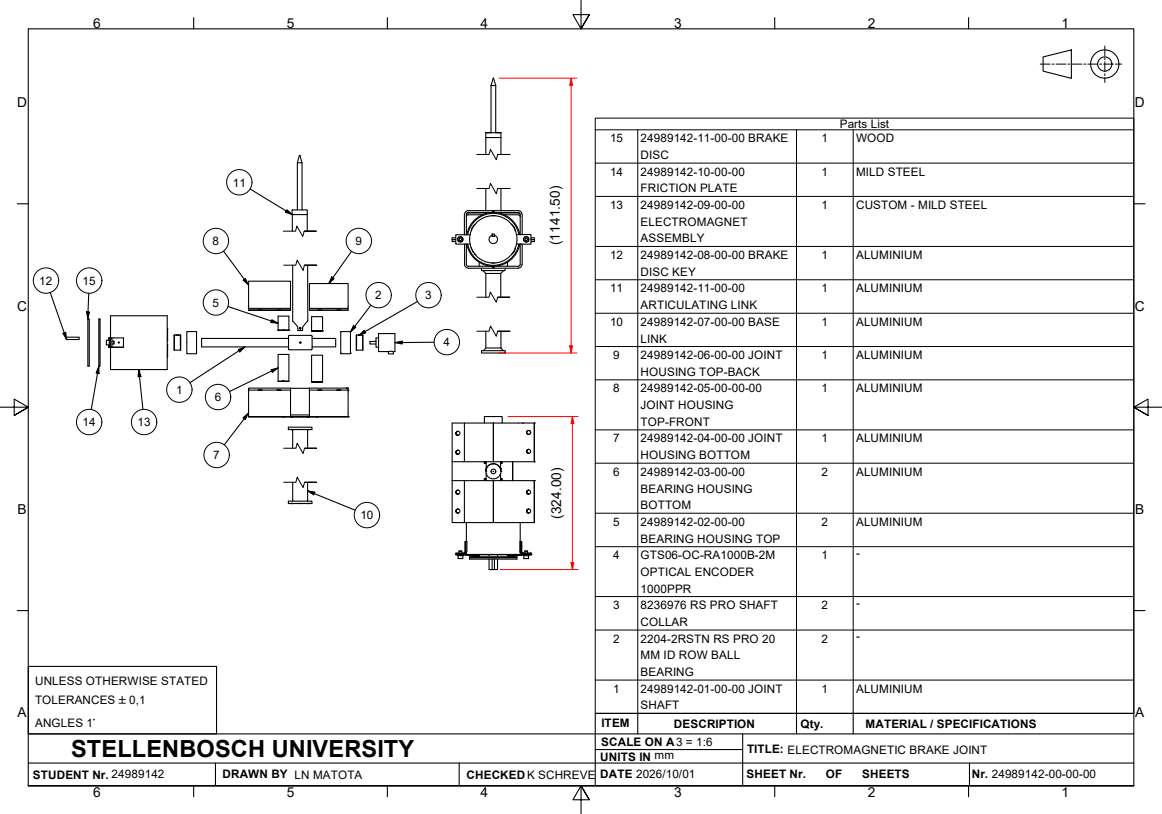
[picture p123: page 1]
Parts List; STUDENT Nr.; DRAWN BY; CHECKED; UNITS IN; SHEET Nr.; SHEETS; LN MATOTA; K SCHREVE

15 | 24989142-11-00-00 BRAKE DISC | 1 | WOOD

14 | 24989142-10-00-00 FRICTION PLATE | 1 | MILD STEEL

13 | 24989142-09-00-00 ELECTROMAGNET ASSEMBLY | 1 | CUSTOM - MILD STEEL

12 | 24989142-08-00-00 BRAKE DISC KEY | 1 | ALUMINIUM

11 | 24989142-11-00-00 ARTICULATING LINK | 1 | ALUMINIUM

10 | 24989142-07-00-00 BASE LINK | 1 | ALUMINIUM

9 | 24989142-06-00-00 JOINT HOUSING TOP-BACK | 1 | ALUMINIUM

8 | 24989142-05-00-00-00 JOINT HOUSING TOP-FRONT | 1 | ALUMINIUM

7 | 24989142-04-00-00 JOINT HOUSING BOTTOM | 1 | ALUMINIUM

6 | 24989142-03-00-00 BEARING HOUSING BOTTOM | 2 | ALUMINIUM

5 | 24989142-02-00-00 BEARING HOUSING TOP | 2 | ALUMINIUM

4 | GTS06 OPTICAL ENCODER 1000PPR | 1 | - -OC-RA1000B-2M

3 | 8236976 RS PRO SHAFT COLLAR | 2 | -

2 | 2204 MM ID ROW BALL BEARING | 2 | - -2RSTN RS PRO 20

UNLESS OTHERWISE STATED
TOLERANCES `0,1
ANGLES 1~

1 | 24989142-01-00-00 JOINT SHAFT | 1 | ALUMINIUM

ITEM | DESCRIPTION | Qty. | MATERIAL / SPECIFICATIONS

STELLENBOSCH UNIVERSITY | SCALE ON A 3 = 1:6 | TITLE: ELECTROMAGNETIC BRAKE JOINT
