LenaMatota/MechatronicsProject478/Building the joint/Joint Assembly/Drawings/24989142-02-00-00-00 bearing housing top.pdf

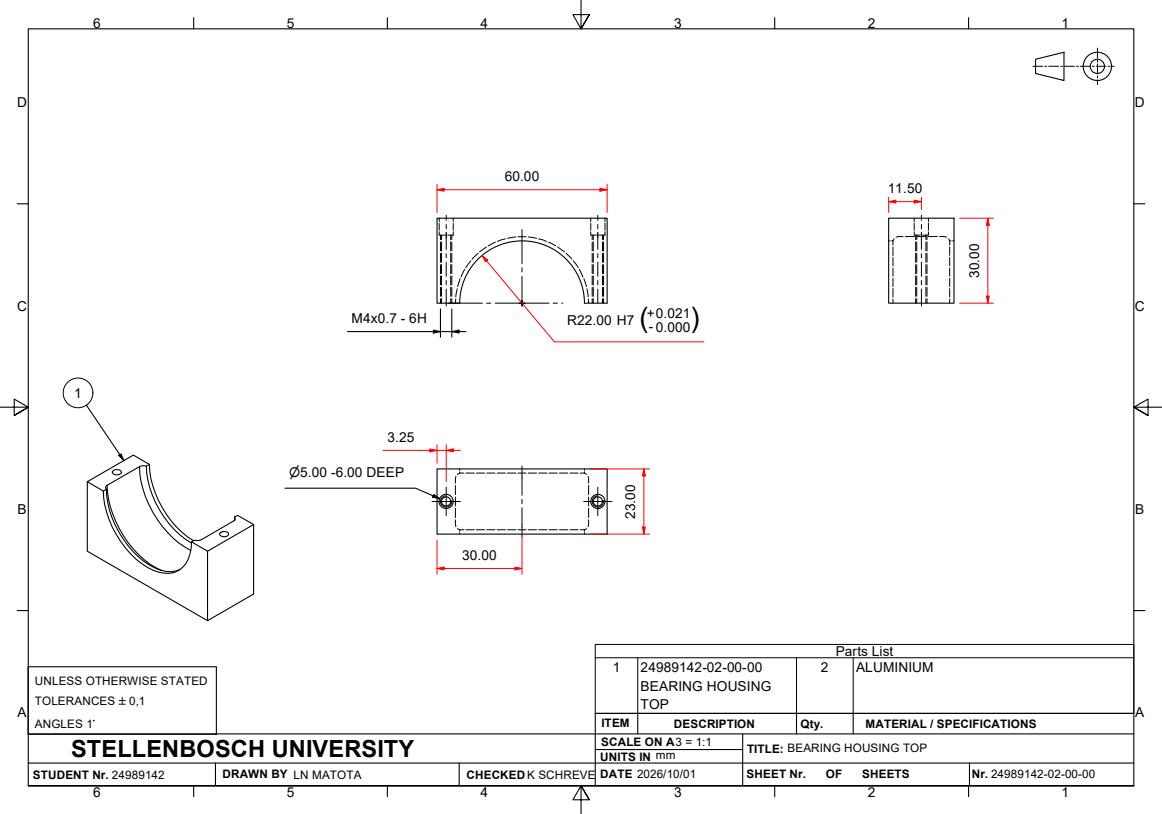
[picture p124: page 1]
Parts List; STUDENT Nr.; DRAWN BY; CHECKED; UNITS IN; SHEET Nr.; SHEETS; ⌀5.00 -6.00 DEEP; LN MATOTA; K SCHREVE

1 | 24989142-02-00-00 BEARING HOUSING TOP | 2 | ALUMINIUM

UNLESS OTHERWISE STATED
TOLERANCES `0,1
ANGLES 1~

ITEM | DESCRIPTION | Qty. | MATERIAL / SPECIFICATIONS

STELLENBOSCH UNIVERSITY | SCALE ON A 3 = 1:1 | TITLE: BEARING HOUSING TOP
