LenaMatota/MechatronicsProject478/Building the joint/Joint Assembly/Drawings/24989142-03-00-00-00 bearing housing bottom.pdf

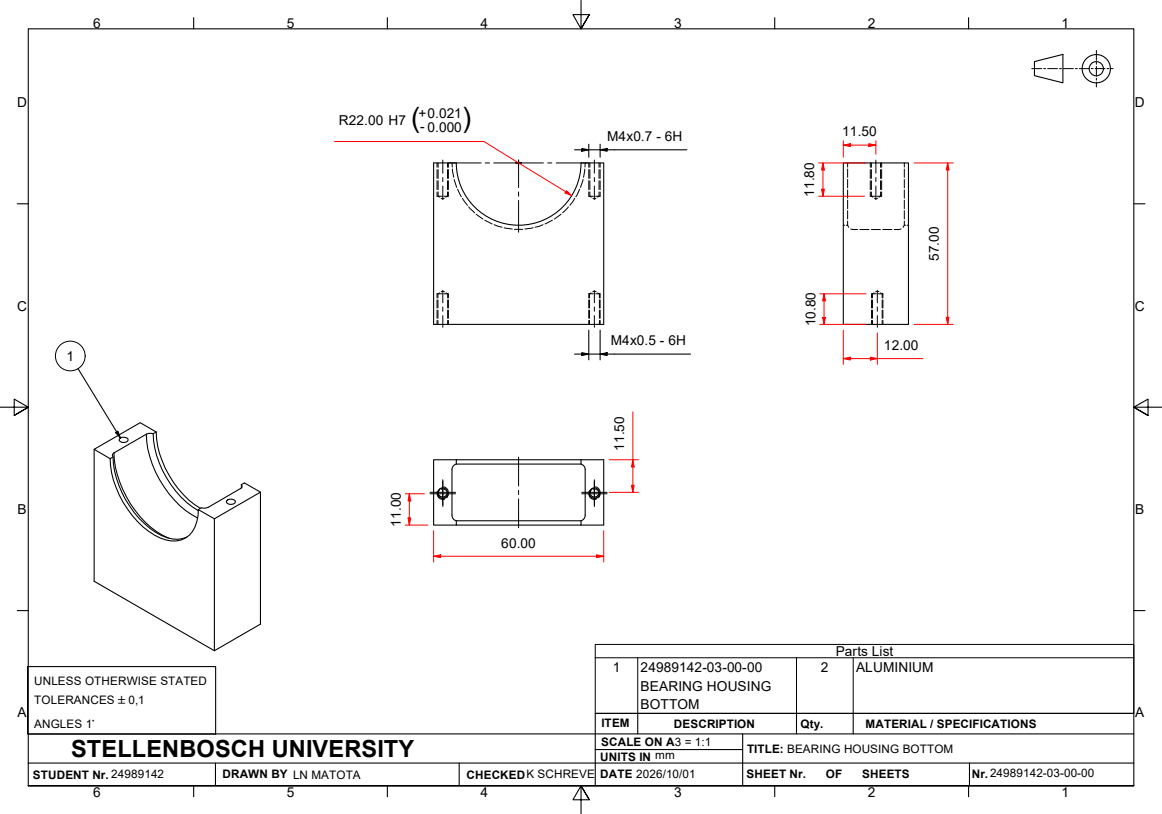
[picture p125: page 1]
Parts List; STUDENT Nr.; DRAWN BY; CHECKED; UNITS IN; SHEET Nr.; SHEETS; LN MATOTA; K SCHREVE

1 | 24989142-03-00-00 BEARING HOUSING BOTTOM | 2 | ALUMINIUM

UNLESS OTHERWISE STATED
TOLERANCES `0,1
ANGLES 1~

ITEM | DESCRIPTION | Qty. | MATERIAL / SPECIFICATIONS

STELLENBOSCH UNIVERSITY | SCALE ON A 3 = 1:1 | TITLE: BEARING HOUSING BOTTOM
