LenaMatota/MechatronicsProject478/Building the joint/Joint Assembly/Drawings/24989142-04-00-00-00 joint housing bottom.pdf

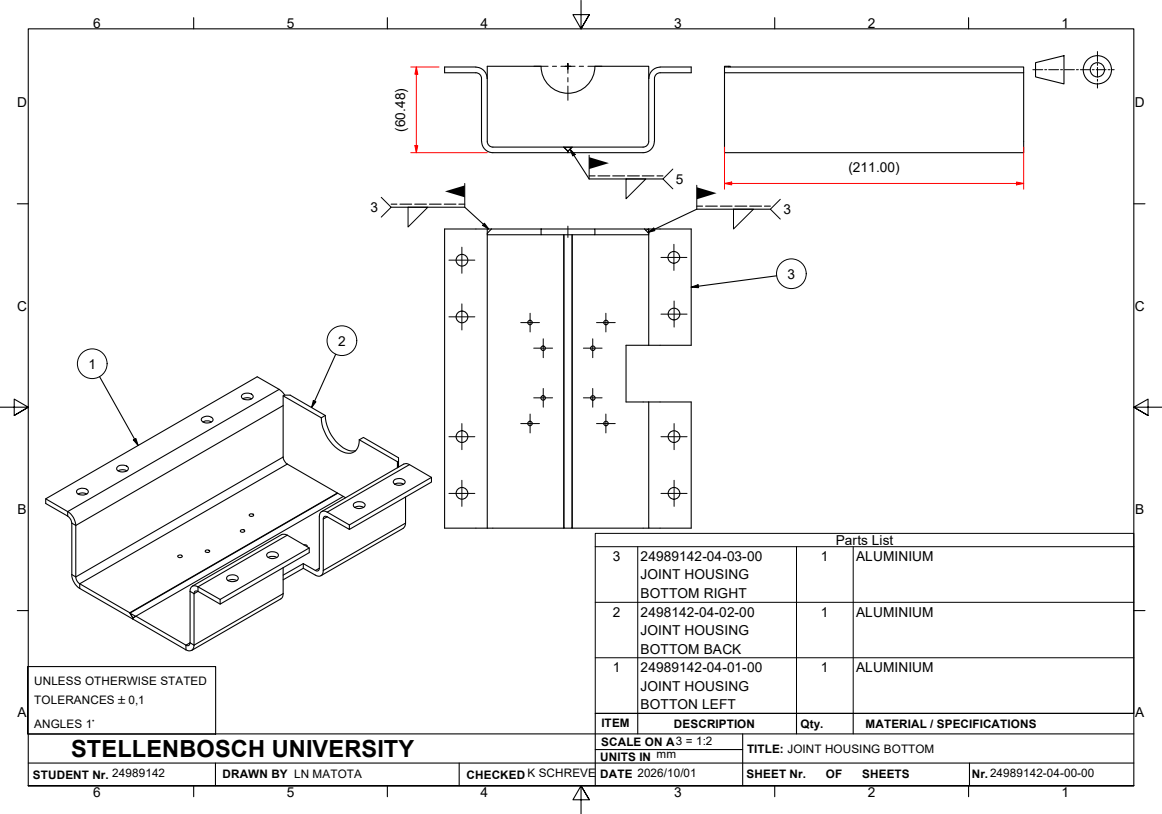
[picture p126: page 1]
Parts List; STUDENT Nr.; DRAWN BY; CHECKED; UNITS IN; SHEET Nr.; SHEETS; LN MATOTA; K SCHREVE

3 | 24989142-04-03-00 JOINT HOUSING BOTTOM RIGHT | 1 | ALUMINIUM

2 | 2498142-04-02-00 JOINT HOUSING BOTTOM BACK | 1 | ALUMINIUM

1 | 24989142-04-01-00 JOINT HOUSING BOTTON LEFT | 1 | ALUMINIUM

UNLESS OTHERWISE STATED
TOLERANCES `0,1
ANGLES 1~

ITEM | DESCRIPTION | Qty. | MATERIAL / SPECIFICATIONS

STELLENBOSCH UNIVERSITY | 3 = 1:2 SCALE ON A | TITLE: JOINT HOUSING BOTTOM
