LenaMatota/MechatronicsProject478/Building the joint/Joint Assembly/Drawings/24989142-04-01-00-00 joint housing bottom left.pdf

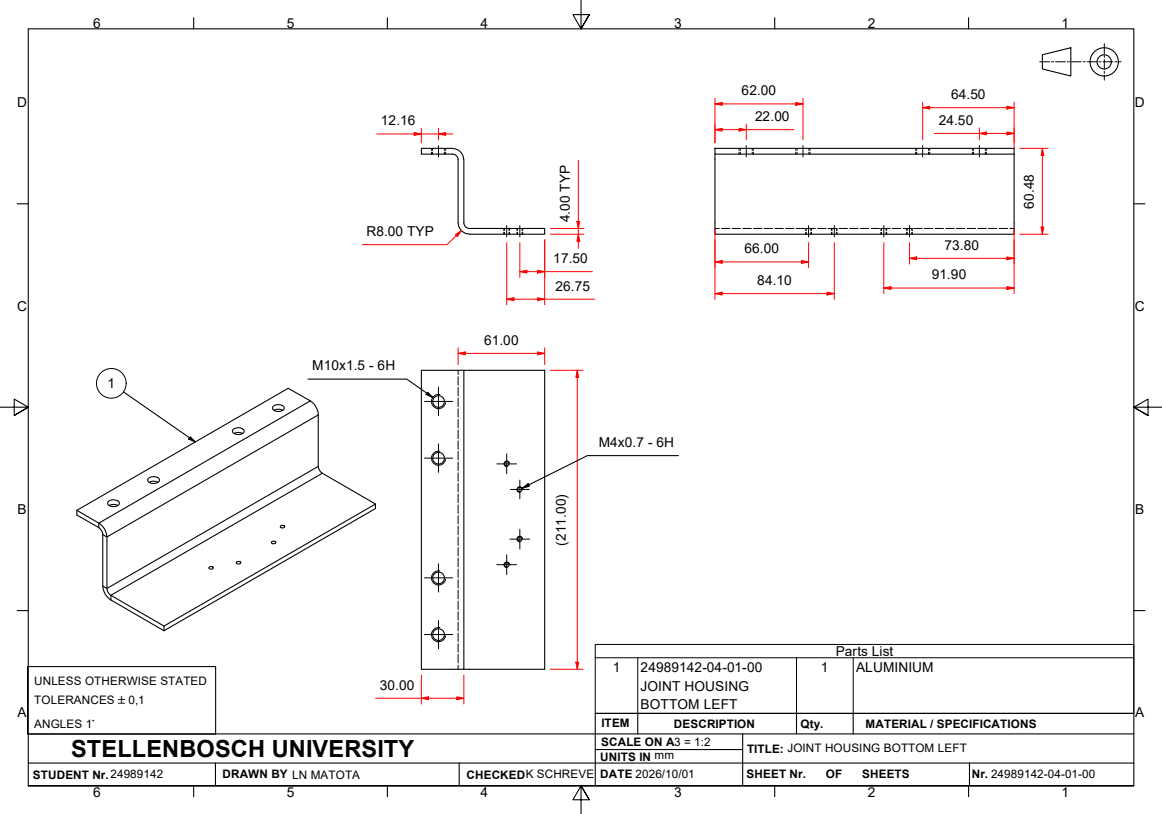
[picture p127: page 1]
Parts List; STUDENT Nr.; DRAWN BY; CHECKED; UNITS IN; SHEET Nr.; SHEETS; R8.00 TYP; LN MATOTA; K SCHREVE

1 | 24989142-04-01-00 JOINT HOUSING BOTTOM LEFT | 1 | ALUMINIUM

UNLESS OTHERWISE STATED
TOLERANCES `0,1
ANGLES 1~

ITEM | DESCRIPTION | Qty. | MATERIAL / SPECIFICATIONS

STELLENBOSCH UNIVERSITY | SCALE ON A 3 = 1:2 | TITLE: JOINT HOUSING BOTTOM LEFT
