LenaMatota/MechatronicsProject478/Building the joint/Joint Assembly/Drawings/24989142-04-02-00-00 joint housing bottom back.pdf

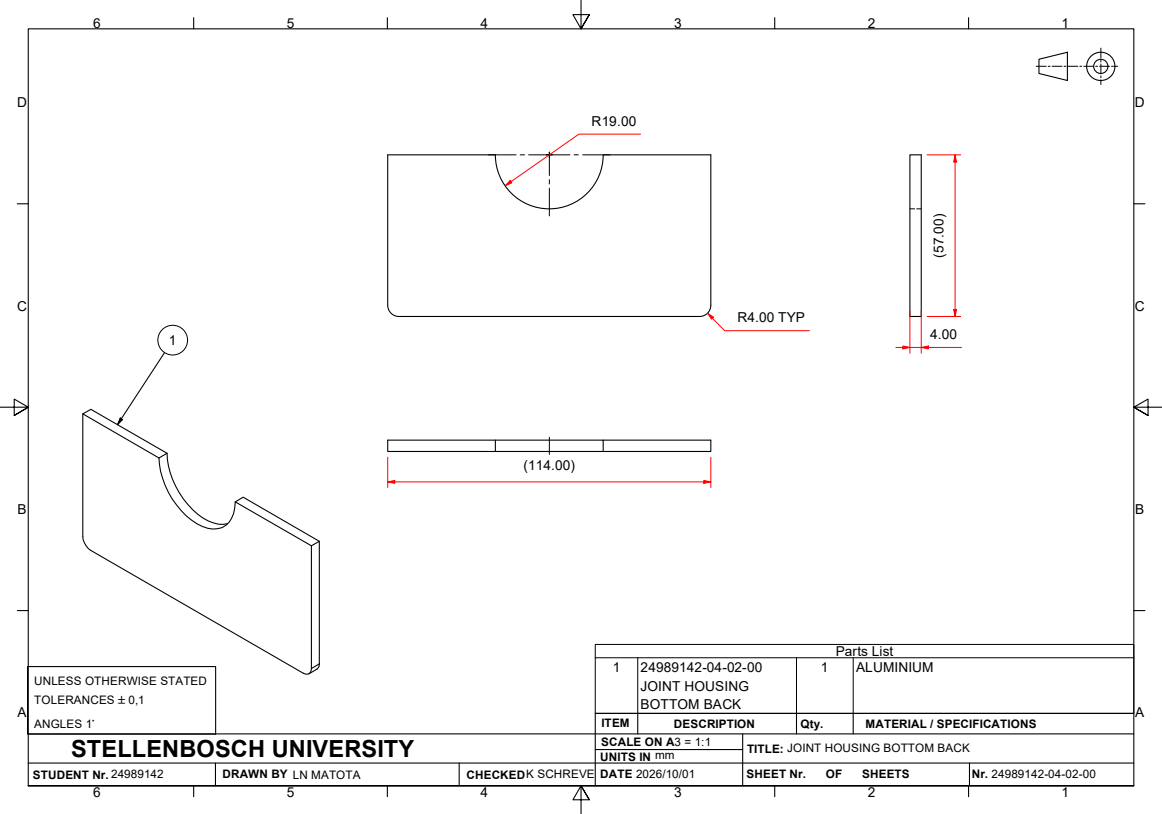
[picture p128: page 1]
Parts List; STUDENT Nr.; DRAWN BY; CHECKED; UNITS IN; SHEET Nr.; SHEETS; R4.00 TYP; LN MATOTA; K SCHREVE

1 | 24989142-04-02-00 JOINT HOUSING BOTTOM BACK | 1 | ALUMINIUM

UNLESS OTHERWISE STATED
TOLERANCES `0,1
ANGLES 1~

ITEM | DESCRIPTION | Qty. | MATERIAL / SPECIFICATIONS

STELLENBOSCH UNIVERSITY | SCALE ON A 3 = 1:1 | TITLE: JOINT HOUSING BOTTOM BACK
