LenaMatota/MechatronicsProject478/Building the joint/Joint Assembly/Drawings/24989142-05-00-00-00 joint housing top front.pdf

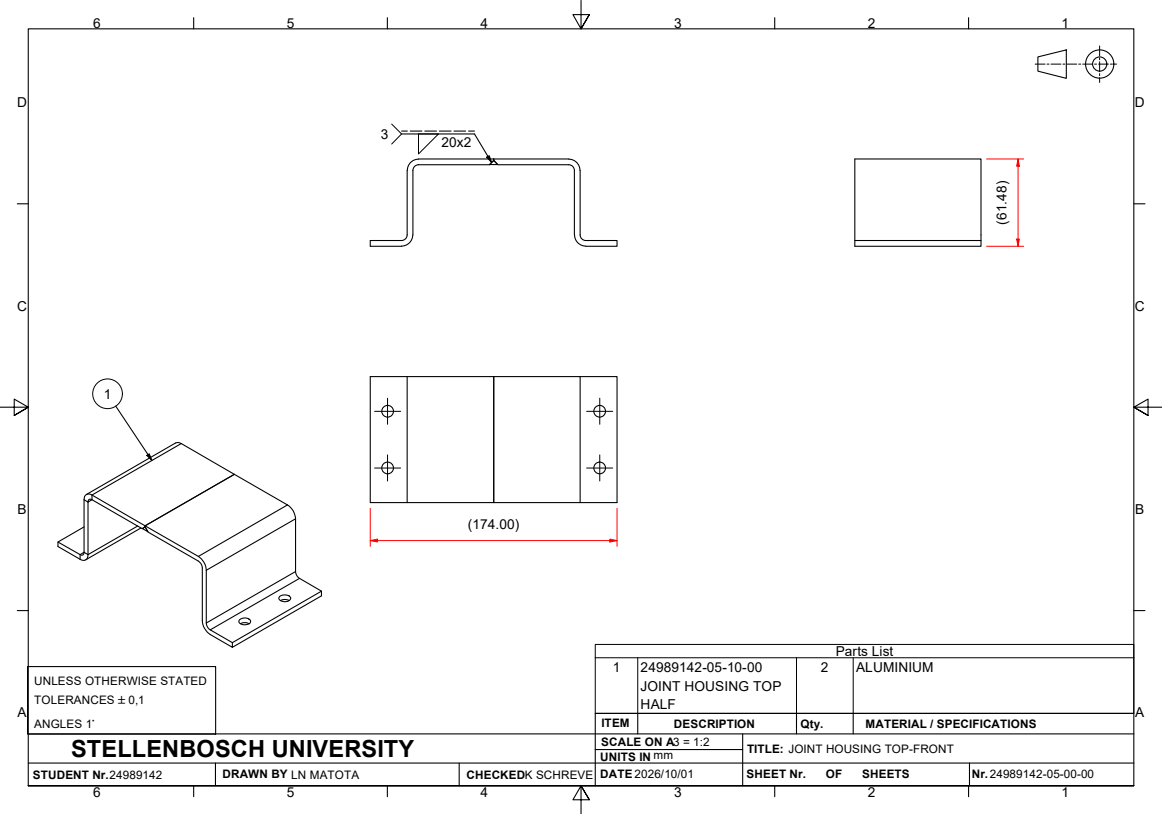
[picture p129: page 1]
Parts List; STUDENT Nr.; DRAWN BY; CHECKED; UNITS IN; SHEET Nr.; SHEETS; LN MATOTA; K SCHREVE

1 | 24989142-05-10-00 JOINT HOUSING TOP HALF | 2 | ALUMINIUM

UNLESS OTHERWISE STATED
TOLERANCES `0,1
ANGLES 1~

ITEM | DESCRIPTION | Qty. | MATERIAL / SPECIFICATIONS

STELLENBOSCH UNIVERSITY | SCALE ON A 3 = 1:2 | TITLE: JOINT HOUSING TOP-FRONT
