LenaMatota/MechatronicsProject478/Building the joint/Joint Assembly/Drawings/24989142-05-01-00-00 joint housing top front half.pdf

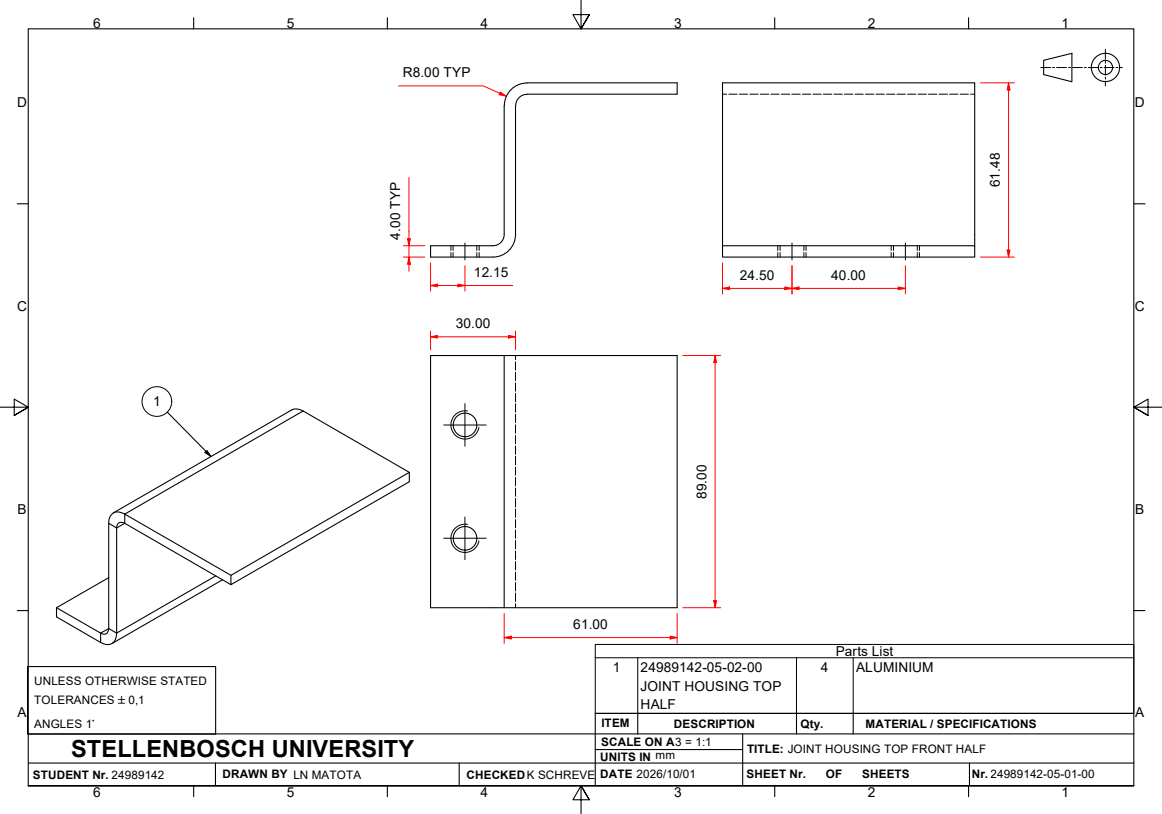
[picture p130: page 1]
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

1 | 24989142-05-02-00 JOINT HOUSING TOP HALF | 4 | ALUMINIUM

UNLESS OTHERWISE STATED
TOLERANCES `0,1
ANGLES 1~

ITEM | DESCRIPTION | Qty. | MATERIAL / SPECIFICATIONS

STELLENBOSCH UNIVERSITY | SCALE ON A 3 = 1:1 | TITLE: JOINT HOUSING TOP FRONT HALF
