LenaMatota/MechatronicsProject478/Building the joint/Joint Assembly/Drawings/24989142-06-00-00-00 joint housing top back.pdf

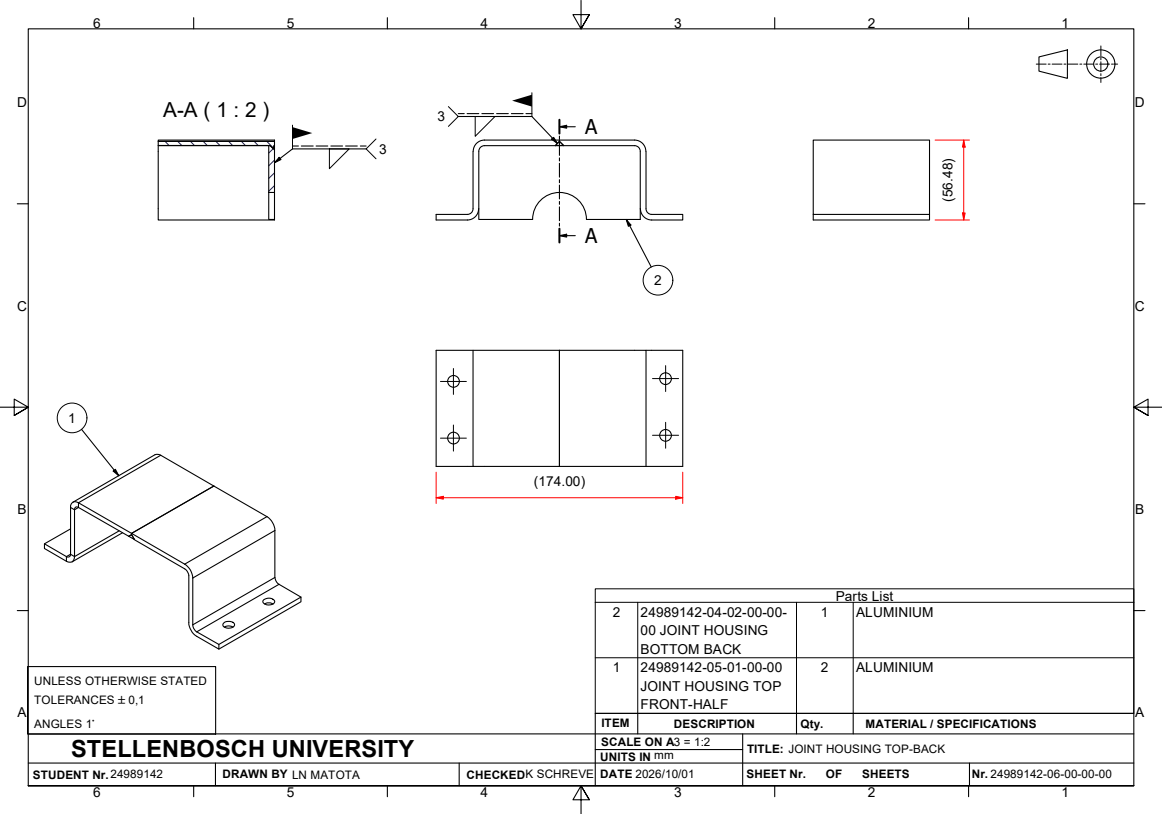
[picture p131: page 1]
Parts List; STUDENT Nr.; DRAWN BY; CHECKED; UNITS IN; SHEET Nr.; SHEETS; LN MATOTA; K SCHREVE

2 | 24989142-04-02-00-00-00 JOINT HOUSING BOTTOM BACK | 1 | ALUMINIUM

1 | 24989142-05-01-00-00 JOINT HOUSING TOP FRONT-HALF | 2 | ALUMINIUM

UNLESS OTHERWISE STATED
TOLERANCES `0,1
ANGLES 1~

ITEM | DESCRIPTION | Qty. | MATERIAL / SPECIFICATIONS

STELLENBOSCH UNIVERSITY | SCALE ON A 3 = 1:2 | TITLE: JOINT HOUSING TOP-BACK
