LenaMatota/MechatronicsProject478/Building the joint/Joint Assembly/Drawings/24989142-07-00-00-00 base link.pdf

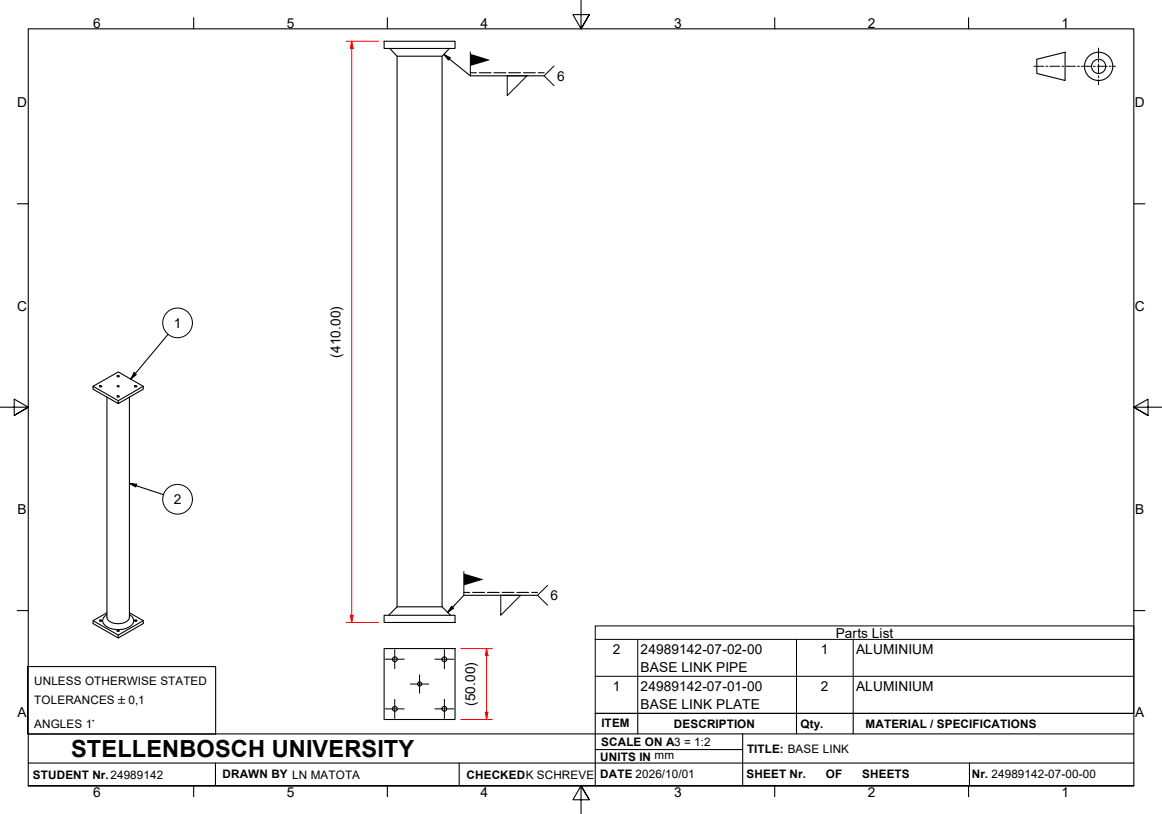
[picture p132: page 1]
Parts List; STUDENT Nr.; DRAWN BY; CHECKED; UNITS IN; SHEET Nr.; SHEETS; LN MATOTA; K SCHREVE

2 | 24989142-07-02-00 BASE LINK PIPE | 1 | ALUMINIUM

UNLESS OTHERWISE STATED
TOLERANCES `0,1
ANGLES 1~

1 | 24989142-07-01-00 BASE LINK PLATE | 2 | ALUMINIUM

ITEM | DESCRIPTION | Qty. | MATERIAL / SPECIFICATIONS

STELLENBOSCH UNIVERSITY | SCALE ON A 3 = 1:2 | TITLE: BASE LINK
