LenaMatota/MechatronicsProject478/Building the joint/Electromagnetism notes .pdf

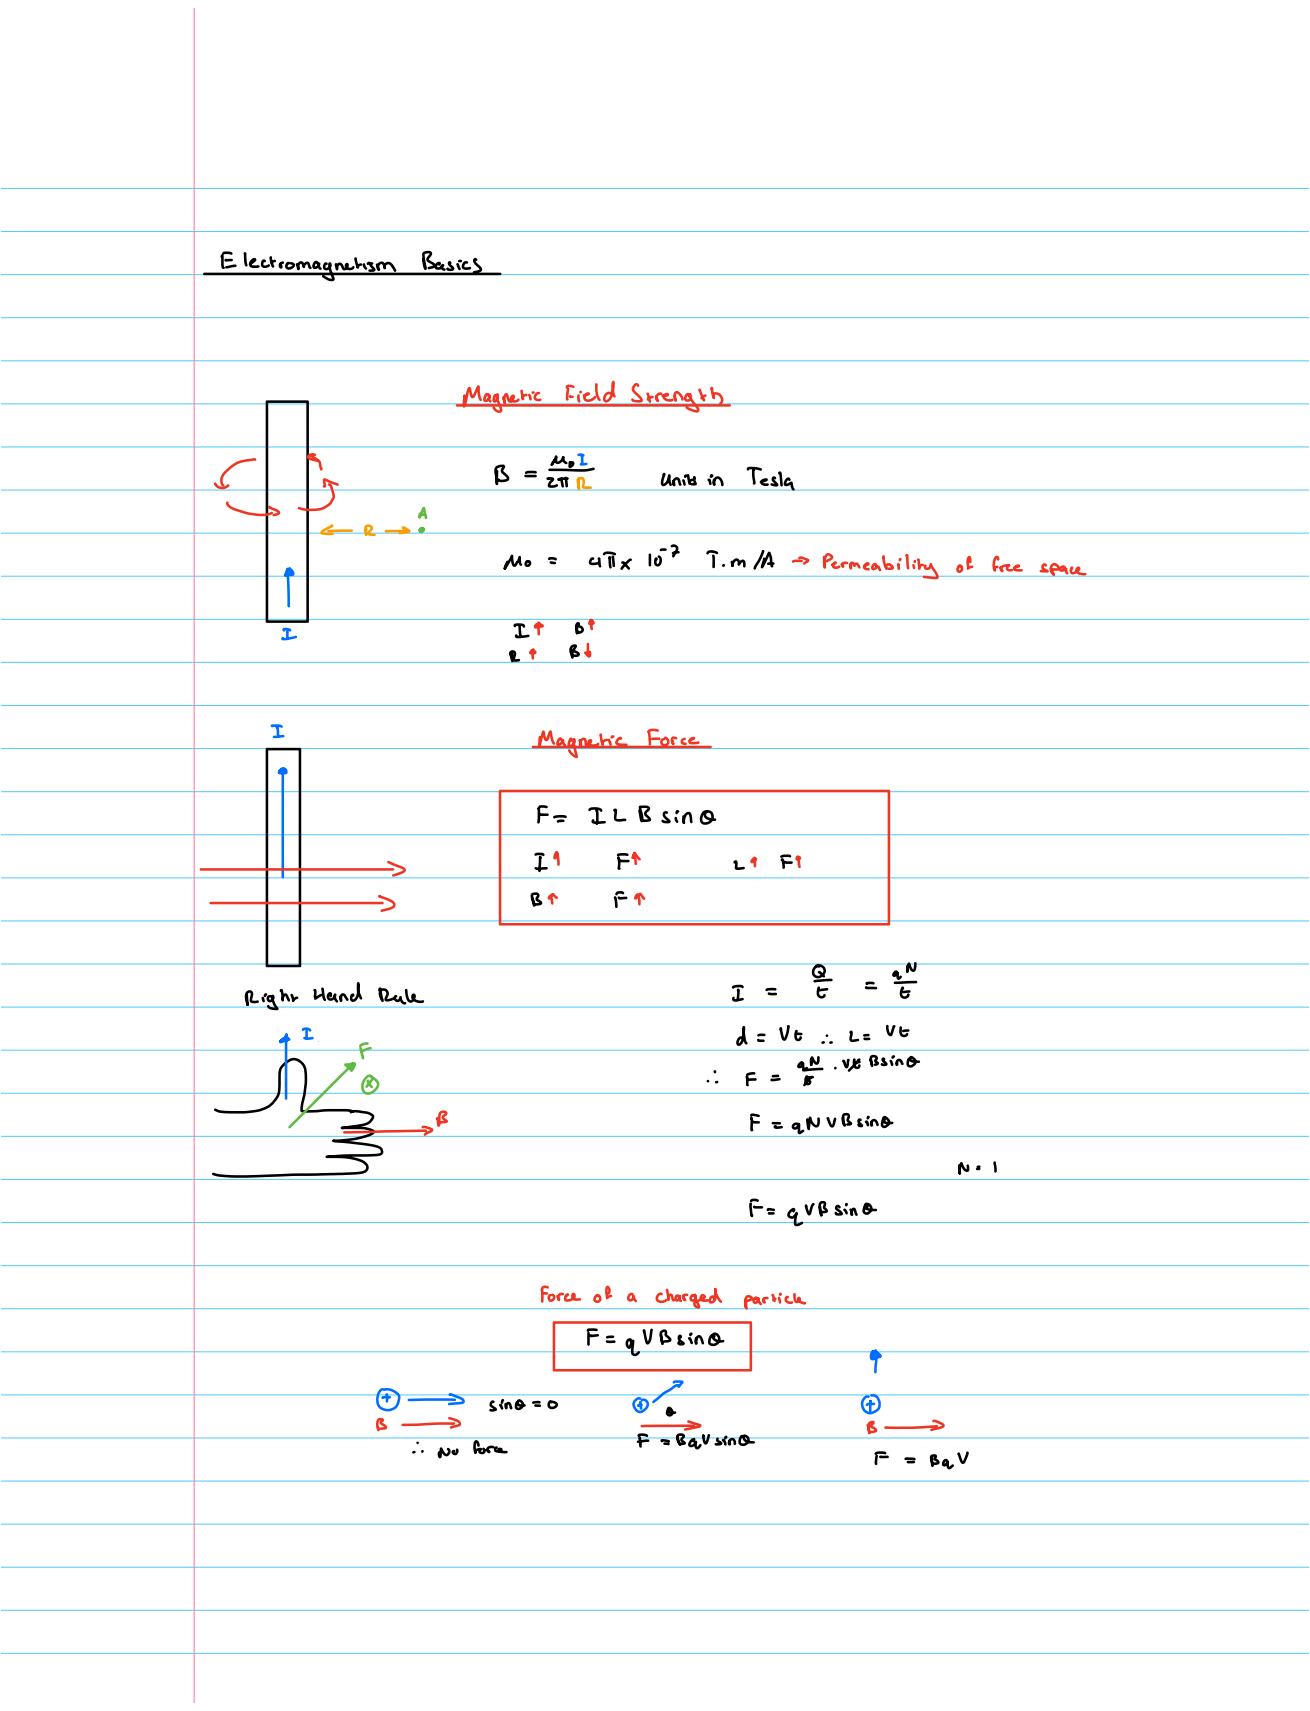
[picture p133: page 1]

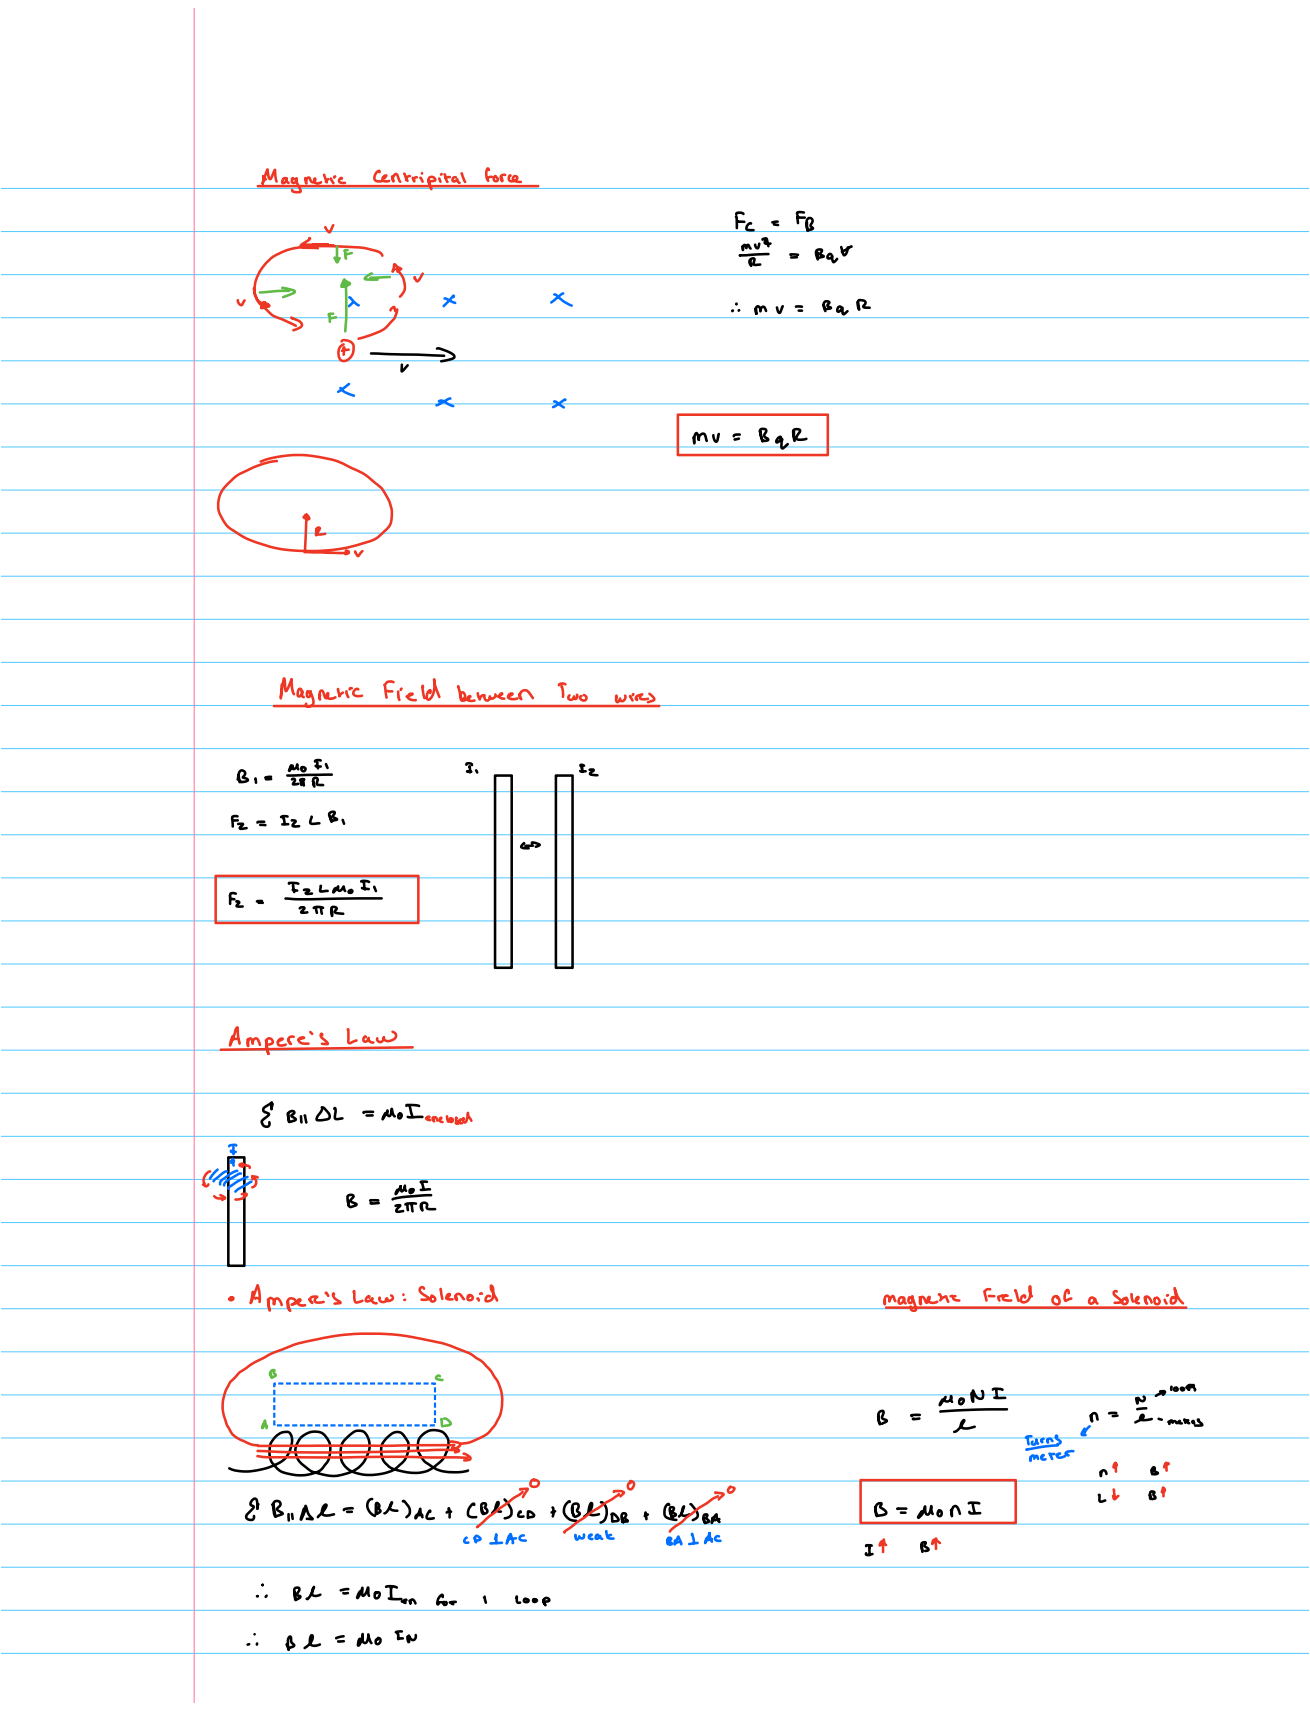
[picture p134: page 2]

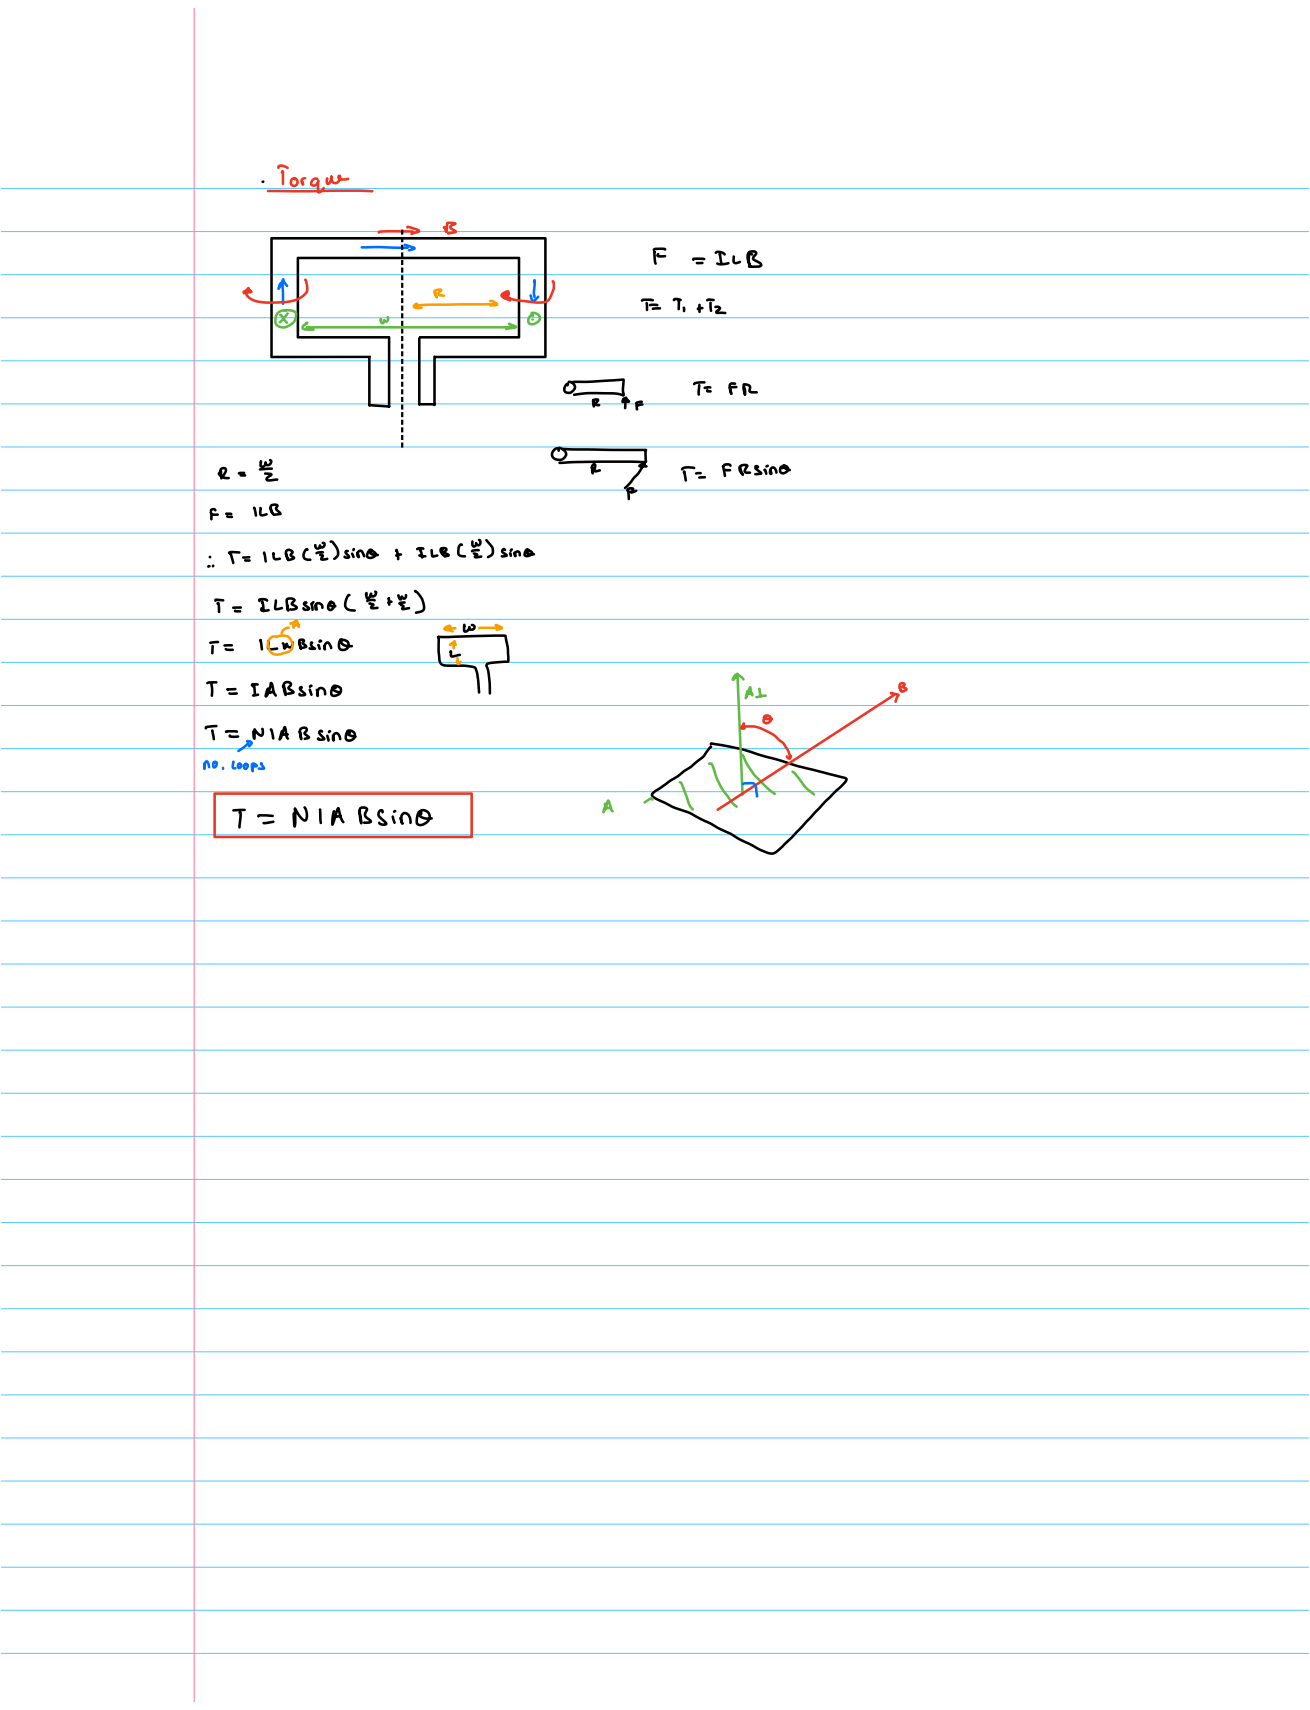
[picture p135: page 3]

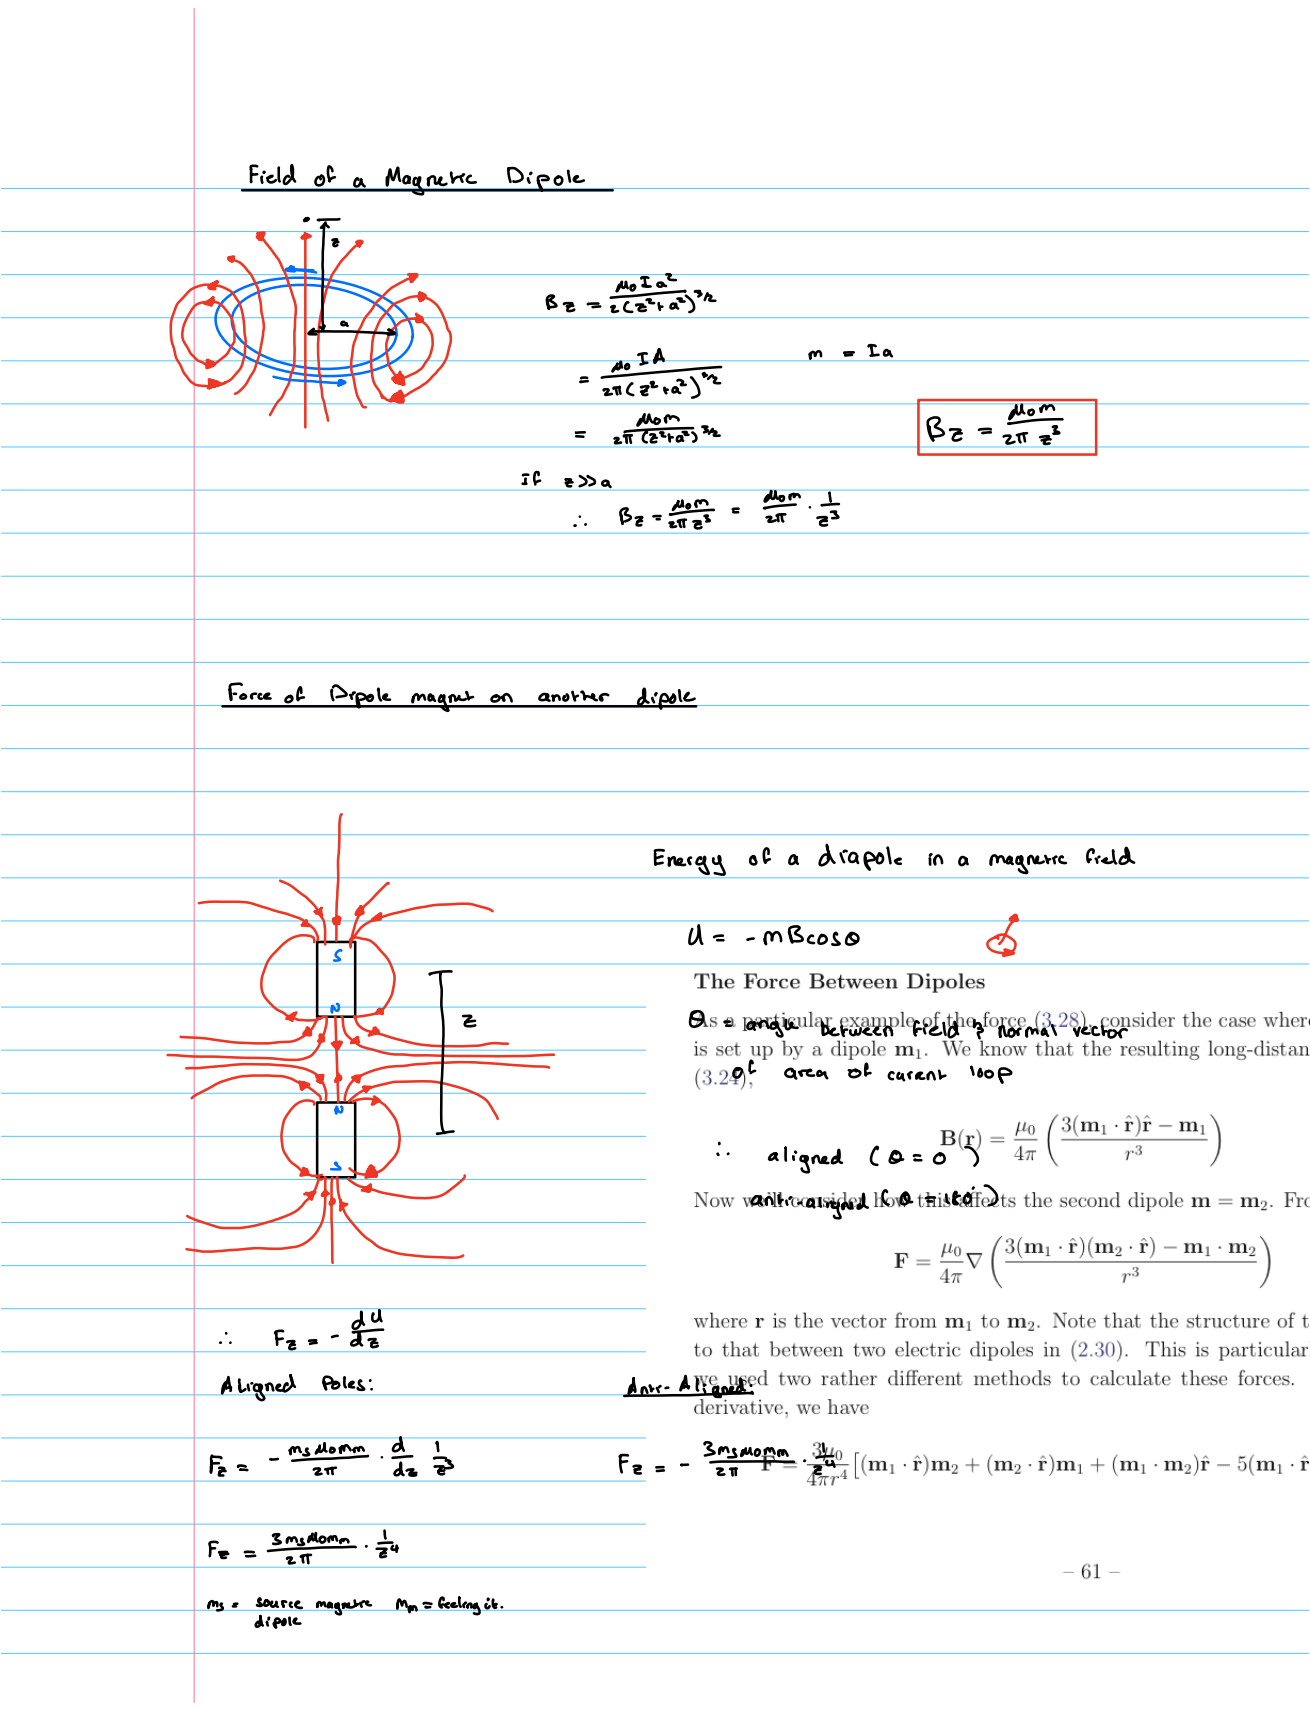
[picture p136: page 4]

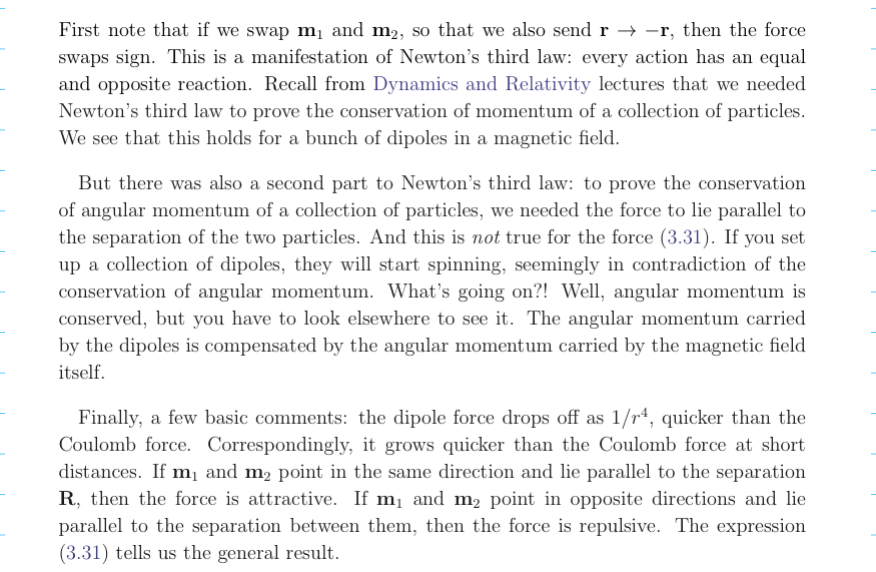
[picture p137: figure]
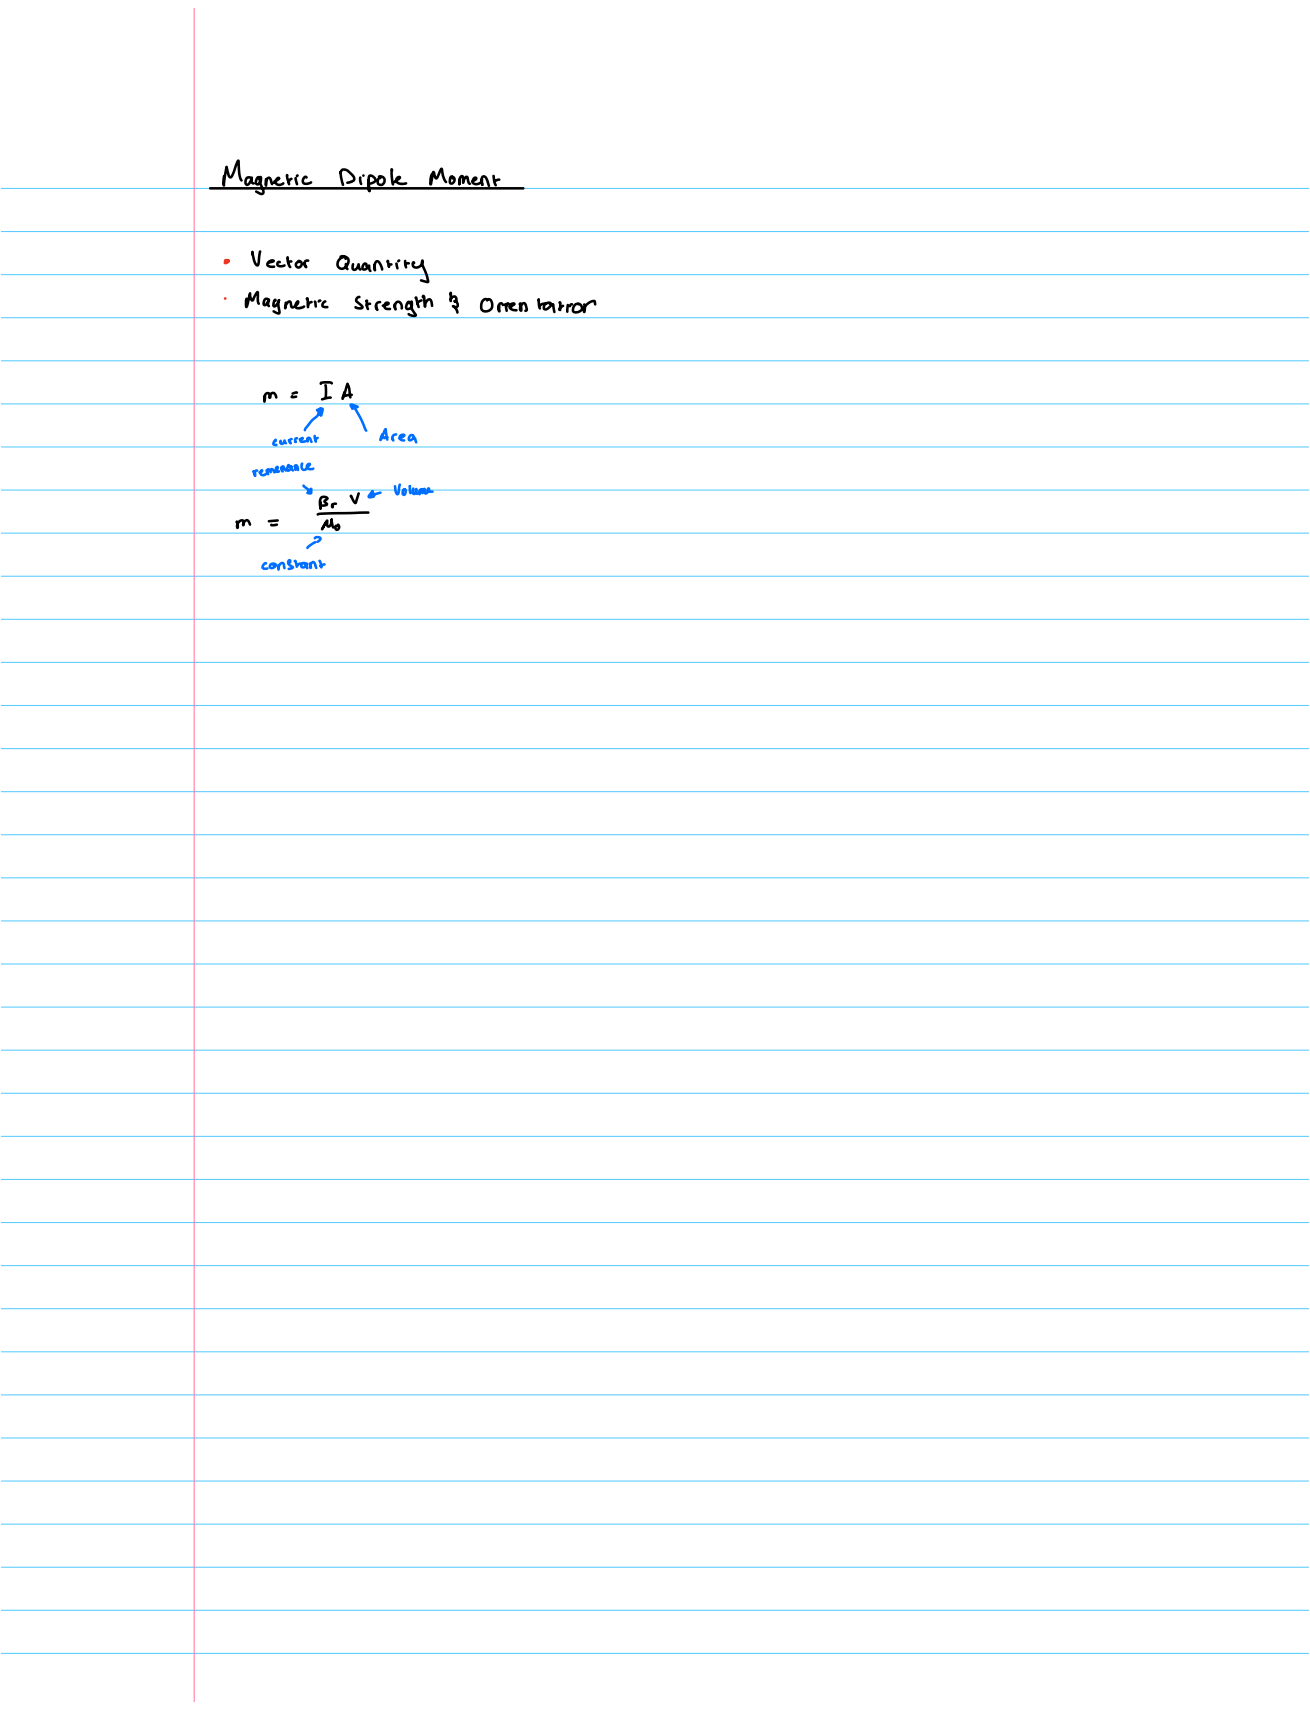
[picture p138: page 6]

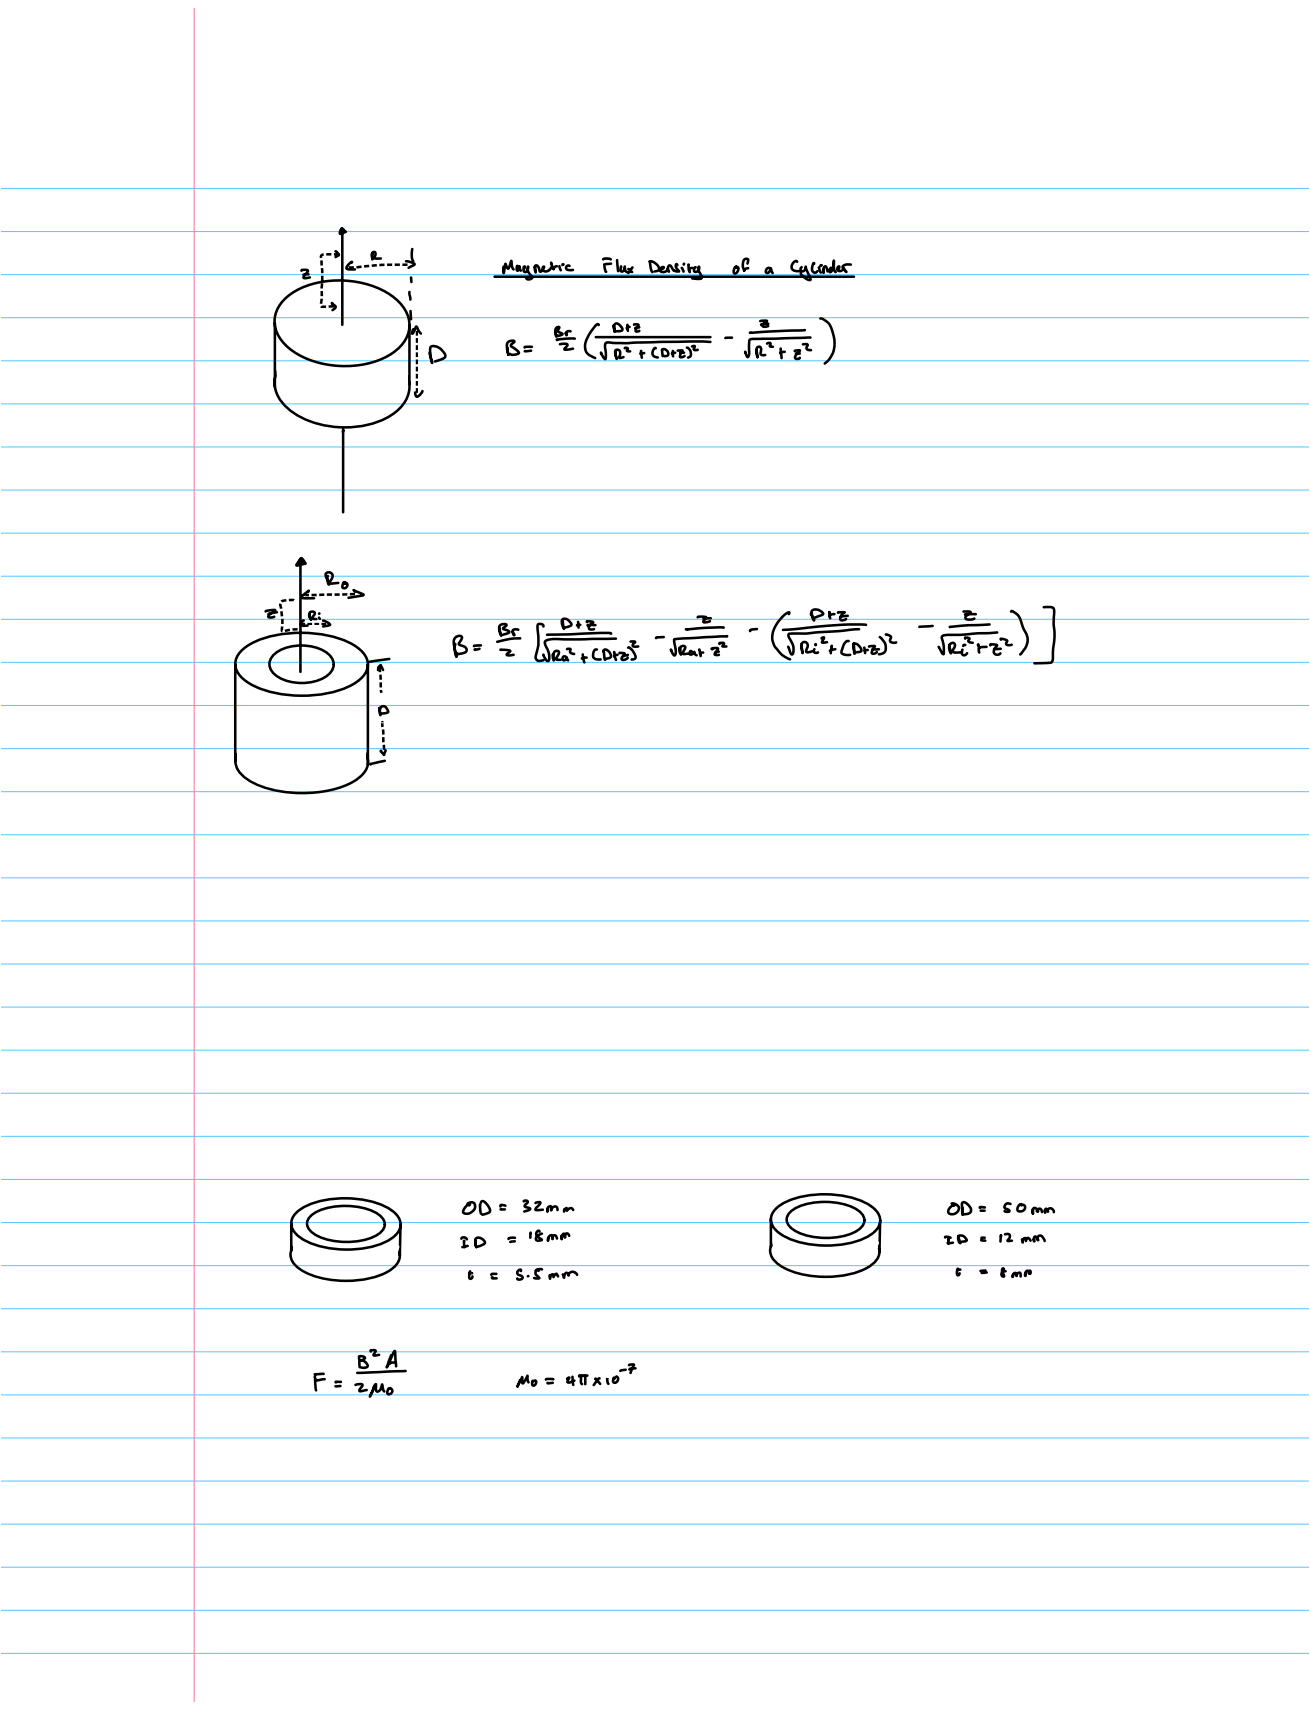
[picture p139: page 7]

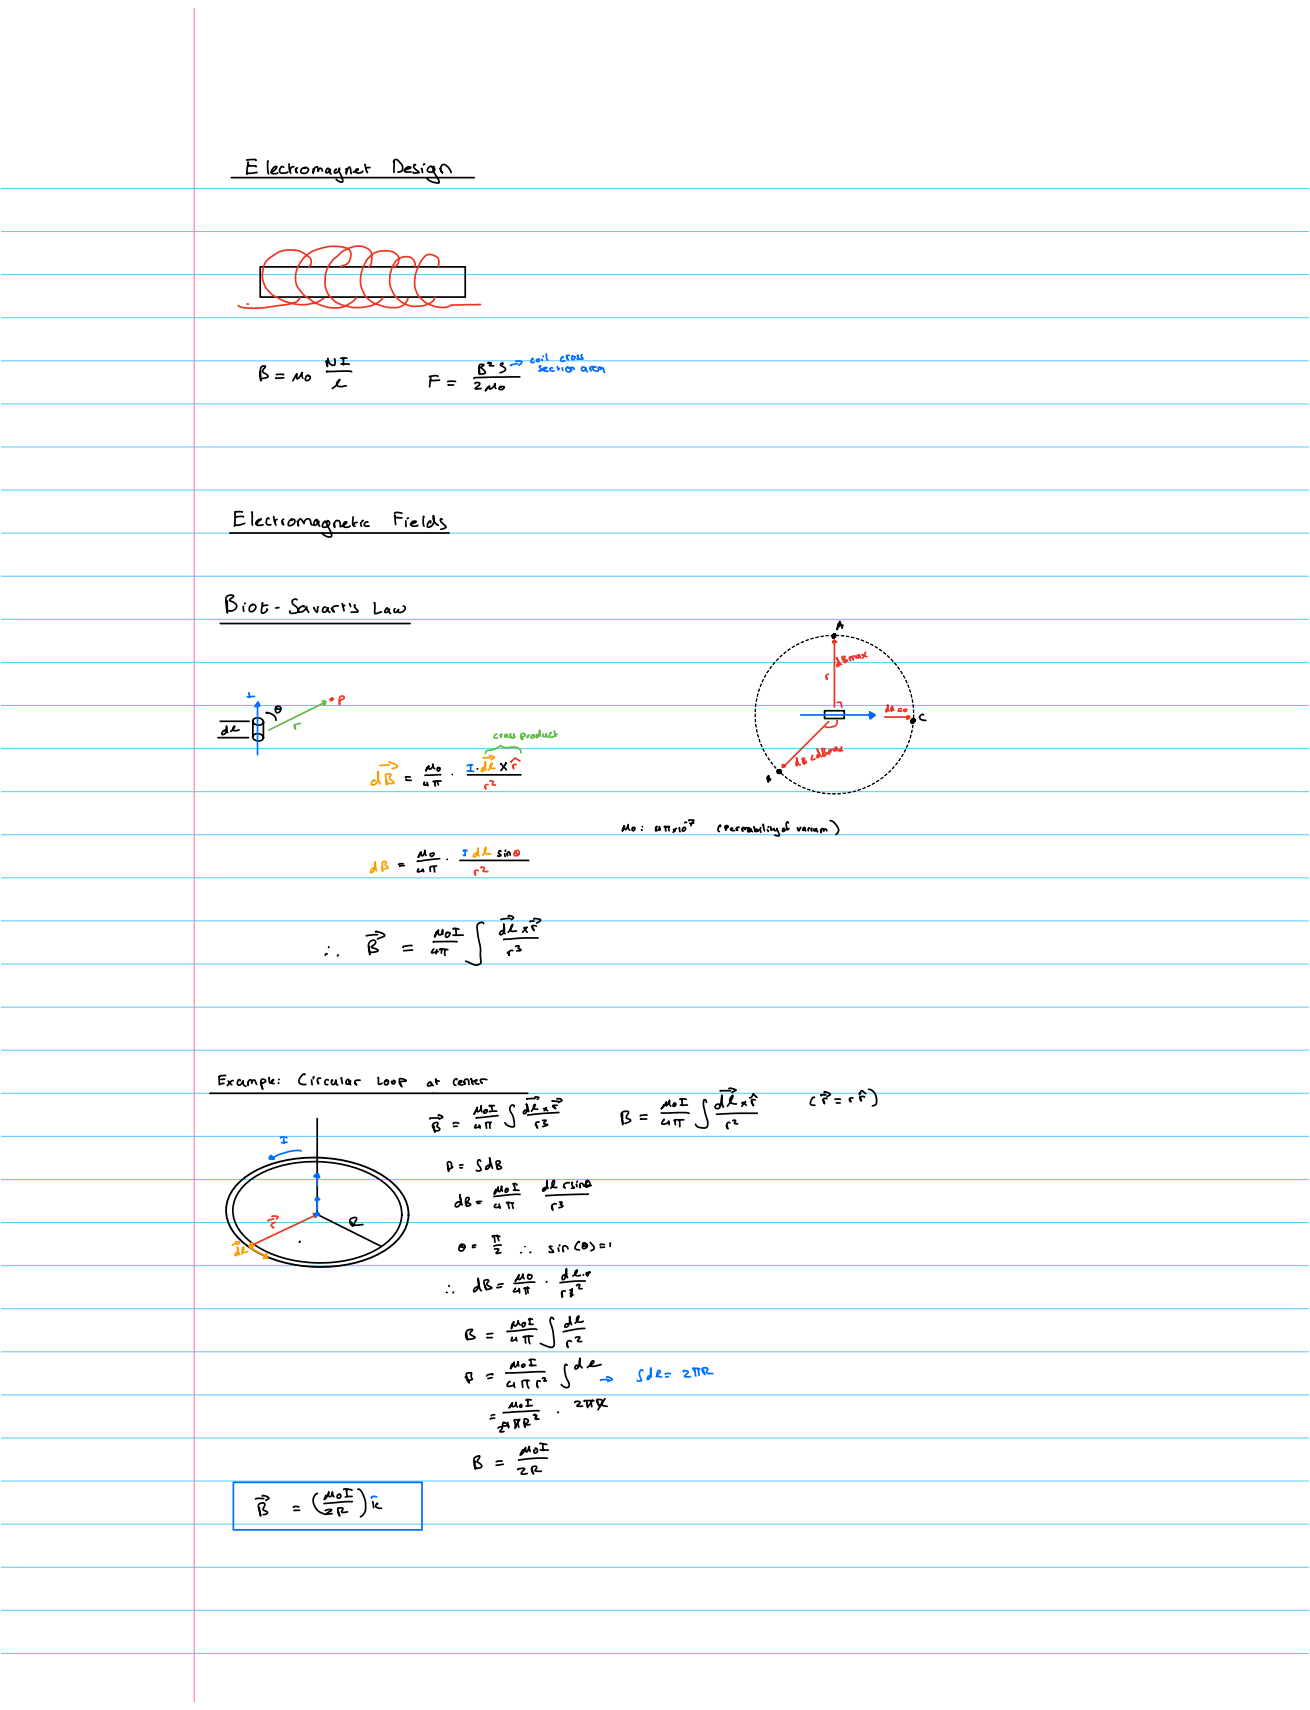
[picture p140: page 8]

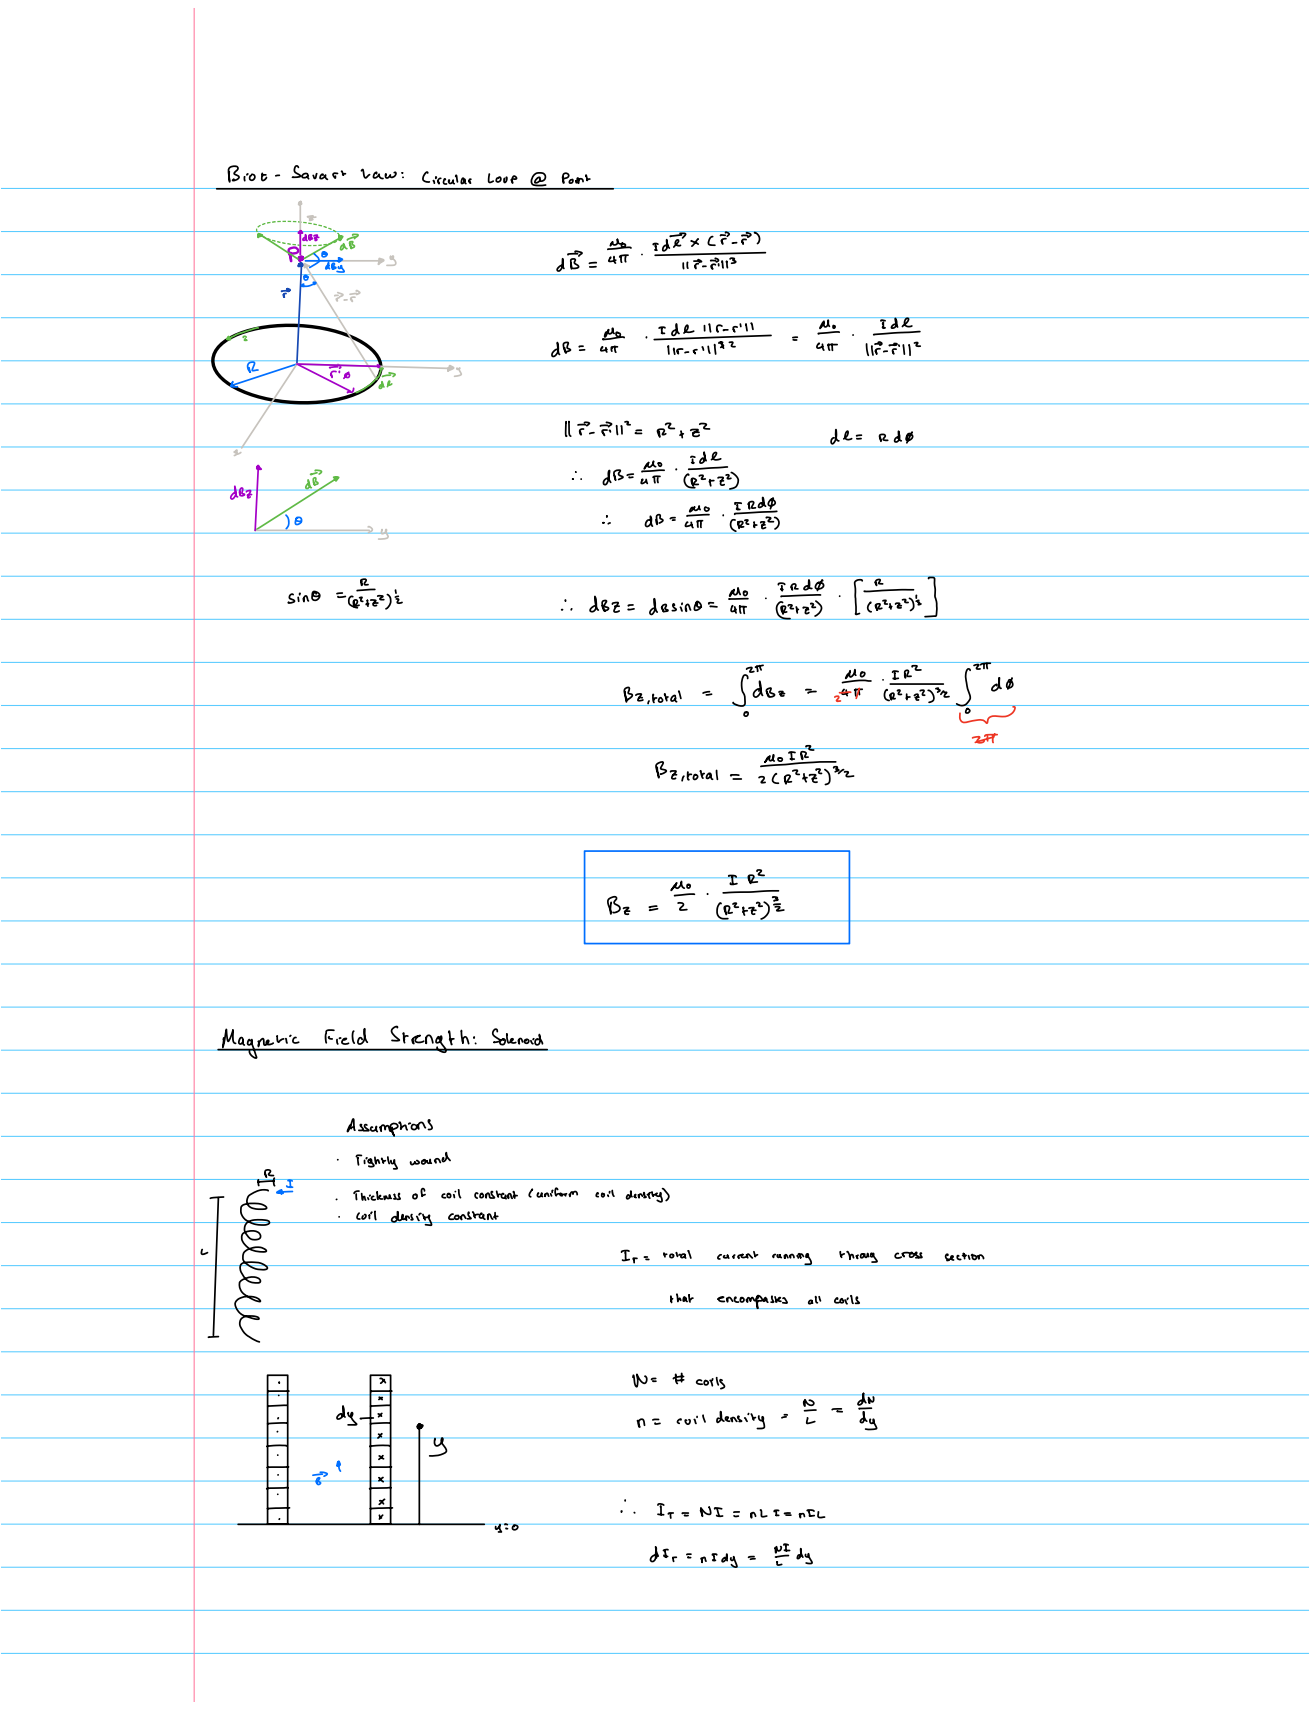
[picture p141: page 9]

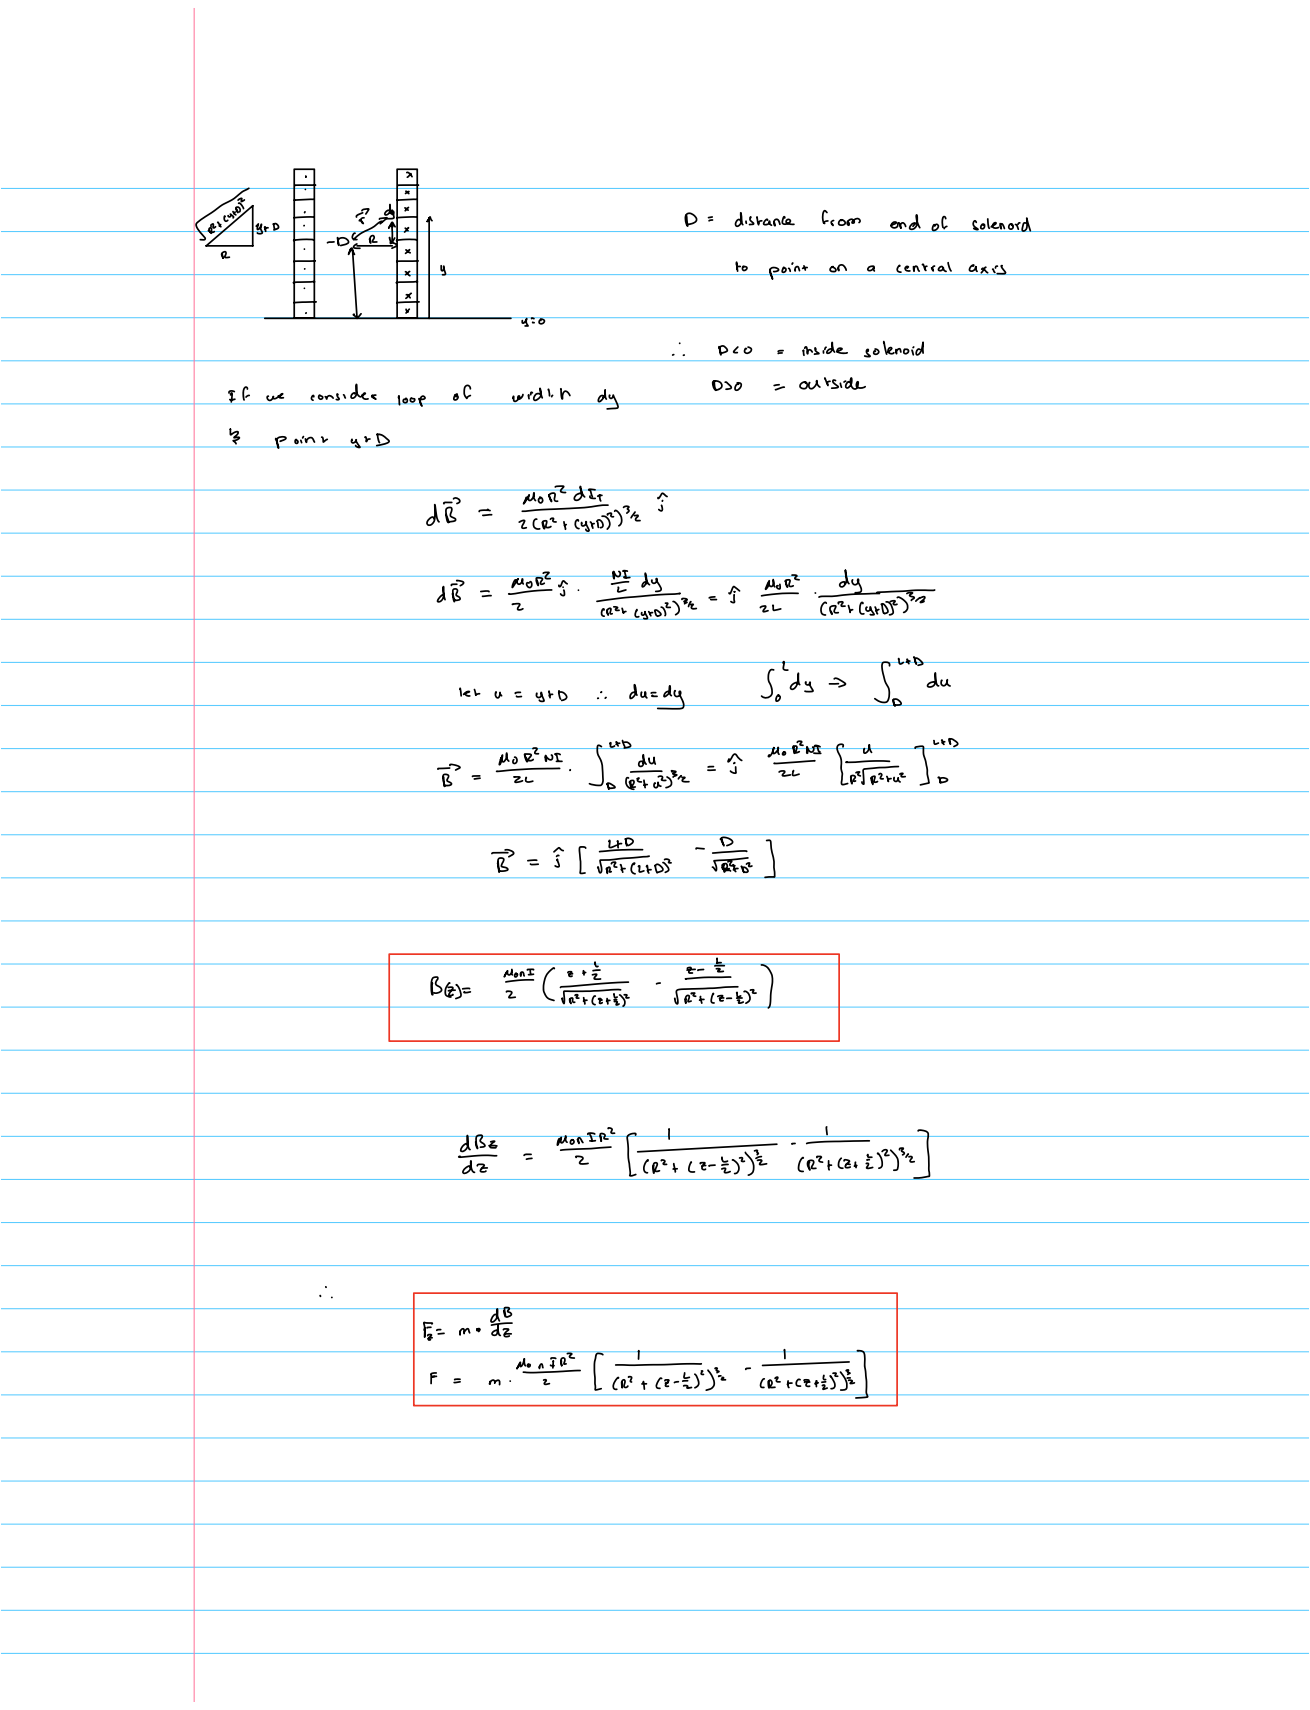
[picture p142: page 10]

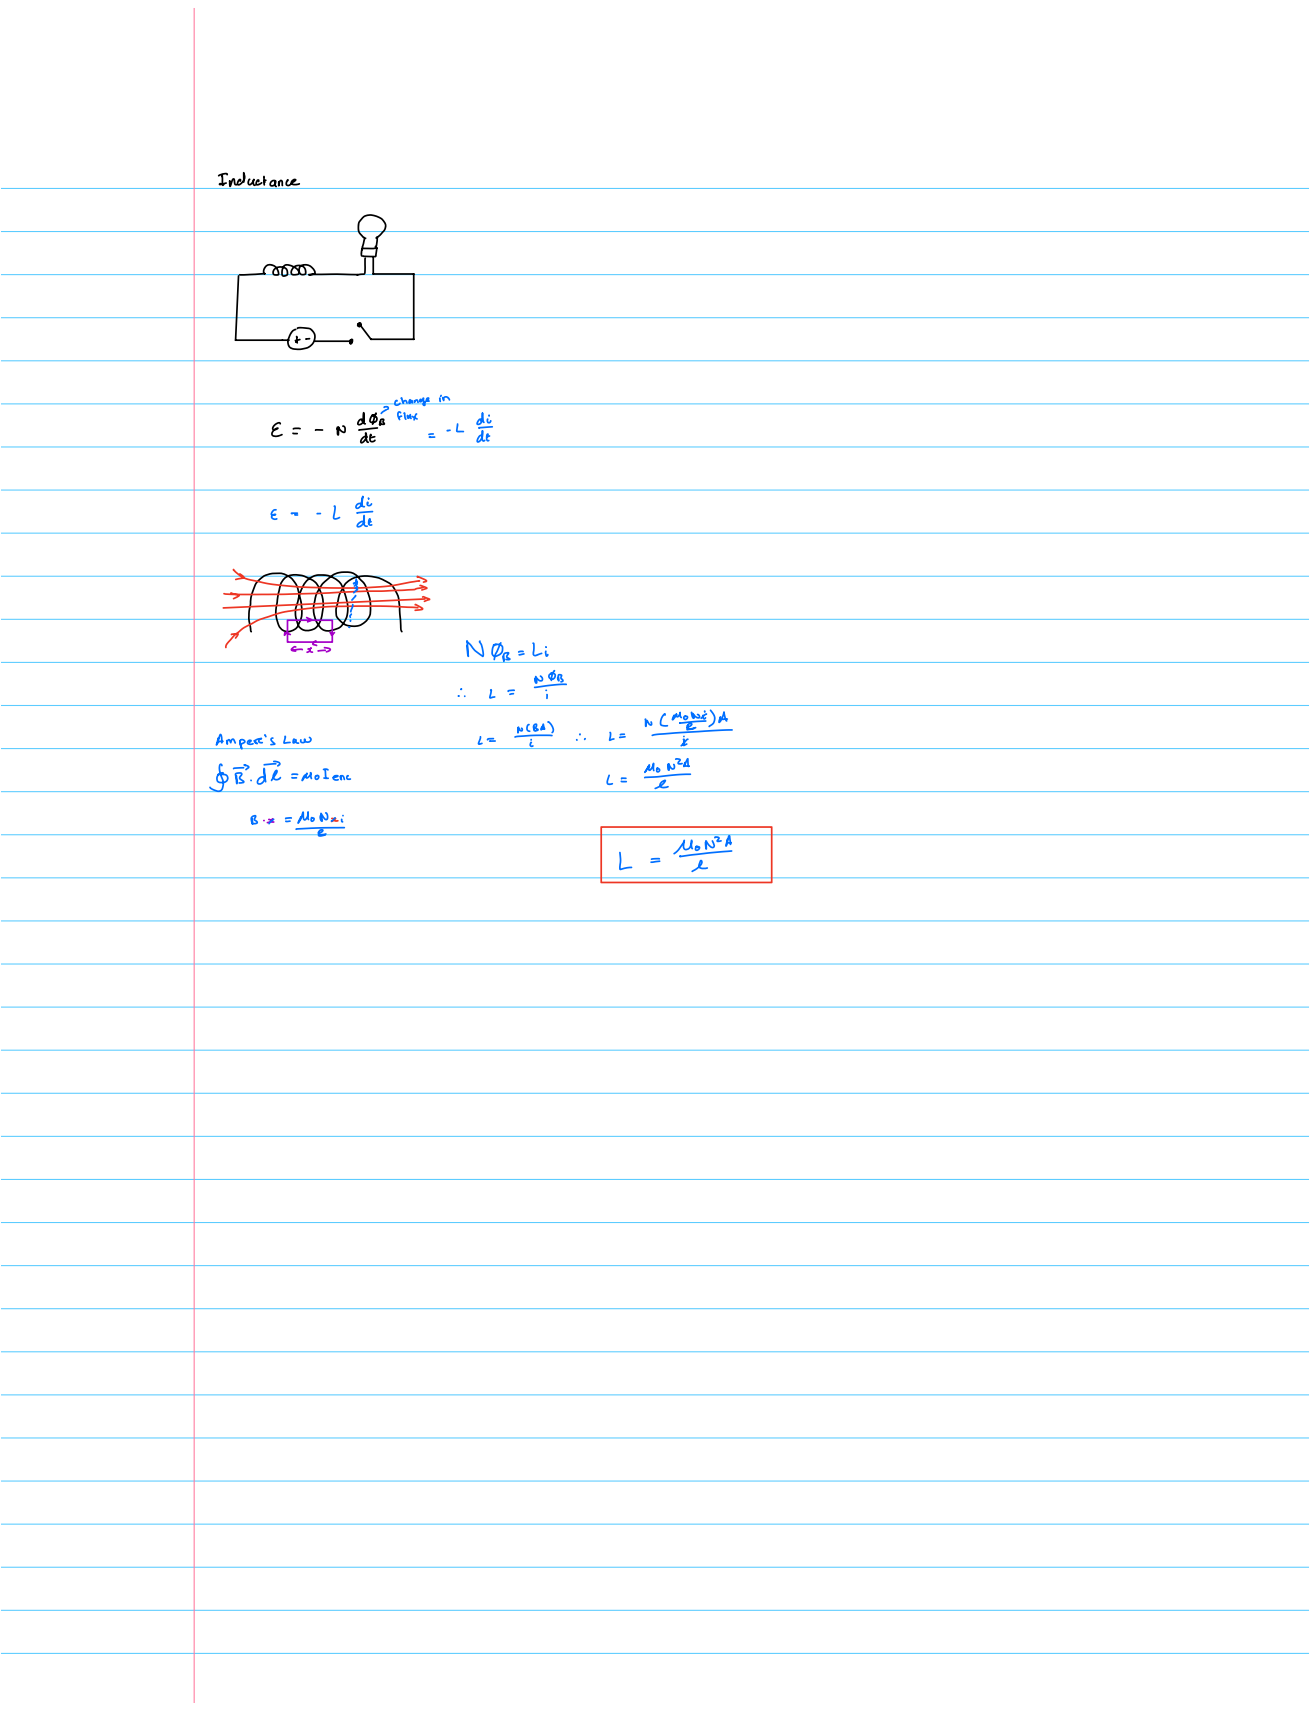
[picture p143: page 11]
