LenaMatota/MechatronicsProject478/Datasheets for components/Spice component models/Skripsie Spice model.asc

D1: diode; 1N4007
L1: ind; 1.202m
Q1: npn; 2N3904
R1: res; 1k
R2: res; 10k
R3: res; 6.25
V1: voltage; 3.3
V2: voltage; 6V
X1: npn; TIP41C
Named nets: 0
.tran 30ms
* TIP41C NPN Power Transistor Subcircuit Model
.subckt TIP41C C B E
* Connections: Collector, Base, Emitter
Q1 C_int B_int E internal_npn
RC C C_int 0.05
RB B B_int 1.0
.model internal_npn NPN (
+ IS = 1.2e-12
+ BF = 75
+ VAF = 60
+ IKF = 3.0
+ ISE = 1.2e-11
+ NE = 2.0
+ RE = 0.05
+ RC = 0.02
+ CJC = 120p
+ CJE = 400p
+ TR = 1u
+ TF = 50n)
.ends TIP41C
