LenaMatota/MechatronicsProject478/(commit log)

2026-04-14 The first ever Push: Working on Concept design now
    [List of Equipment Available in Mechanical & Mechatronic Engineering Store 2026.xlsx, List of material in store-2026.xlsx, Stellenbosch A3 English.idw, Stellenbosch A3.idw, Stellenbosch A4 English.idw, Stellenbosch A4.idw]
2026-04-21 D-H model was derived. You must interpret results and derive TPMs. Once that is done, start CADing the joint.
2026-04-21 Powerpoint slides saved. From now on, work on slides on Sunday and have them ready by Monday.
2026-05-05 DH model updated
    [FARO-Arm-kpl.IGS, FARO-arm.stl]
2026-05-21 Adding new sources and deriving TPMs
    [All active - Domestic suppliers.xlsx, FARO-Arm-kpl.IGS, FARO-arm.stl]
2026-05-25 Designing bearings and starting CAD tomorrow.
    [All active - Domestic suppliers.xlsx]
2026-05-26 Joint components have started being collected. Shaft, output links, link interfaces must be designed. Reduced bushing, circlips, and probe must still be found.
    [All active - Domestic suppliers.xlsx, E60063.0001.ipt, E60063.0002.ipt, E60063.ipt, Optical Encoder.0001.ipt, Optical Encoder.ipt, hpc_Q2307-ACC.0001.iam, hpc_Q2307-ACC.iam]
2026-07-08 It's been a minute. Workshop procedures have been added. Refingin design and starting safety report after gym TONIGHT.
    [2200 Ball.ipt, 2200 Inner Ring.ipt, 2200 Outer Ring.ipt, All active - Domestic suppliers.xlsx, NSK_2200.iam, Reducer bushing.ipt, hpc_Q2307-ACC.iam, hpc_Q2307-ACC_1.ipt]
2026-07-16 Finished sizing the electromagnet. Time to refine brake design.
2026-07-23 Working on report. Following Conecpt design from Mechatronics 434
    [2058786.0001.iam, 2058786.iam, 2058786_01.ipt, 2058786_02.ipt, 2058786_03.ipt, 2058786_04.ipt, 2058786_05.ipt, 2058786_06.ipt]
2026-07-23 Designing the bearing housing. Drawings must be ready by 12:00 tomorrow to show Mr. Zietsman.
    [8236976.0001.ipt, 8236976.ipt, Joint Assembly.0001.iam, Joint Assembly.iam]
2026-07-24 CAD is half way done. Bearing housing must be designed and joint housing and base link must be designed.
    [Joint Assembly.0001.iam, Joint Assembly.0003.iam, Joint Assembly.iam, Output Link.0003.iam, Output Link.iam, Output link body.0001.ipt, Output link body.ipt, Output link probe hub.0001.ipt]
2026-07-25 New sections were added to the report. Working on concept development, detail design and the drawing, wiring and bill of materials.
    [Joint Assembly.0003.iam, Joint Assembly.0004.iam, Joint Assembly.iam]
2026-07-25 Concept development is almost halfway done. At the evaluation stage
2026-07-27 Progress report was submitted. CAD was almost done, concept design section was almot done. Project schedule needs to be done, preferaby on MS project, most likely on excel. drawings need to be done b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
    [Bearing housing bottom.0003.ipt, Bearing housing bottom.ipt, Bearing housing top.ipt, Electromagnet cover.0002.ipt, Electromagnet cover.0006.ipt, Electromagnet cover.ipt, Joint Assembly.0004.iam, Joint Assembly.0009.iam]
2026-07-28 Finally finshed CAD design. Might need to add fasteners. Will check with Prof Schreve. Adding them just in case though. Start and finish drawings tonight, after gym. Continue with documentation and g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
    [Base link.0001.iam, Base link.iam, Bottom link body.ipt, Bottom link plate.0002.ipt, Bottom link plate.ipt, Electromagnet cover.0006.ipt, Electromagnet cover.0007.ipt, Electromagnet cover.ipt]
2026-07-29 Joint design was finally complete. Meeting with Prof Schreve today to discuss teh design in further detail and make improvements before drawings.
    [8236967.ipt, 8236976.ipt, Electromagnet.0001.iam, Electromagnet.0002.iam, Electromagnet.iam, Joint Assembly.0014.iam, Joint Assembly.0015.iam, Joint Assembly.iam]
2026-08-02 Redesigning joint design. And prepping for presentation.
    [8236967.0001.ipt, 8236967.ipt, Final joint shaft.0001.ipt, Final joint shaft.ipt, Joint Assembly.0015.iam, Joint Assembly.0020.iam, Joint Assembly.iam, Optical Encoder.0003.ipt]
2026-08-04 Redeigning stil ongoing. Hopefully, we get eveything right and all the material is still in stock.
    [Electromagnet cover.0004.iam, Electromagnet cover.0007.ipt, Electromagnet cover.0008.ipt, Electromagnet cover.iam, Electromagnet final.0005.iam, Electromagnet final.iam, Electromagnet.0002.iam, Electromagnet.0007.iam]
2026-08-05 CAD redesign, finally complete. Showing Prof. Schreve tomorrow.
    [Base link.0001.iam, Base link.0002.iam, Base link.iam, Bearing housing bottom.0003.ipt, Bearing housing bottom.0004.ipt, Bearing housing bottom.ipt, Bottom joint housing 2R.0009.ipt, Bottom joint housing 2R.ipt]
2026-08-21 Introduction is updated, lit review started, ignore large CSV files
    [Bottom joint housing 2R.0009.ipt, Bottom joint housing 2R.0011.ipt, Bottom joint housing 2R.ipt, Bottom joint housing R.0015.ipt, Bottom joint housing R.0017.ipt, Bottom joint housing R.ipt, Brake disc-1.0003.idw, Complete back top housing.0002.iam]
2026-09-08 Safety report completed. I am now going to continue updating my final report.
    [24989142-01-01-01-02 Electromagnetic cover bottom.dxf, 24989142-01-02-00-00 Pressure platform.dxf, 24989142-01-03-00-00 Friction Plate.dxf, Electromagnetic cover bottom.0005.ipt, Electromagnetic cover bottom.0006.ipt, Electromagnetic cover bottom.ipt, Friction Plate.0006.ipt, Friction Plate.0007.ipt]
2026-09-21 LTSpice model is working. Electrical circuit is feasible.
2026-09-30 CAD drawings are being updated. Drawing pack must be recompiled.
    [Brake disc.0001.ipt, Brake disc.0002.ipt, Brake disc.ipt, Electromagnet cover.0009.iam, Electromagnet cover.0010.iam, Electromagnet cover.iam, Electromagnet cover_po.0002.iam, Electromagnet cover_po.0003.iam]
2026-10-01 Design section is in progress
    [24989142-01-00-00-00 joint shaft.idw, 24989142-02-00-00-00 bearing housing top.idw, Electromagnet cover_po.idw, Electromagnet final_key.idw, Electromagnetic cover body.idw, Electromagnetic cover bottom.idw, Electromanetic brake.idw, Friction Plate.idw]
2026-10-03 Mechanical and electronic design sections have been updated.
    [Electromagnet cover_po.0003.iam, Electromagnet cover_po.0004.iam, Electromagnet cover_po.iam, Electromagnet final.0018.iam, Electromagnet final.0019.iam, Electromagnet final.iam, Electromagnet final_key.0001.idw, Electromagnet final_key.0014.iam]
2026-10-03 Design evaluation and testing section has been updated.
    [24989142-02-00-00-00 bearing housing top.0001.idw, 24989142-02-00-00-00 bearing housing top.idw, 24989142-03-00-00-00 bearing housing bottom.idw, Electromagnet cover.0010.iam, Electromagnet cover.0011.iam, Electromagnet cover.iam, Electromagnet cover_po.0004.iam, Electromagnet cover_po.0005.iam]
2026-10-04 Drawing pack currently being updating
    [24989142-01-00-00-00 joint shaft.0002.idw, 24989142-01-00-00-00 joint shaft.idw, 24989142-02-00-00-00 bearing housing top.0001.idw, 24989142-02-00-00-00 bearing housing top.0003.idw, 24989142-02-00-00-00 bearing housing top.idw, 24989142-03-00-00-00 bearing housing bottom.0002.idw, 24989142-03-00-00-00 bearing housing bottom.idw, 24989142-04-00-00-00 joint housing bottom.0003.idw]
2026-10-04 Drawing pack completey updated. Literature review update in progress.
    [24989142-10-00-00-00 electromagnet.0001.idw, 24989142-10-00-00-00 electromagnet.0003.idw, 24989142-10-00-00-00 electromagnet.idw, 24989142-10-04-01-00 electromagnet cover body.idw, 24989142-10-04-02-00 electromagnet cover bottom.idw, 24989142-11-00-00-00 pressure tab.idw, Electromagnet final_key.0017.iam, Electromagnet final_key.0019.iam]
2026-10-05 Literature review is what it is. Calculations are surrently being update. Hand-in just might be at 16:30.
    [24989142-10-00-00-00 electromagnet.0003.idw, 24989142-10-00-00-00 electromagnet.0004.idw, 24989142-10-00-00-00 electromagnet.idw, 24989142-10-01-00-00 solenoid yoke.0001.idw, 24989142-10-01-00-00 solenoid yoke.0002.idw, 24989142-10-01-00-00 solenoid yoke.idw, Electromagnet final_key.0019.iam, Electromagnet final_key.0020.iam]
2026-10-11 ECSA section currently being updated.
