LenaMatota/MechatronicsProject478/Lena's skripsie vlog/20260929_143731.jpg

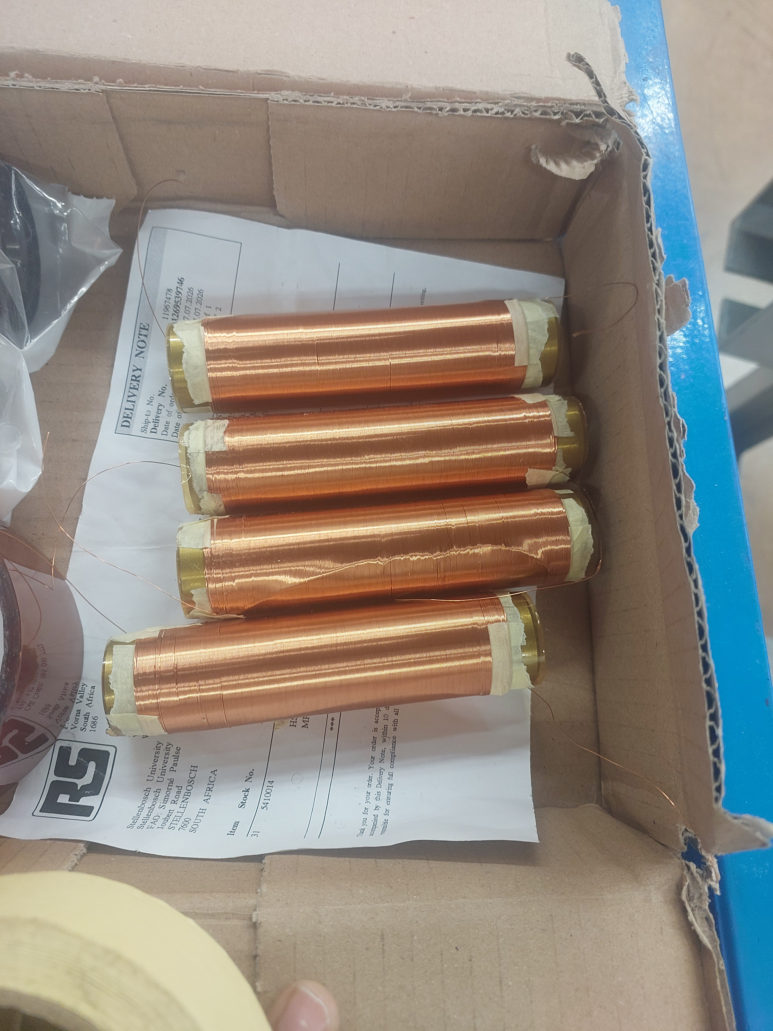
Lena's skripsie vlog/20260929_143731.jpg
