LenaMatota/MechatronicsProject478/Lena's skripsie vlog/20261001_123830.jpg

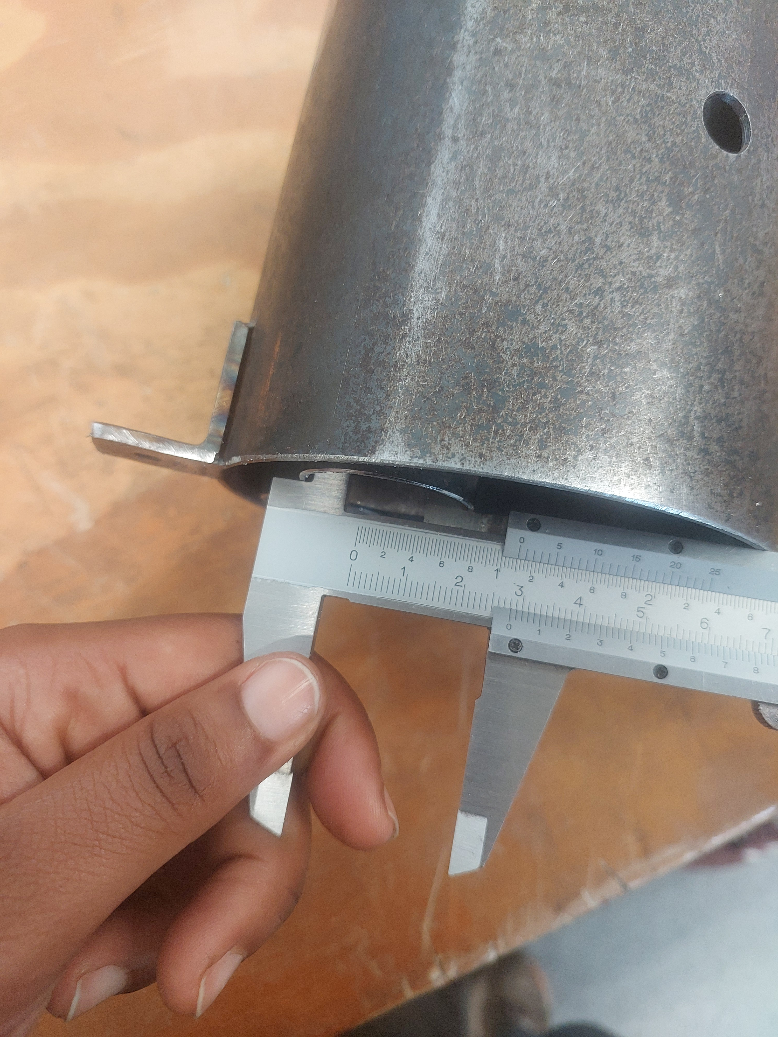
Lena's skripsie vlog/20261001_123830.jpg
