LenaMatota/MechatronicsProject478/Lena's skripsie vlog/20261001_123831.jpg

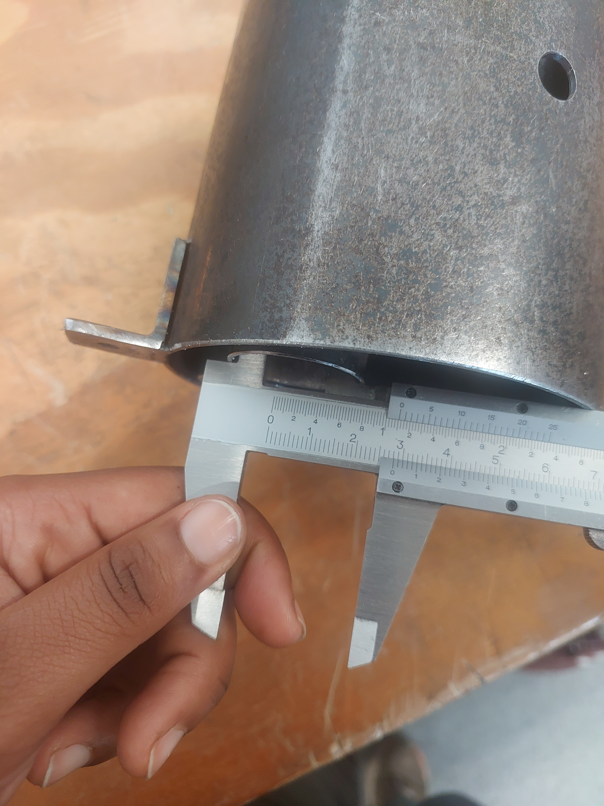
Lena's skripsie vlog/20261001_123831.jpg
