LenaMatota/MechatronicsProject478/Lena's skripsie vlog/IMG-20260923-WA0014.jpeg

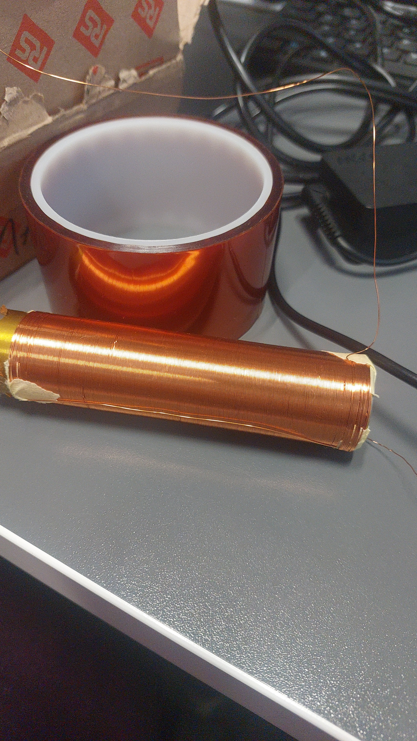
Lena's skripsie vlog/IMG-20260923-WA0014.jpeg
