LenaMatota/MechatronicsProject478/Lena's skripsie vlog/IMG-20260926-WA0049.jpeg

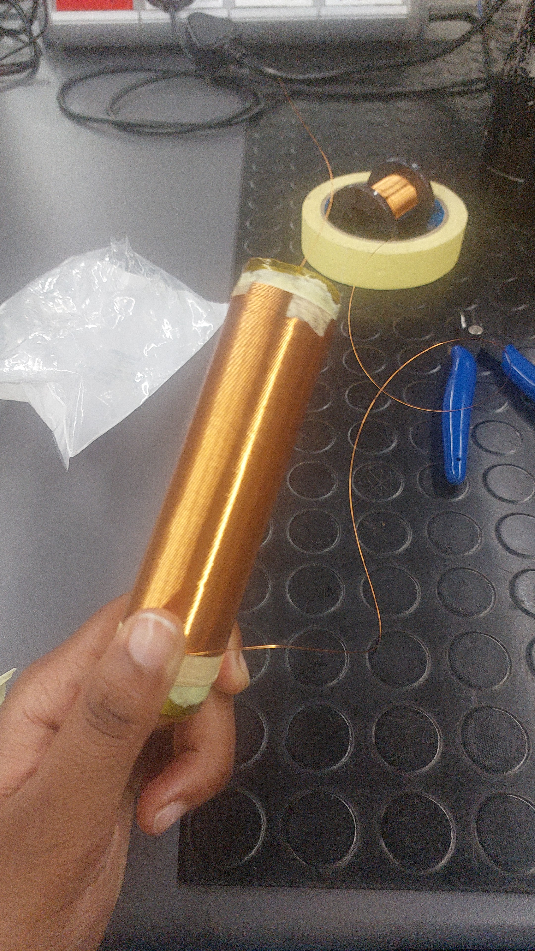
Lena's skripsie vlog/IMG-20260926-WA0049.jpeg
