LenaMatota/MechatronicsProject478/Lena's skripsie vlog/IMG-20260930-WA0003.jpeg

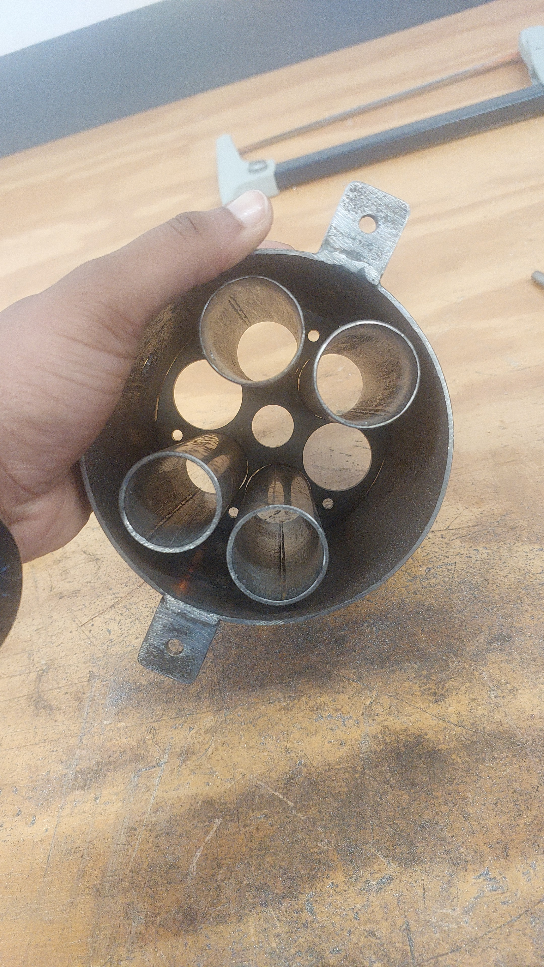
Lena's skripsie vlog/IMG-20260930-WA0003.jpeg
