LenaMatota/MechatronicsProject478/Lena's skripsie vlog/IMG-20261006-WA0004.jpeg

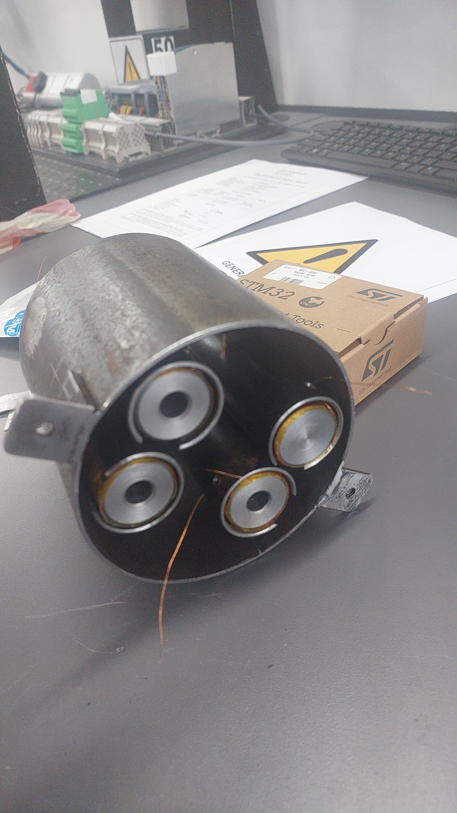
Lena's skripsie vlog/IMG-20261006-WA0004.jpeg
